quantrpeter/semiblock-junior/README.md

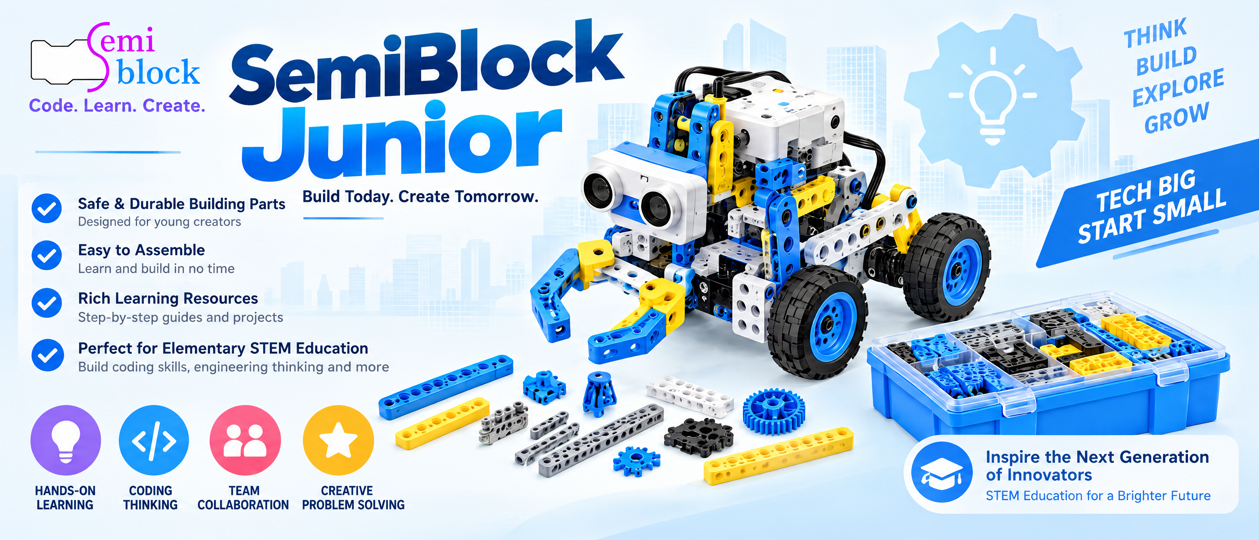
[picture p1: image/banner1.png]


Semiblock Junior is a mechanic Parts for students to build robotic devices using semiblock platform. This repo contains the idea to design the kit.
