quantrpeter/semiblock-junior/stage-2/drawings/SB-G36B.pdf

Material
材料

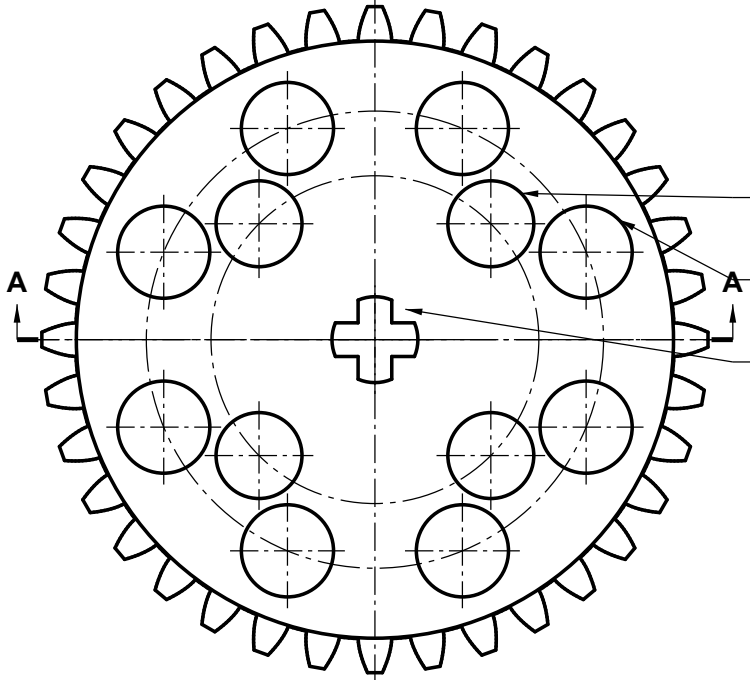
[picture p257: figure]

POM copolymer
POM 共聚甲醛

Weight
重量 | 3.82 g

Colour

颜色 | Dark grey 深灰 #5B636D | Qty / kit
每套数量 | 2
Finish 表面 | SPI B-2 光滑面 | Scale
比例 | 2.5:1

Unit

单位 | mm | Projection 投影
Status 状态 | Rev A quotation
报价及打样
| | Sheet
页 | 1 / 1

General tolerances 未注公差 (mm)
rigid ABS/POM 硬胶 | TPE 软胶
0 – 6 | ±0.05 | ±0.15 | A | First issue for quotation & samples 首次发布 · 报价及打样 | 2026-10-27
6 – 18 | ±0.08 | ±0.2
18 – 50 | ±0.12 | ±0.3 | Drawn 设计 | semiblock.ai | 2026-10-27
50 – 120 | ±0.2 | ±0.5
angles 角度 | ±0.5° | ±1°
| | | Checked 审核
◆ = critical dimension 关键尺寸
FAI 100%, Cpk ≥ 1.33

Rev
版本
Description 修改内容 | Date 日期

Approved
批准
semiblock.ai | SemiBlock Junior

Part No. 零件号

# SB-G36B

Name 名称

## Double-bevel gear 36T

## 双面锥齿轮 36齿

Dwg SB-G36B · Rev A · A3 · 3D: SB-G36B.step / .FCStd

3.9

### tip Ø37.6 ±0.05

A–A

### 8× Ø5.2 ±0.05 THRU 通孔 EQ. SP. on PCD Ø25.8 均布

### 4× Ø4.85 ±0.02 THRU 通孔 EQ. SP. on PCD Ø18.5 均布

### Axle hole 十字孔 +4.85 ±0.02 / 1.9 ±0.02 THRU 通孔 · see detail 见详图

### ISOMETRIC 轴测图 (2:1, ref.)

### Technical requirements 技术要求

1. 3D model SB-G36B.step is the master; dimensions not shown are taken from it.
以 3D 模型 SB-G36B.step 为准，未注尺寸按 3D 数据。
2. Material POM copolymer, e.g. Hostaform C 9021; colour Dark grey 深灰 (sRGB #5B 636D, std SB-C05); colour plaque approved before production.
材料：POM 共聚甲醛（C 9021 或同等）；颜色 深灰（#5B636D，色号 SB-C05），量产 前确认色板。
3. Draft ≤ 0.5° on outer walls, added by the tool maker within tolerance. Pin /
axle holes and ◆ features: draft ≤ 0.25°, ◆ size held over the full depth. 外壁拔模≤0.5°（模具厂在公差内添加）；销孔、十字孔及◆特征拔模≤0.25°，全深度保 持◆尺寸。
4. Parting line, gate and ejector marks: not on visible faces or inside holes,
flush to +0.05. Positions to be agreed in DFM.
分模线、浇口、顶针痕不得在外观面及孔内，凸起≤0.05，位置于 DFM 时确认。
5. No flash > 0.05, sink marks, short shots, silver streaks or voids. Holes free of burrs.
无大于0.05的披锋，无缩水、缺料、银纹、气泡；孔内无毛刺。
6. Unspecified edge radii R0.2–R0.35 as in 3D. No sharp edges or points (toy
safety).
未注圆角 R0.2–R0.35（按 3D），不得有锐边锐角（玩具安全）。
7. Pin holes: GO Ø4.83 / NO-GO Ø4.88 plug gauge. Fit test with SemiBlock and LEGO® Technic™ pins; push-in / pull-out force agreed at T1.
销孔用 Ø4.83 通规 / Ø4.88 止规检验；与 SemiBlock 及乐高销做装配测试，插拔力于 T 1 确认。
8. Axle (+) holes: GO gauge = cross 4.83 / 1.88. Standard axle must slide in by hand without play > 0.05.
十字孔用 4.83/1.88 十字通规；标准十字轴可手推插入，间隙≤0.05。
9. Mark cavity number and material code >POM< on a hidden face where space allows (ISO 11469).
在不可见面标注穴号及材料代码 >POM<（ISO 11469），空间不足可省略。
10. Toy safety: EN 71-1/-2/-3, ASTM F963, GB 6675.1–.4; RoHS and REACH. Supply material certificates.
玩具安全：EN 71-1/-2/-3、ASTM F963、GB 6675.1–.4；符合 RoHS、REACH，提供材 料证明。
11. ◆ = critical dimension: FAI report on every ◆ at T1 (5 pcs per cavity);
production Cpk ≥ 1.33.
◆为关键尺寸：T1 每穴 5 件全尺寸首件报告；量产 Cpk≥1.33。
12. Stage-2 drawings are for quotation, DFM review and T0/T1 samples. No mass production before written sample approval.

Gear data 齿轮参数
Module 模数 m | 1
Teeth 齿数 z | 36
Pressure angle 压力角 | 20°
Pitch Ø 分度圆 | 36
Tip Ø 齿顶圆 | 37.6
Root Ø 齿根圆 | 33.8
Tooth thickness 齿厚 | 1.47 (backlash 侧隙 0.1)
Profile 齿形 | involute, addendum 0.8m 渐开线
Bevel 锥面 | 45° double cone trim 双面45°
Accuracy 精度 | ISO 1328-1 grade 10 (proposed)

4.85 ±0.02

1.9 ±0.02

## Axle hole 十字孔 (10:1)
