quantrpeter/semiblock-junior/stage-1/renders/semikey.png

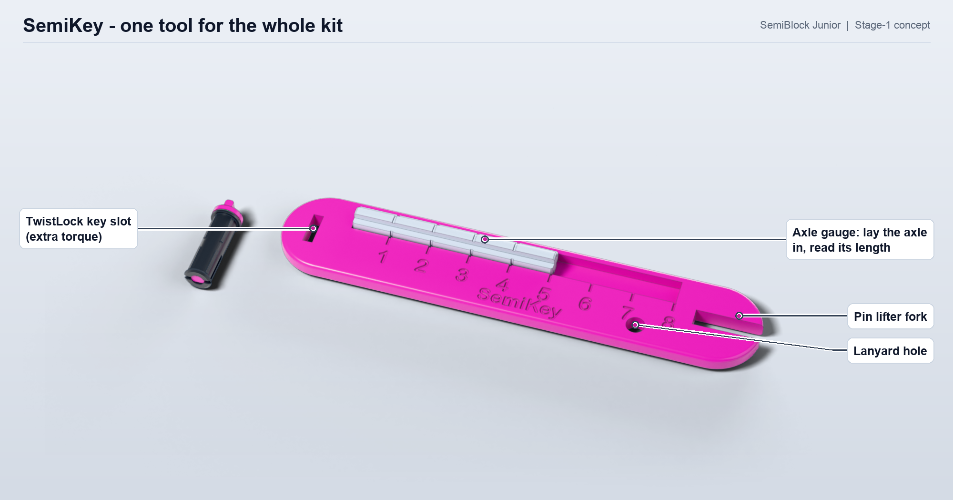
stage-1/renders/semikey.png
