quantrpeter/semiblock-junior/stage-1/renders/sheets/accessories-tools.png

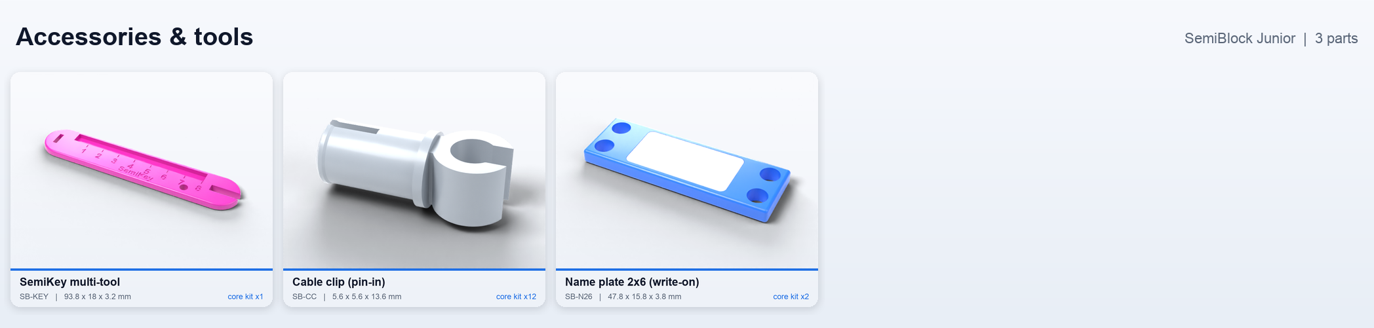
stage-1/renders/sheets/accessories-tools.png
