quantrpeter/semiblock-junior/stage-1/renders/sheets/axles.png

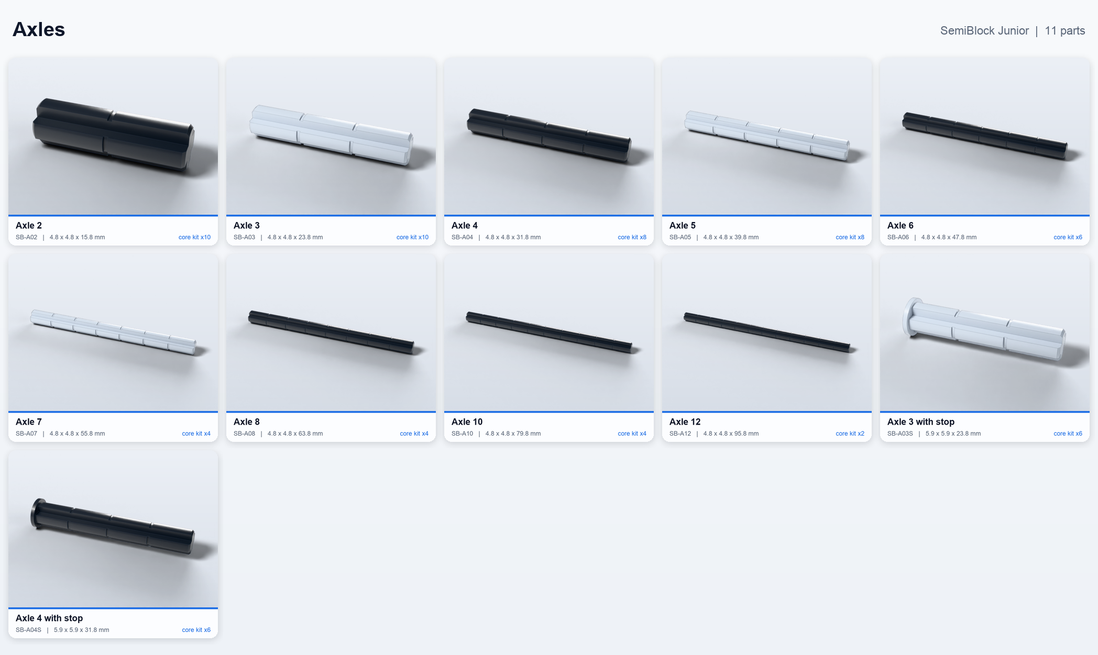
stage-1/renders/sheets/axles.png
