quantrpeter/semiblock-junior/stage-1/renders/sheets/beams.png

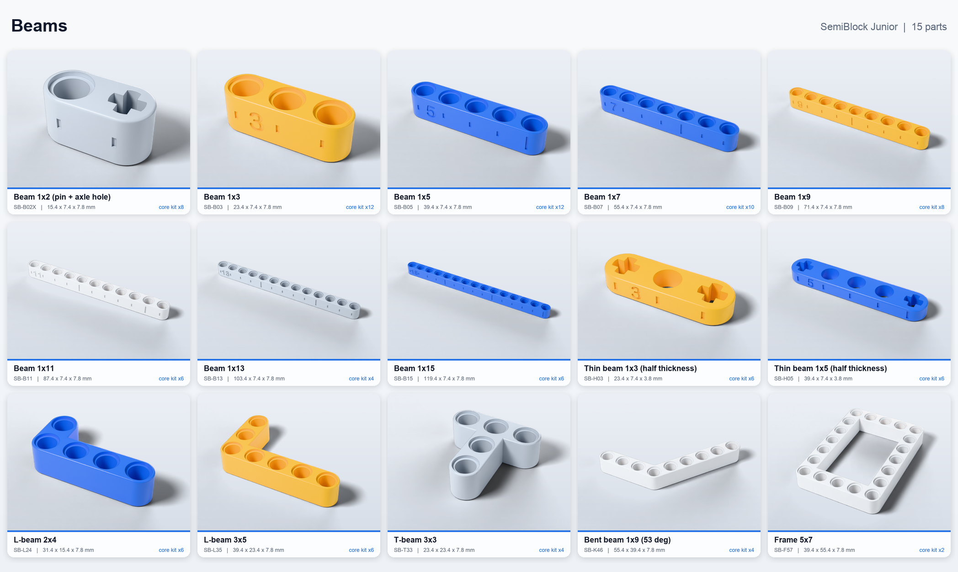
stage-1/renders/sheets/beams.png
