quantrpeter/semiblock-junior/stage-1/renders/sheets/connectors.png

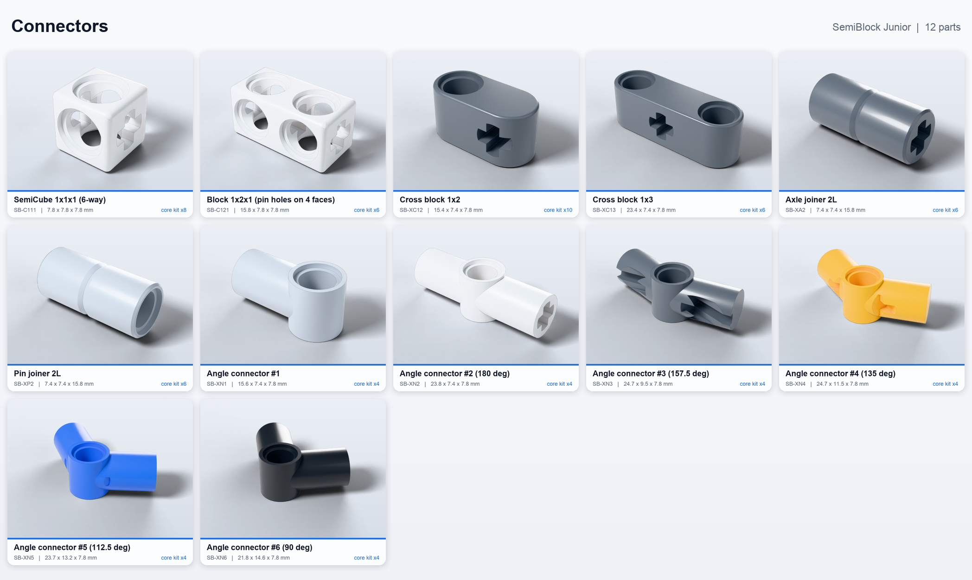
stage-1/renders/sheets/connectors.png
