quantrpeter/semiblock-junior/stage-1/renders/sheets/gears-motion.png

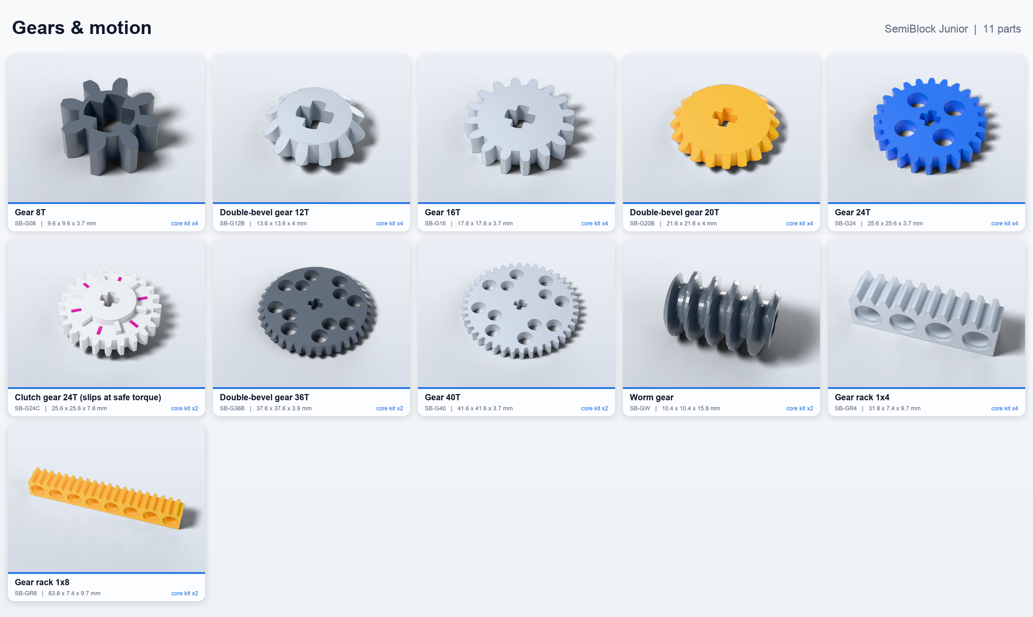
stage-1/renders/sheets/gears-motion.png
