quantrpeter/semiblock-junior/stage-1/renders/sheets/hub-motors-cables.png

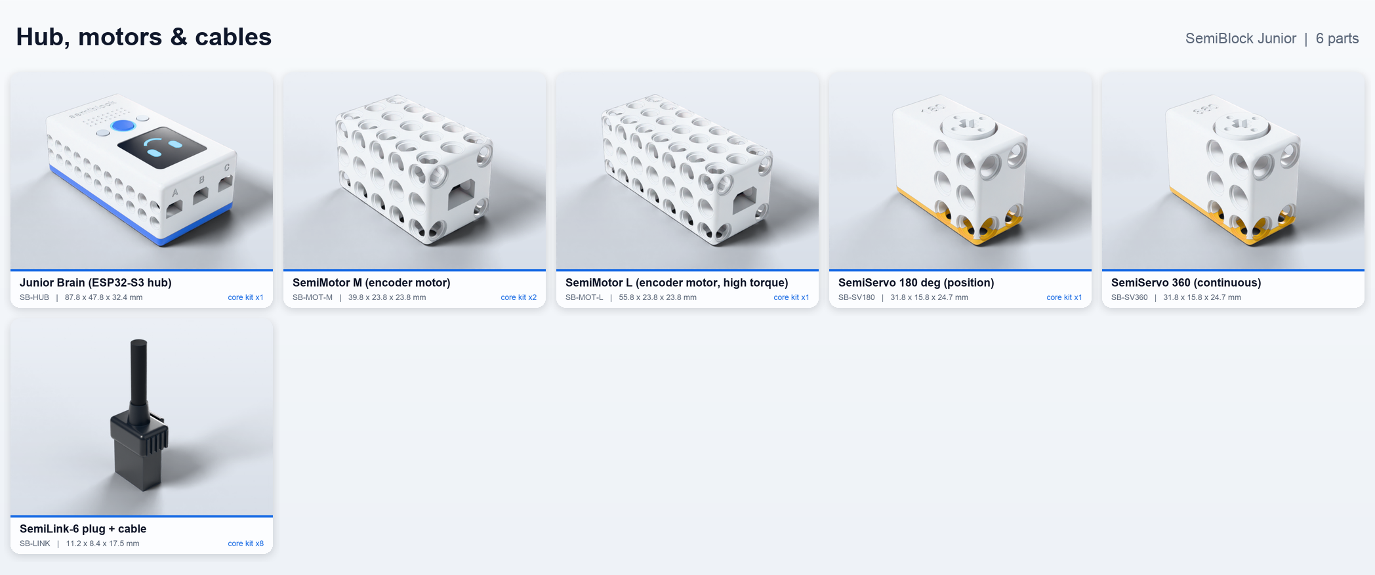
stage-1/renders/sheets/hub-motors-cables.png
