quantrpeter/semiblock-junior/stage-1/renders/sheets/modules-ai-voice.png

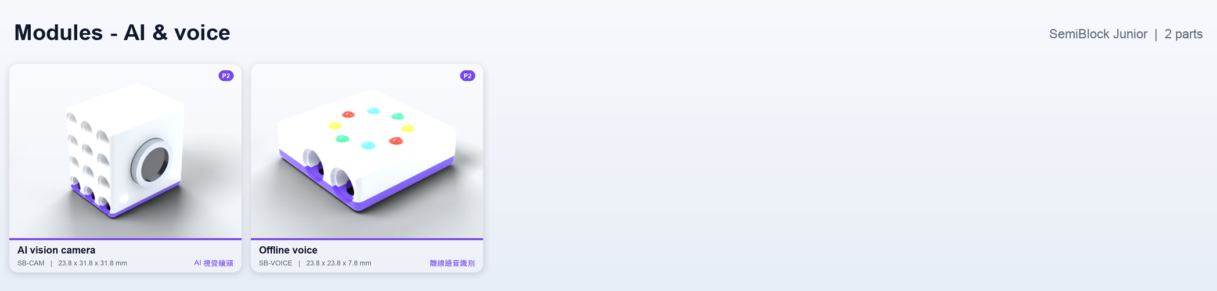
stage-1/renders/sheets/modules-ai-voice.png
