quantrpeter/semiblock-junior/stage-1/renders/sheets/modules-environment-science.png

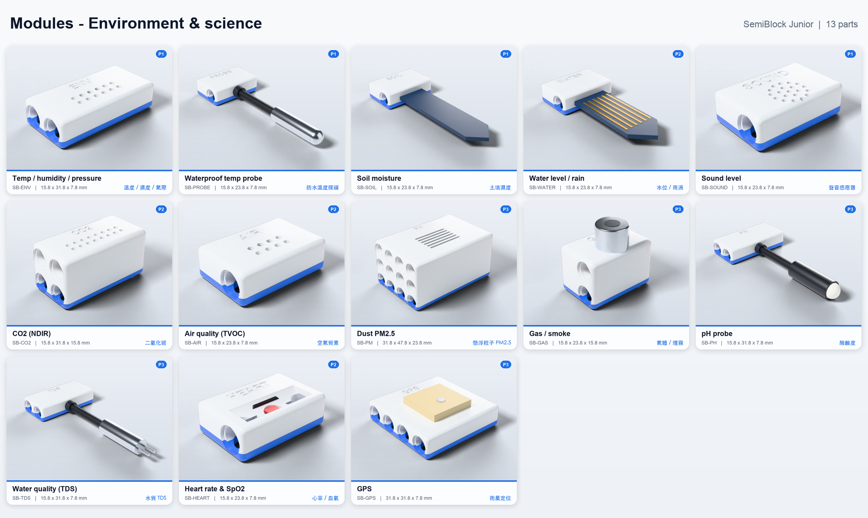
stage-1/renders/sheets/modules-environment-science.png
