quantrpeter/semiblock-junior/stage-1/renders/sheets/modules-identify-connect.png

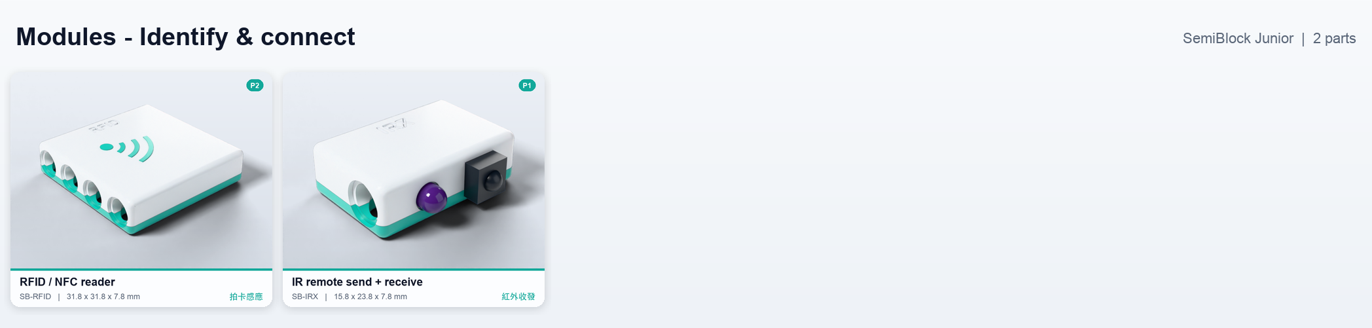
stage-1/renders/sheets/modules-identify-connect.png
