quantrpeter/semiblock-junior/stage-1/renders/sheets/modules-output.png

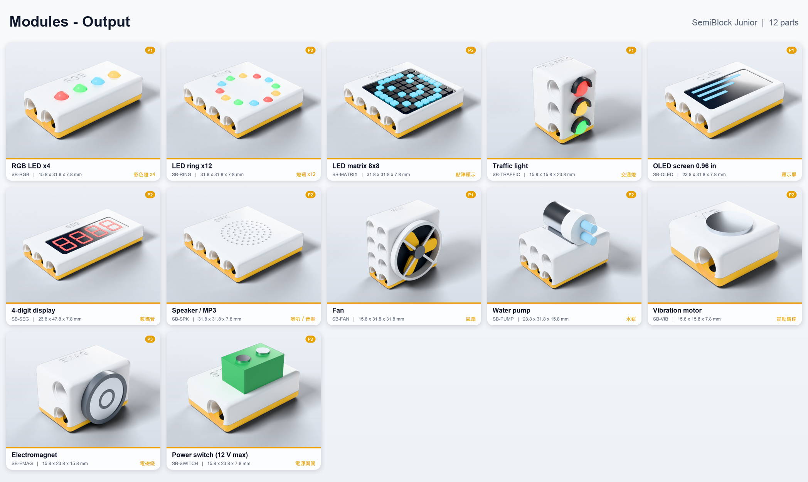
stage-1/renders/sheets/modules-output.png
