quantrpeter/semiblock-junior/stage-1/renders/sheets/modules-power-energy.png

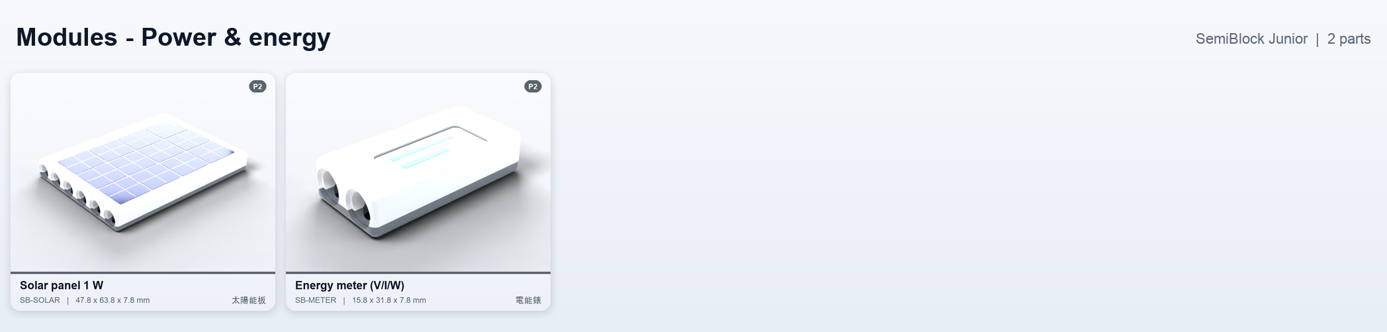
stage-1/renders/sheets/modules-power-energy.png
