quantrpeter/semiblock-junior/stage-1/renders/sheets/modules-sensing.png

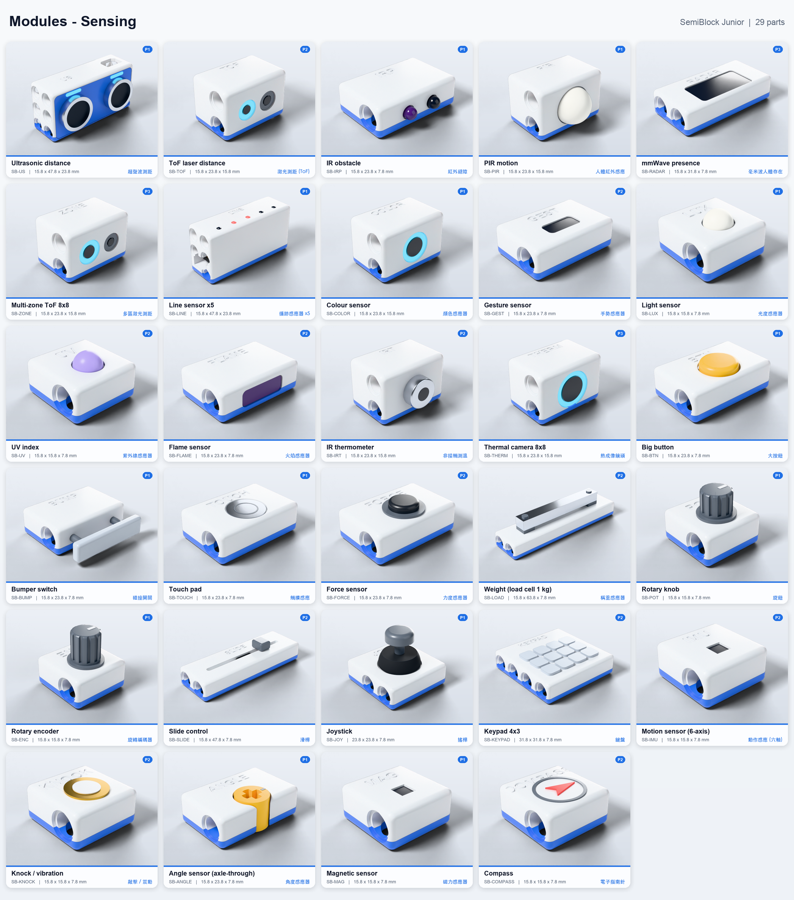
stage-1/renders/sheets/modules-sensing.png
