quantrpeter/semiblock-junior/stage-1/renders/sheets/pins-bushes.png

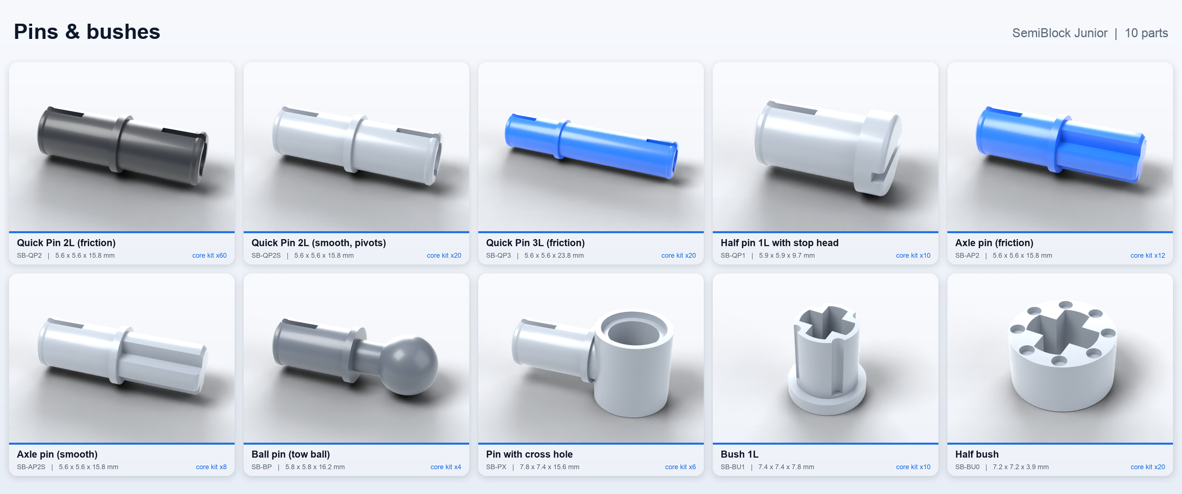
stage-1/renders/sheets/pins-bushes.png
