quantrpeter/semiblock-junior/stage-1/renders/sheets/twistlock-lock-system.png

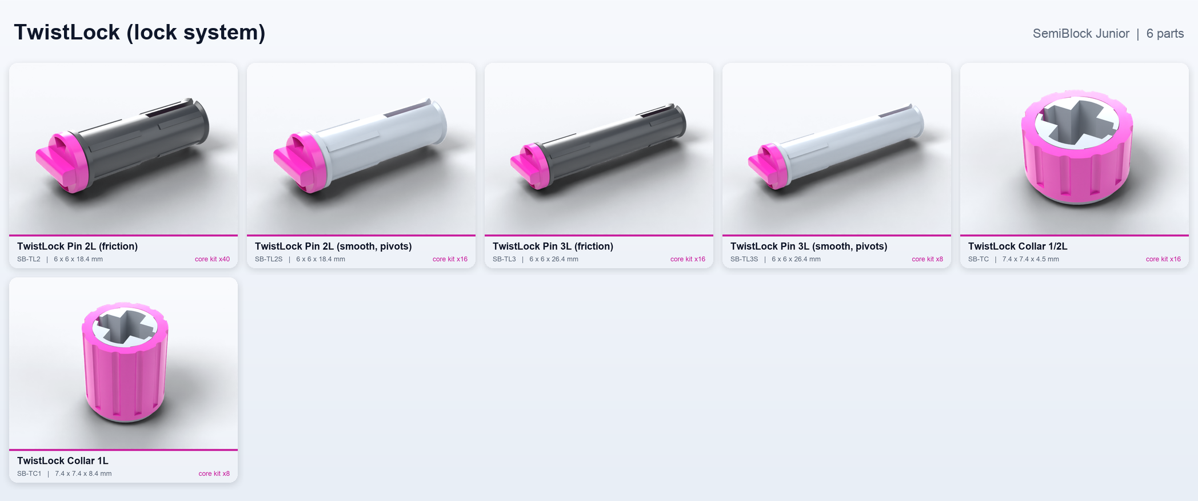
stage-1/renders/sheets/twistlock-lock-system.png
