quantrpeter/semiblock-junior/stage-1/renders/sheets/wheels.png

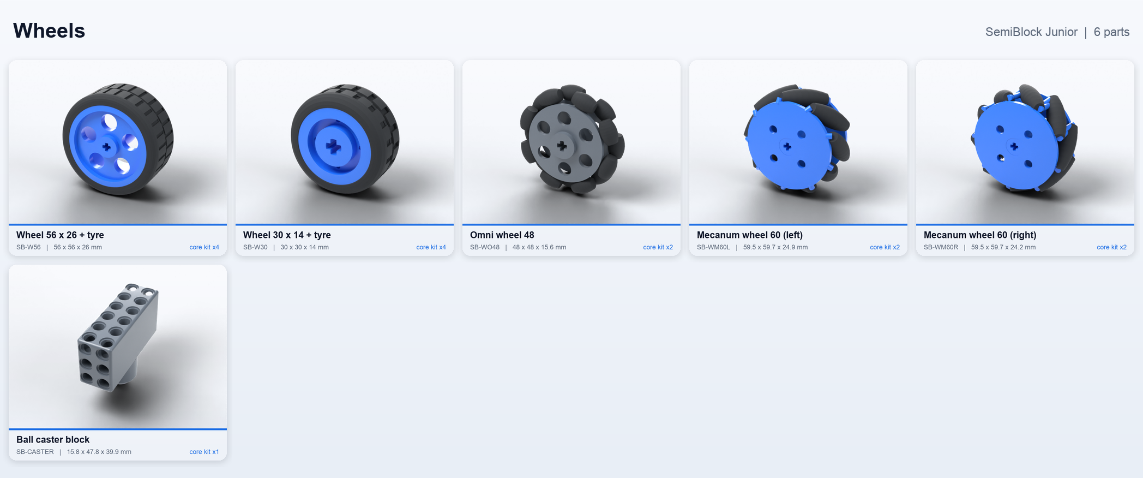
stage-1/renders/sheets/wheels.png
