quantrpeter/semiblock-junior/stage-2/renders/sheets/accessories-tools.png

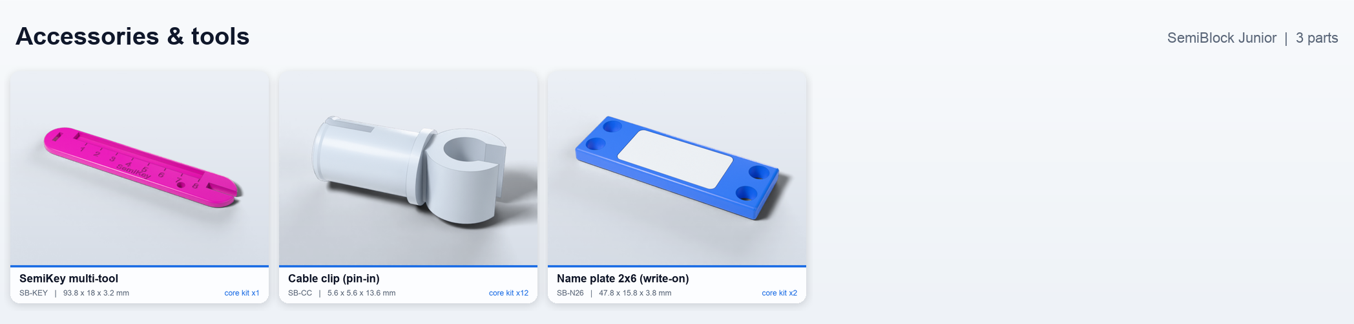
stage-2/renders/sheets/accessories-tools.png
