quantrpeter/semiblock-junior/stage-2/renders/sheets/bearings.png

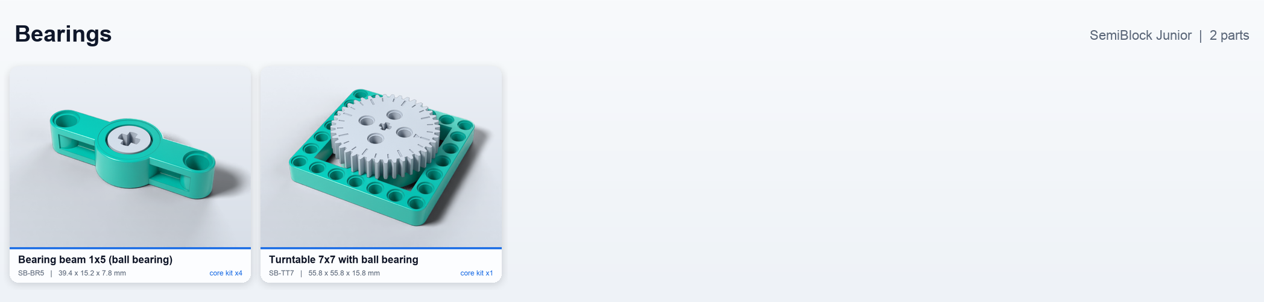
stage-2/renders/sheets/bearings.png
