quantrpeter/semiblock-junior/stage-2/renders/sheets/connectors.png

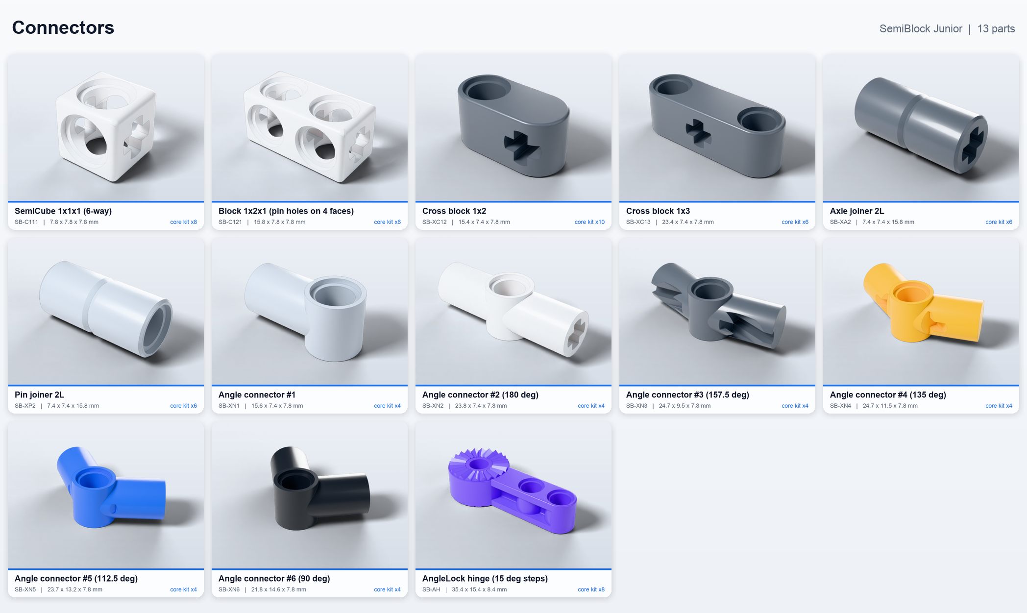
stage-2/renders/sheets/connectors.png
