quantrpeter/semiblock-junior/stage-2/renders/sheets/h-beams.png

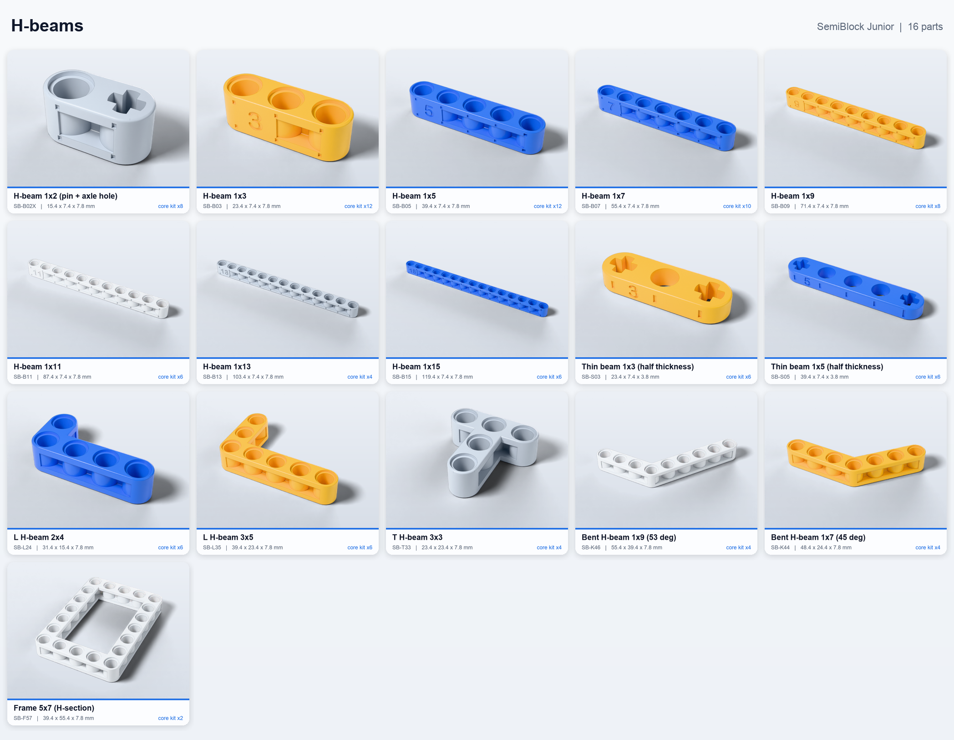
stage-2/renders/sheets/h-beams.png
