quantrpeter/semiblock-junior/stage-2/renders/sheets/modules-ai-voice.png

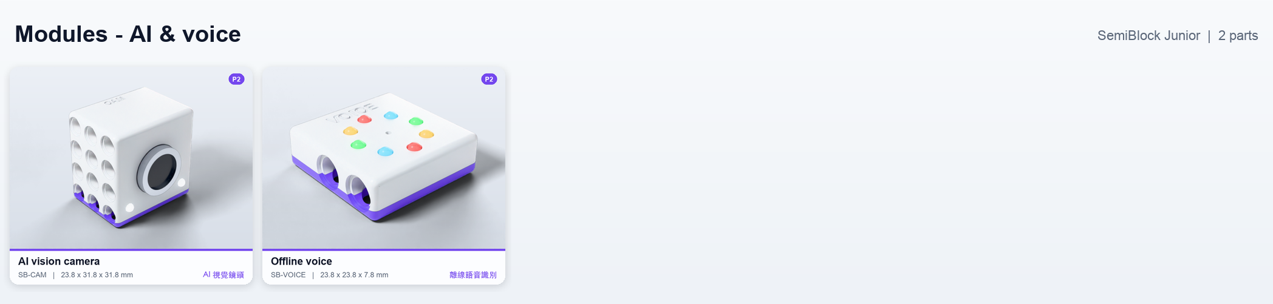
stage-2/renders/sheets/modules-ai-voice.png
