quantrpeter/semiblock-junior/stage-2/renders/sheets/modules-power-energy.png

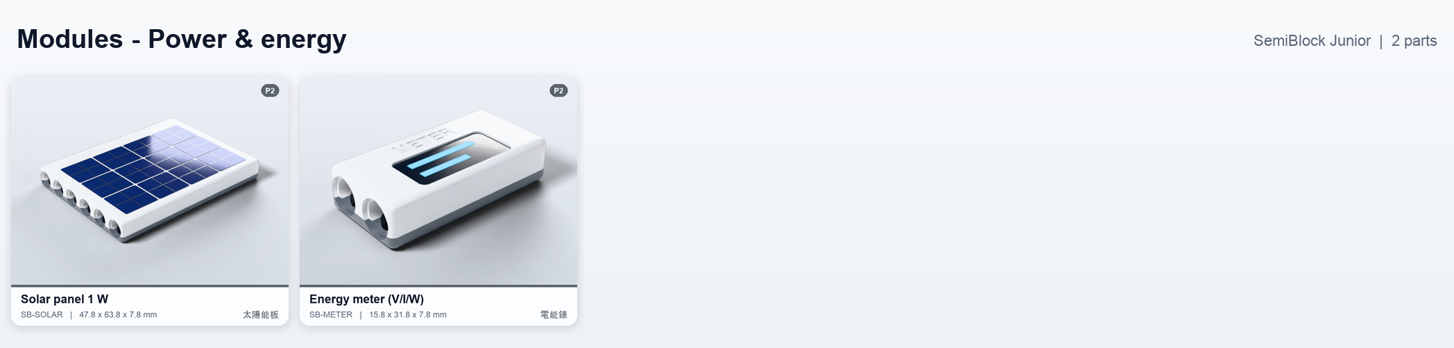
stage-2/renders/sheets/modules-power-energy.png
