quantrpeter/semiblock-junior/stage-2/renders/sheets/pins-bushes.png

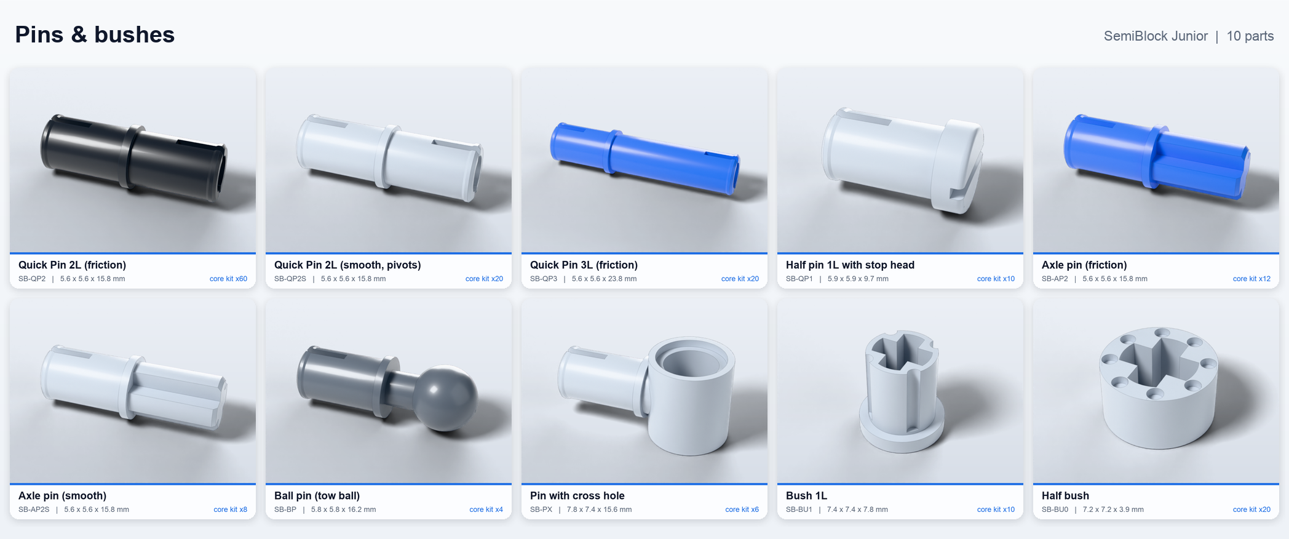
stage-2/renders/sheets/pins-bushes.png
