quantrpeter/semiblock-junior/stage-2/renders/sheets/twistlock-lock-system.png

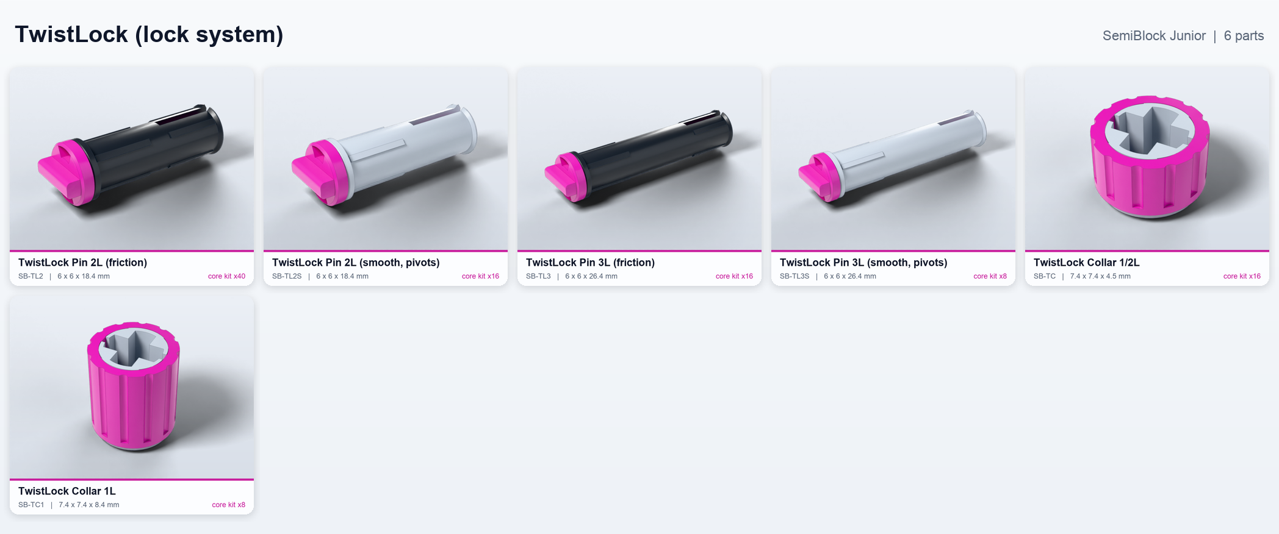
stage-2/renders/sheets/twistlock-lock-system.png
