quantrpeter/semiblock-junior/stage-2/renders/sheets/wheels.png

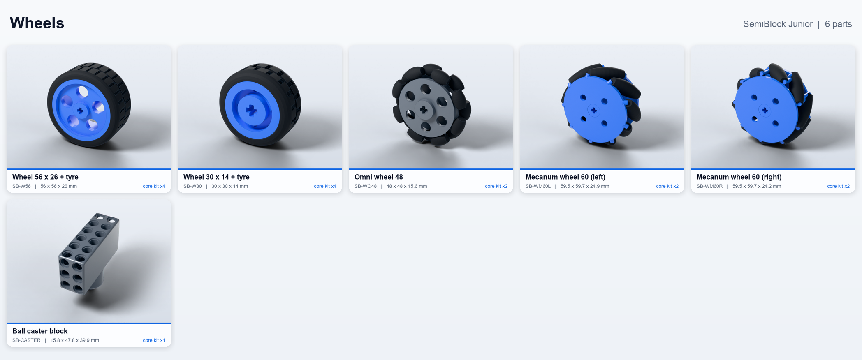
stage-2/renders/sheets/wheels.png
