quantrpeter/semiblock-junior/stage-2/drawings/SemiBlock-Junior-parts-list.csv

Part No. 零件号 | Component No. 零件编号 | Name | 名称 | Type 类型 | Material 材料 | Colour 颜色 | Colour std 色号 | Finish 表面 | Weight g 重量 | Qty per Core kit 每套数量 | Drawing 图纸 | 3D STEP | FreeCAD
SB-B02X | SB-B02X | H-beam 1x2 (pin + axle hole) | 工字孔梁 1×2（圆孔+十字孔） | injection moulded | ABS, e.g. CHIMEI PA-757 or equiv. | Light grey 浅灰 #B4BCC6 | SB-C04 | VDI 3400 Ref 18 细哑光纹理 | 0.46 | 8 | drawings/SB-B02X.pdf | cad/step/SB-B02X.step | cad/fcstd/SB-B02X.FCStd
SB-B03 | SB-B03 | H-beam 1x3 | 工字孔梁 1×3 | injection moulded | ABS, e.g. CHIMEI PA-757 or equiv. | Yellow 黄 #FFC21A | SB-C02 | VDI 3400 Ref 18 细哑光纹理 | 0.72 | 12 | drawings/SB-B03.pdf | cad/step/SB-B03.step | cad/fcstd/SB-B03.FCStd
SB-B05 | SB-B05 | H-beam 1x5 | 工字孔梁 1×5 | injection moulded | ABS, e.g. CHIMEI PA-757 or equiv. | Blue 蓝 #1F6FE5 | SB-C01 | VDI 3400 Ref 18 细哑光纹理 | 1.16 | 12 | drawings/SB-B05.pdf | cad/step/SB-B05.step | cad/fcstd/SB-B05.FCStd
SB-B07 | SB-B07 | H-beam 1x7 | 工字孔梁 1×7 | injection moulded | ABS, e.g. CHIMEI PA-757 or equiv. | Blue 蓝 #1F6FE5 | SB-C01 | VDI 3400 Ref 18 细哑光纹理 | 1.61 | 10 | drawings/SB-B07.pdf | cad/step/SB-B07.step | cad/fcstd/SB-B07.FCStd
SB-B09 | SB-B09 | H-beam 1x9 | 工字孔梁 1×9 | injection moulded | ABS, e.g. CHIMEI PA-757 or equiv. | Yellow 黄 #FFC21A | SB-C02 | VDI 3400 Ref 18 细哑光纹理 | 2.05 | 8 | drawings/SB-B09.pdf | cad/step/SB-B09.step | cad/fcstd/SB-B09.FCStd
SB-B11 | SB-B11 | H-beam 1x11 | 工字孔梁 1×11 | injection moulded | ABS, e.g. CHIMEI PA-757 or equiv. | White 白 #F2F4F7 | SB-C03 | VDI 3400 Ref 18 细哑光纹理 | 2.50 | 6 | drawings/SB-B11.pdf | cad/step/SB-B11.step | cad/fcstd/SB-B11.FCStd
SB-B13 | SB-B13 | H-beam 1x13 | 工字孔梁 1×13 | injection moulded | ABS, e.g. CHIMEI PA-757 or equiv. | Light grey 浅灰 #B4BCC6 | SB-C04 | VDI 3400 Ref 18 细哑光纹理 | 2.95 | 4 | drawings/SB-B13.pdf | cad/step/SB-B13.step | cad/fcstd/SB-B13.FCStd
SB-B15 | SB-B15 | H-beam 1x15 | 工字孔梁 1×15 | injection moulded | ABS, e.g. CHIMEI PA-757 or equiv. | Blue 蓝 #1F6FE5 | SB-C01 | VDI 3400 Ref 18 细哑光纹理 | 3.39 | 6 | drawings/SB-B15.pdf | cad/step/SB-B15.step | cad/fcstd/SB-B15.FCStd
SB-S03 | SB-S03 | Thin beam 1x3 (half thickness) | 薄孔梁 1×3（半厚） | injection moulded | ABS, e.g. CHIMEI PA-757 or equiv. | Yellow 黄 #FFC21A | SB-C02 | VDI 3400 Ref 18 细哑光纹理 | 0.45 | 6 | drawings/SB-S03.pdf | cad/step/SB-S03.step | cad/fcstd/SB-S03.FCStd
SB-S05 | SB-S05 | Thin beam 1x5 (half thickness) | 薄孔梁 1×5（半厚） | injection moulded | ABS, e.g. CHIMEI PA-757 or equiv. | Blue 蓝 #1F6FE5 | SB-C01 | VDI 3400 Ref 18 细哑光纹理 | 0.77 | 6 | drawings/SB-S05.pdf | cad/step/SB-S05.step | cad/fcstd/SB-S05.FCStd
SB-L24 | SB-L24 | L H-beam 2x4 | L形工字孔梁 2×4 | injection moulded | ABS, e.g. CHIMEI PA-757 or equiv. | Blue 蓝 #1F6FE5 | SB-C01 | VDI 3400 Ref 18 细哑光纹理 | 1.07 | 6 | drawings/SB-L24.pdf | cad/step/SB-L24.step | cad/fcstd/SB-L24.FCStd
SB-L35 | SB-L35 | L H-beam 3x5 | L形工字孔梁 3×5 | injection moulded | ABS, e.g. CHIMEI PA-757 or equiv. | Yellow 黄 #FFC21A | SB-C02 | VDI 3400 Ref 18 细哑光纹理 | 1.52 | 6 | drawings/SB-L35.pdf | cad/step/SB-L35.step | cad/fcstd/SB-L35.FCStd
SB-T33 | SB-T33 | T H-beam 3x3 | T形工字孔梁 3×3 | injection moulded | ABS, e.g. CHIMEI PA-757 or equiv. | Light grey 浅灰 #B4BCC6 | SB-C04 | VDI 3400 Ref 18 细哑光纹理 | 1.07 | 4 | drawings/SB-T33.pdf | cad/step/SB-T33.step | cad/fcstd/SB-T33.FCStd
SB-K46 | SB-K46 | Bent H-beam 1x9 (53 deg) | 弯工字孔梁 1×9（53°） | injection moulded | ABS, e.g. CHIMEI PA-757 or equiv. | White 白 #F2F4F7 | SB-C03 | VDI 3400 Ref 18 细哑光纹理 | 1.98 | 4 | drawings/SB-K46.pdf | cad/step/SB-K46.step | cad/fcstd/SB-K46.FCStd
SB-K44 | SB-K44 | Bent H-beam 1x7 (45 deg) | 弯工字孔梁 1×7（45°） | injection moulded | ABS, e.g. CHIMEI PA-757 or equiv. | Yellow 黄 #FFC21A | SB-C02 | VDI 3400 Ref 18 细哑光纹理 | 1.53 | 4 | drawings/SB-K44.pdf | cad/step/SB-K44.step | cad/fcstd/SB-K44.FCStd
SB-F57 | SB-F57 | Frame 5x7 (H-section) | 工字截面框架 5×7 | injection moulded | ABS, e.g. CHIMEI PA-757 or equiv. | White 白 #F2F4F7 | SB-C03 | VDI 3400 Ref 18 细哑光纹理 | 4.46 | 2 | drawings/SB-F57.pdf | cad/step/SB-F57.step | cad/fcstd/SB-F57.FCStd
SB-C111 | SB-C111 | SemiCube 1x1x1 (6-way) | 六向连接块 1×1×1 | injection moulded | ABS, e.g. CHIMEI PA-757 or equiv. | White 白 #F2F4F7 | SB-C03 | VDI 3400 Ref 18 细哑光纹理 | 0.19 | 8 | drawings/SB-C111.pdf | cad/step/SB-C111.step | cad/fcstd/SB-C111.FCStd
SB-C121 | SB-C121 | Block 1x2x1 (pin holes on 4 faces) | 连接块 1×2×1（四面销孔） | injection moulded | ABS, e.g. CHIMEI PA-757 or equiv. | White 白 #F2F4F7 | SB-C03 | VDI 3400 Ref 18 细哑光纹理 | 0.39 | 6 | drawings/SB-C121.pdf | cad/step/SB-C121.step | cad/fcstd/SB-C121.FCStd
SB-XC12 | SB-XC12 | Cross block 1x2 | 十字连接块 1×2 | injection moulded | ABS, e.g. CHIMEI PA-757 or equiv. | Dark grey 深灰 #5B636D | SB-C05 | VDI 3400 Ref 18 细哑光纹理 | 0.56 | 10 | drawings/SB-XC12.pdf | cad/step/SB-XC12.step | cad/fcstd/SB-XC12.FCStd
SB-XC13 | SB-XC13 | Cross block 1x3 | 十字连接块 1×3 | injection moulded | ABS, e.g. CHIMEI PA-757 or equiv. | Dark grey 深灰 #5B636D | SB-C05 | VDI 3400 Ref 18 细哑光纹理 | 0.87 | 6 | drawings/SB-XC13.pdf | cad/step/SB-XC13.step | cad/fcstd/SB-XC13.FCStd
SB-XA2 | SB-XA2 | Axle joiner 2L | 轴连接器 2L | injection moulded | ABS, e.g. CHIMEI PA-757 or equiv. | Dark grey 深灰 #5B636D | SB-C05 | VDI 3400 Ref 18 细哑光纹理 | 0.46 | 6 | drawings/SB-XA2.pdf | cad/step/SB-XA2.step | cad/fcstd/SB-XA2.FCStd
SB-XP2 | SB-XP2 | Pin joiner 2L | 销连接器 2L | injection moulded | ABS, e.g. CHIMEI PA-757 or equiv. | Light grey 浅灰 #B4BCC6 | SB-C04 | VDI 3400 Ref 18 细哑光纹理 | 0.38 | 6 | drawings/SB-XP2.pdf | cad/step/SB-XP2.step | cad/fcstd/SB-XP2.FCStd
SB-XN1 | SB-XN1 | Angle connector #1 | 角度连接器 #1 | injection moulded | ABS, e.g. CHIMEI PA-757 or equiv. | Light grey 浅灰 #B4BCC6 | SB-C04 | VDI 3400 Ref 18 细哑光纹理 | 0.53 | 4 | drawings/SB-XN1.pdf | cad/step/SB-XN1.step | cad/fcstd/SB-XN1.FCStd
SB-XN2 | SB-XN2 | Angle connector #2 (180 deg) | 角度连接器 #2（180°） | injection moulded | ABS, e.g. CHIMEI PA-757 or equiv. | White 白 #F2F4F7 | SB-C03 | VDI 3400 Ref 18 细哑光纹理 | 0.66 | 4 | drawings/SB-XN2.pdf | cad/step/SB-XN2.step | cad/fcstd/SB-XN2.FCStd
SB-XN3 | SB-XN3 | Angle connector #3 (157.5 deg) | 角度连接器 #3（157.5°） | injection moulded | ABS, e.g. CHIMEI PA-757 or equiv. | Dark grey 深灰 #5B636D | SB-C05 | VDI 3400 Ref 18 细哑光纹理 | 0.76 | 4 | drawings/SB-XN3.pdf | cad/step/SB-XN3.step | cad/fcstd/SB-XN3.FCStd
SB-XN4 | SB-XN4 | Angle connector #4 (135 deg) | 角度连接器 #4（135°） | injection moulded | ABS, e.g. CHIMEI PA-757 or equiv. | Yellow 黄 #FFC21A | SB-C02 | VDI 3400 Ref 18 细哑光纹理 | 0.87 | 4 | drawings/SB-XN4.pdf | cad/step/SB-XN4.step | cad/fcstd/SB-XN4.FCStd
SB-XN5 | SB-XN5 | Angle connector #5 (112.5 deg) | 角度连接器 #5（112.5°） | injection moulded | ABS, e.g. CHIMEI PA-757 or equiv. | Blue 蓝 #1F6FE5 | SB-C01 | VDI 3400 Ref 18 细哑光纹理 | 0.88 | 4 | drawings/SB-XN5.pdf | cad/step/SB-XN5.step | cad/fcstd/SB-XN5.FCStd
SB-XN6 | SB-XN6 | Angle connector #6 (90 deg) | 角度连接器 #6（90°） | injection moulded | ABS, e.g. CHIMEI PA-757 or equiv. | Black 黑 #24282E | SB-C06 | VDI 3400 Ref 18 细哑光纹理 | 0.88 | 4 | drawings/SB-XN6.pdf | cad/step/SB-XN6.step | cad/fcstd/SB-XN6.FCStd
SB-AH | SB-AH | AngleLock hinge (15 deg steps) | 角度铰链（15° 分度） | injection moulded | POM copolymer, e.g. Hostaform C 9021 | Violet 紫 #7447EE | SB-C09 | SPI B-2 光滑面 | 2.62 | 8 | drawings/SB-AH.pdf | cad/step/SB-AH.step | cad/fcstd/SB-AH.FCStd
SB-QP2 | SB-QP2 | Quick Pin 2L (friction) | 摩擦销 2L | injection moulded | POM copolymer, e.g. Hostaform C 9021 | Black 黑 #24282E | SB-C06 | SPI B-2 光滑面 | 0.23 | 60 | drawings/SB-QP2.pdf | cad/step/SB-QP2.step | cad/fcstd/SB-QP2.FCStd
SB-QP2S | SB-QP2S | Quick Pin 2L (smooth, pivots) | 光滑销 2L（可转动） | injection moulded | POM copolymer, e.g. Hostaform C 9021 | Light grey 浅灰 #B4BCC6 | SB-C04 | SPI B-2 光滑面 | 0.23 | 20 | drawings/SB-QP2S.pdf | cad/step/SB-QP2S.step | cad/fcstd/SB-QP2S.FCStd
SB-QP3 | SB-QP3 | Quick Pin 3L (friction) | 摩擦销 3L | injection moulded | POM copolymer, e.g. Hostaform C 9021 | Blue 蓝 #1F6FE5 | SB-C01 | SPI B-2 光滑面 | 0.35 | 20 | drawings/SB-QP3.pdf | cad/step/SB-QP3.step | cad/fcstd/SB-QP3.FCStd
SB-QP1 | SB-QP1 | Half pin 1L with stop head | 半销 1L（带挡头） | injection moulded | POM copolymer, e.g. Hostaform C 9021 | Light grey 浅灰 #B4BCC6 | SB-C04 | SPI B-2 光滑面 | 0.17 | 10 | drawings/SB-QP1.pdf | cad/step/SB-QP1.step | cad/fcstd/SB-QP1.FCStd
SB-AP2 | SB-AP2 | Axle pin (friction) | 轴销（摩擦） | injection moulded | POM copolymer, e.g. Hostaform C 9021 | Blue 蓝 #1F6FE5 | SB-C01 | SPI B-2 光滑面 | 0.28 | 12 | drawings/SB-AP2.pdf | cad/step/SB-AP2.step | cad/fcstd/SB-AP2.FCStd
SB-AP2S | SB-AP2S | Axle pin (smooth) | 轴销（光滑） | injection moulded | POM copolymer, e.g. Hostaform C 9021 | Light grey 浅灰 #B4BCC6 | SB-C04 | SPI B-2 光滑面 | 0.28 | 8 | drawings/SB-AP2S.pdf | cad/step/SB-AP2S.step | cad/fcstd/SB-AP2S.FCStd
SB-BP | SB-BP | Ball pin (tow ball) | 球头销（拖车球） | injection moulded | POM copolymer, e.g. Hostaform C 9021 | Dark grey 深灰 #5B636D | SB-C05 | SPI B-2 光滑面 | 0.31 | 4 | drawings/SB-BP.pdf | cad/step/SB-BP.step | cad/fcstd/SB-BP.FCStd
SB-PX | SB-PX | Pin with cross hole | 带十字孔销 | injection moulded | POM copolymer, e.g. Hostaform C 9021 | Light grey 浅灰 #B4BCC6 | SB-C04 | SPI B-2 光滑面 | 0.38 | 6 | drawings/SB-PX.pdf | cad/step/SB-PX.step | cad/fcstd/SB-PX.FCStd
SB-BU1 | SB-BU1 | Bush 1L | 轴套 1L | injection moulded | POM copolymer, e.g. Hostaform C 9021 | Light grey 浅灰 #B4BCC6 | SB-C04 | SPI B-2 光滑面 | 0.15 | 10 | drawings/SB-BU1.pdf | cad/step/SB-BU1.step | cad/fcstd/SB-BU1.FCStd
SB-BU0 | SB-BU0 | Half bush | 半轴套 | injection moulded | POM copolymer, e.g. Hostaform C 9021 | Light grey 浅灰 #B4BCC6 | SB-C04 | SPI B-2 光滑面 | 0.14 | 20 | drawings/SB-BU0.pdf | cad/step/SB-BU0.step | cad/fcstd/SB-BU0.FCStd
SB-TL2 | SB-TL2-01 | TwistLock Pin 2L (friction) — Sleeve | 旋锁销 2L（摩擦） — 套管 | injection moulded | POM copolymer, e.g. Hostaform C 9021 | Black 黑 #24282E | SB-C06 | SPI B-2 光滑面 | 0.28 | 40 | drawings/SB-TL2.pdf | cad/step/SB-TL2.step | cad/fcstd/SB-TL2.FCStd
SB-TL2 | SB-TL2-02 | TwistLock Pin 2L (friction) — Core | 旋锁销 2L（摩擦） — 锁芯 | injection moulded | POM copolymer, e.g. Hostaform C 9021 | Magenta 品红 #C8209E | SB-C07 | SPI B-2 光滑面 | 0.16 | 40 | drawings/SB-TL2.pdf | cad/step/SB-TL2.step | cad/fcstd/SB-TL2.FCStd
SB-TL2S | SB-TL2S-01 | TwistLock Pin 2L (smooth, pivots) — Sleeve | 旋锁销 2L（光滑，可转动） — 套管 | injection moulded | POM copolymer, e.g. Hostaform C 9021 | Light grey 浅灰 #B4BCC6 | SB-C04 | SPI B-2 光滑面 | 0.28 | 16 | drawings/SB-TL2S.pdf | cad/step/SB-TL2S.step | cad/fcstd/SB-TL2S.FCStd
SB-TL2S | SB-TL2S-02 | TwistLock Pin 2L (smooth, pivots) — Core | 旋锁销 2L（光滑，可转动） — 锁芯 | injection moulded | POM copolymer, e.g. Hostaform C 9021 | Magenta 品红 #C8209E | SB-C07 | SPI B-2 光滑面 | 0.16 | 16 | drawings/SB-TL2S.pdf | cad/step/SB-TL2S.step | cad/fcstd/SB-TL2S.FCStd
SB-TL3 | SB-TL3-01 | TwistLock Pin 3L (friction) — Sleeve | 旋锁销 3L（摩擦） — 套管 | injection moulded | POM copolymer, e.g. Hostaform C 9021 | Black 黑 #24282E | SB-C06 | SPI B-2 光滑面 | 0.42 | 16 | drawings/SB-TL3.pdf | cad/step/SB-TL3.step | cad/fcstd/SB-TL3.FCStd
SB-TL3 | SB-TL3-02 | TwistLock Pin 3L (friction) — Core | 旋锁销 3L（摩擦） — 锁芯 | injection moulded | POM copolymer, e.g. Hostaform C 9021 | Magenta 品红 #C8209E | SB-C07 | SPI B-2 光滑面 | 0.22 | 16 | drawings/SB-TL3.pdf | cad/step/SB-TL3.step | cad/fcstd/SB-TL3.FCStd
SB-TL3S | SB-TL3S-01 | TwistLock Pin 3L (smooth, pivots) — Sleeve | 旋锁销 3L（光滑，可转动） — 套管 | injection moulded | POM copolymer, e.g. Hostaform C 9021 | Light grey 浅灰 #B4BCC6 | SB-C04 | SPI B-2 光滑面 | 0.42 | 8 | drawings/SB-TL3S.pdf | cad/step/SB-TL3S.step | cad/fcstd/SB-TL3S.FCStd
SB-TL3S | SB-TL3S-02 | TwistLock Pin 3L (smooth, pivots) — Core | 旋锁销 3L（光滑，可转动） — 锁芯 | injection moulded | POM copolymer, e.g. Hostaform C 9021 | Magenta 品红 #C8209E | SB-C07 | SPI B-2 光滑面 | 0.22 | 8 | drawings/SB-TL3S.pdf | cad/step/SB-TL3S.step | cad/fcstd/SB-TL3S.FCStd
SB-TC | SB-TC-01 | TwistLock Collar 1/2L — Collet | 旋锁轴环 1/2L — 夹套 | injection moulded | POM copolymer, e.g. Hostaform C 9021 | Light grey 浅灰 #B4BCC6 | SB-C04 | SPI B-2 光滑面 | 0.07 | 16 | drawings/SB-TC.pdf | cad/step/SB-TC.step | cad/fcstd/SB-TC.FCStd
SB-TC | SB-TC-02 | TwistLock Collar 1/2L — Lock ring | 旋锁轴环 1/2L — 锁环 | injection moulded | POM copolymer, e.g. Hostaform C 9021 | Magenta 品红 #C8209E | SB-C07 | SPI B-2 光滑面 | 0.09 | 16 | drawings/SB-TC.pdf | cad/step/SB-TC.step | cad/fcstd/SB-TC.FCStd
SB-TC1 | SB-TC1-01 | TwistLock Collar 1L — Collet | 旋锁轴环 1L — 夹套 | injection moulded | POM copolymer, e.g. Hostaform C 9021 | Light grey 浅灰 #B4BCC6 | SB-C04 | SPI B-2 光滑面 | 0.13 | 8 | drawings/SB-TC1.pdf | cad/step/SB-TC1.step | cad/fcstd/SB-TC1.FCStd
SB-TC1 | SB-TC1-02 | TwistLock Collar 1L — Lock ring | 旋锁轴环 1L — 锁环 | injection moulded | POM copolymer, e.g. Hostaform C 9021 | Magenta 品红 #C8209E | SB-C07 | SPI B-2 光滑面 | 0.18 | 8 | drawings/SB-TC1.pdf | cad/step/SB-TC1.step | cad/fcstd/SB-TC1.FCStd
SB-A02 | SB-A02 | Axle 2 | 十字轴 2 | injection moulded | POM copolymer, e.g. Hostaform C 9021 | Black 黑 #24282E | SB-C06 | SPI B-2 光滑面 | 0.30 | 10 | drawings/SB-A02.pdf | cad/step/SB-A02.step | cad/fcstd/SB-A02.FCStd
SB-A03 | SB-A03 | Axle 3 | 十字轴 3 | injection moulded | POM copolymer, e.g. Hostaform C 9021 | Light grey 浅灰 #B4BCC6 | SB-C04 | SPI B-2 光滑面 | 0.45 | 10 | drawings/SB-A03.pdf | cad/step/SB-A03.step | cad/fcstd/SB-A03.FCStd
SB-A04 | SB-A04 | Axle 4 | 十字轴 4 | injection moulded | POM copolymer, e.g. Hostaform C 9021 | Black 黑 #24282E | SB-C06 | SPI B-2 光滑面 | 0.60 | 8 | drawings/SB-A04.pdf | cad/step/SB-A04.step | cad/fcstd/SB-A04.FCStd
SB-A05 | SB-A05 | Axle 5 | 十字轴 5 | injection moulded | POM copolymer, e.g. Hostaform C 9021 | Light grey 浅灰 #B4BCC6 | SB-C04 | SPI B-2 光滑面 | 0.75 | 8 | drawings/SB-A05.pdf | cad/step/SB-A05.step | cad/fcstd/SB-A05.FCStd
SB-A06 | SB-A06 | Axle 6 | 十字轴 6 | injection moulded | POM copolymer, e.g. Hostaform C 9021 | Black 黑 #24282E | SB-C06 | SPI B-2 光滑面 | 0.90 | 6 | drawings/SB-A06.pdf | cad/step/SB-A06.step | cad/fcstd/SB-A06.FCStd
SB-A07 | SB-A07 | Axle 7 | 十字轴 7 | injection moulded | POM copolymer, e.g. Hostaform C 9021 | Light grey 浅灰 #B4BCC6 | SB-C04 | SPI B-2 光滑面 | 1.05 | 4 | drawings/SB-A07.pdf | cad/step/SB-A07.step | cad/fcstd/SB-A07.FCStd
SB-A08 | SB-A08 | Axle 8 | 十字轴 8 | injection moulded | POM copolymer, e.g. Hostaform C 9021 | Black 黑 #24282E | SB-C06 | SPI B-2 光滑面 | 1.20 | 4 | drawings/SB-A08.pdf | cad/step/SB-A08.step | cad/fcstd/SB-A08.FCStd
SB-A10 | SB-A10 | Axle 10 | 十字轴 10 | injection moulded | POM copolymer, e.g. Hostaform C 9021 | Black 黑 #24282E | SB-C06 | SPI B-2 光滑面 | 1.50 | 4 | drawings/SB-A10.pdf | cad/step/SB-A10.step | cad/fcstd/SB-A10.FCStd
SB-A12 | SB-A12 | Axle 12 | 十字轴 12 | injection moulded | POM copolymer, e.g. Hostaform C 9021 | Black 黑 #24282E | SB-C06 | SPI B-2 光滑面 | 1.80 | 2 | drawings/SB-A12.pdf | cad/step/SB-A12.step | cad/fcstd/SB-A12.FCStd
SB-A03S | SB-A03S | Axle 3 with stop | 带挡十字轴 3 | injection moulded | POM copolymer, e.g. Hostaform C 9021 | Light grey 浅灰 #B4BCC6 | SB-C04 | SPI B-2 光滑面 | 0.46 | 6 | drawings/SB-A03S.pdf | cad/step/SB-A03S.step | cad/fcstd/SB-A03S.FCStd
SB-A04S | SB-A04S | Axle 4 with stop | 带挡十字轴 4 | injection moulded | POM copolymer, e.g. Hostaform C 9021 | Black 黑 #24282E | SB-C06 | SPI B-2 光滑面 | 0.61 | 6 | drawings/SB-A04S.pdf | cad/step/SB-A04S.step | cad/fcstd/SB-A04S.FCStd
SB-G08 | SB-G08 | Gear 8T | 直齿轮 8齿 | injection moulded | POM copolymer, e.g. Hostaform C 9021 | Dark grey 深灰 #5B636D | SB-C05 | SPI B-2 光滑面 | 0.16 | 4 | drawings/SB-G08.pdf | cad/step/SB-G08.step | cad/fcstd/SB-G08.FCStd
SB-G12B | SB-G12B | Double-bevel gear 12T | 双面锥齿轮 12齿 | injection moulded | POM copolymer, e.g. Hostaform C 9021 | Light grey 浅灰 #B4BCC6 | SB-C04 | SPI B-2 光滑面 | 0.43 | 4 | drawings/SB-G12B.pdf | cad/step/SB-G12B.step | cad/fcstd/SB-G12B.FCStd
SB-G16 | SB-G16 | Gear 16T | 直齿轮 16齿 | injection moulded | POM copolymer, e.g. Hostaform C 9021 | Light grey 浅灰 #B4BCC6 | SB-C04 | SPI B-2 光滑面 | 0.93 | 4 | drawings/SB-G16.pdf | cad/step/SB-G16.step | cad/fcstd/SB-G16.FCStd
SB-G20B | SB-G20B | Double-bevel gear 20T | 双面锥齿轮 20齿 | injection moulded | POM copolymer, e.g. Hostaform C 9021 | Yellow 黄 #FFC21A | SB-C02 | SPI B-2 光滑面 | 1.48 | 4 | drawings/SB-G20B.pdf | cad/step/SB-G20B.step | cad/fcstd/SB-G20B.FCStd
SB-G24 | SB-G24 | Gear 24T | 直齿轮 24齿 | injection moulded | POM copolymer, e.g. Hostaform C 9021 | Blue 蓝 #1F6FE5 | SB-C01 | SPI B-2 光滑面 | 1.83 | 4 | drawings/SB-G24.pdf | cad/step/SB-G24.step | cad/fcstd/SB-G24.FCStd
SB-G24C | SB-G24C | Clutch gear 24T (slips at safe torque) | 离合齿轮 24齿（过载打滑） | injection moulded | POM copolymer, e.g. Hostaform C 9021 | White 白 #F2F4F7 | SB-C03 | SPI B-2 光滑面 | 2.99 | 2 | drawings/SB-G24C.pdf | cad/step/SB-G24C.step | cad/fcstd/SB-G24C.FCStd
SB-G36B | SB-G36B | Double-bevel gear 36T | 双面锥齿轮 36齿 | injection moulded | POM copolymer, e.g. Hostaform C 9021 | Dark grey 深灰 #5B636D | SB-C05 | SPI B-2 光滑面 | 3.82 | 2 | drawings/SB-G36B.pdf | cad/step/SB-G36B.step | cad/fcstd/SB-G36B.FCStd
SB-G40 | SB-G40 | Gear 40T | 直齿轮 40齿 | injection moulded | POM copolymer, e.g. Hostaform C 9021 | Light grey 浅灰 #B4BCC6 | SB-C04 | SPI B-2 光滑面 | 5.10 | 2 | drawings/SB-G40.pdf | cad/step/SB-G40.step | cad/fcstd/SB-G40.FCStd
SB-GW | SB-GW | Worm gear | 蜗杆 | injection moulded | POM copolymer, e.g. Hostaform C 9021 | Dark grey 深灰 #5B636D | SB-C05 | SPI B-2 光滑面 | 0.87 | 2 | drawings/SB-GW.pdf | cad/step/SB-GW.step | cad/fcstd/SB-GW.FCStd
SB-GR4 | SB-GR4 | Gear rack 1x4 | 齿条 1×4 | injection moulded | POM copolymer, e.g. Hostaform C 9021 | Light grey 浅灰 #B4BCC6 | SB-C04 | SPI B-2 光滑面 | 2.02 | 4 | drawings/SB-GR4.pdf | cad/step/SB-GR4.step | cad/fcstd/SB-GR4.FCStd
SB-GR8 | SB-GR8 | Gear rack 1x8 | 齿条 1×8 | injection moulded | POM copolymer, e.g. Hostaform C 9021 | Yellow 黄 #FFC21A | SB-C02 | SPI B-2 光滑面 | 4.06 | 2 | drawings/SB-GR8.pdf | cad/step/SB-GR8.step | cad/fcstd/SB-GR8.FCStd
SB-BR5 | SB-BR5-01 | Bearing beam 1x5 (ball bearing) — Bearing housing | 轴承梁 1×5（滚珠轴承） — 轴承座 | injection moulded | PA66-GF30, e.g. Zytel 70G30 or equiv. | Teal 青绿 #12A89A | SB-C08 | VDI 3400 Ref 21 细哑光纹理 | 1.76 | 4 | drawings/SB-BR5.pdf | cad/step/SB-BR5.step | cad/fcstd/SB-BR5.FCStd
SB-BR5 | SB-BR5-02 | Bearing beam 1x5 (ball bearing) — Axle hub | 轴承梁 1×5（滚珠轴承） — 十字轴芯 | injection moulded | POM copolymer, e.g. Hostaform C 9021 | Light grey 浅灰 #B4BCC6 | SB-C04 | SPI B-2 光滑面 | 0.42 | 4 | drawings/SB-BR5.pdf | cad/step/SB-BR5.step | cad/fcstd/SB-BR5.FCStd
SB-BR5 | SB-BR5-03 | Bearing beam 1x5 (ball bearing) — Retainer ring | 轴承梁 1×5（滚珠轴承） — 压圈 | injection moulded | POM copolymer, e.g. Hostaform C 9021 | Teal 青绿 #12A89A | SB-C08 | SPI B-2 光滑面 | 0.08 | 4 | drawings/SB-BR5.pdf | cad/step/SB-BR5.step | cad/fcstd/SB-BR5.FCStd
SB-BR5 | purchased | Bearing beam 1x5 (ball bearing) — Bearing MR128ZZ | 轴承梁 1×5（滚珠轴承） — 轴承 | purchased part | Chrome steel GCr15 (purchased) | Bright steel 本色 #C9CED6 | — | polished 抛光 | 1.64 | 4 | drawings/SB-BR5.pdf | cad/step/SB-BR5.step | cad/fcstd/SB-BR5.FCStd
SB-TT7 | SB-TT7-01 | Turntable 7x7 with ball bearing — Base | 转盘 7×7（滚珠轴承） — 底座 | injection moulded | PA66-GF30, e.g. Zytel 70G30 or equiv. | Teal 青绿 #12A89A | SB-C08 | VDI 3400 Ref 21 细哑光纹理 | 14.39 | 1 | drawings/SB-TT7.pdf | cad/step/SB-TT7.step | cad/fcstd/SB-TT7.FCStd
SB-TT7 | SB-TT7-02 | Turntable 7x7 with ball bearing — Rotor 40T | 转盘 7×7（滚珠轴承） — 转盘齿圈 40齿 | injection moulded | POM copolymer, e.g. Hostaform C 9021 | Light grey 浅灰 #B4BCC6 | SB-C04 | SPI B-2 光滑面 | 13.45 | 1 | drawings/SB-TT7.pdf | cad/step/SB-TT7.step | cad/fcstd/SB-TT7.FCStd
SB-TT7 | SB-TT7-03 | Turntable 7x7 with ball bearing — Retainer ring | 转盘 7×7（滚珠轴承） — 压圈 | injection moulded | POM copolymer, e.g. Hostaform C 9021 | Teal 青绿 #12A89A | SB-C08 | SPI B-2 光滑面 | 0.17 | 1 | drawings/SB-TT7.pdf | cad/step/SB-TT7.step | cad/fcstd/SB-TT7.FCStd
SB-TT7 | purchased | Turntable 7x7 with ball bearing — Bearing 6705ZZ | 转盘 7×7（滚珠轴承） — 轴承 | purchased part | Chrome steel GCr15 (purchased) | Bright steel 本色 #C9CED6 | — | polished 抛光 | 9.41 | 1 | drawings/SB-TT7.pdf | cad/step/SB-TT7.step | cad/fcstd/SB-TT7.FCStd
SB-W56 | SB-W56-01 | Wheel 56 x 26 + tyre — Hub | 车轮 56×26（含轮胎） — 轮毂 | injection moulded | ABS, e.g. CHIMEI PA-757 or equiv. | Blue 蓝 #1F6FE5 | SB-C01 | VDI 3400 Ref 18 细哑光纹理 | 13.35 | 4 | drawings/SB-W56.pdf | cad/step/SB-W56.step | cad/fcstd/SB-W56.FCStd
SB-W56 | SB-W56-02 | Wheel 56 x 26 + tyre — Tyre | 车轮 56×26（含轮胎） — 轮胎 | injection moulded | TPE, Shore A 65 ±5 | Black 黑 #1C1F23 | SB-C10 | VDI 3400 Ref 27 哑光纹理 | 27.64 | 4 | drawings/SB-W56.pdf | cad/step/SB-W56.step | cad/fcstd/SB-W56.FCStd
SB-W30 | SB-W30-01 | Wheel 30 x 14 + tyre — Hub | 车轮 30×14（含轮胎） — 轮毂 | injection moulded | ABS, e.g. CHIMEI PA-757 or equiv. | Blue 蓝 #1F6FE5 | SB-C01 | VDI 3400 Ref 18 细哑光纹理 | 3.46 | 4 | drawings/SB-W30.pdf | cad/step/SB-W30.step | cad/fcstd/SB-W30.FCStd
SB-W30 | SB-W30-02 | Wheel 30 x 14 + tyre — Tyre | 车轮 30×14（含轮胎） — 轮胎 | injection moulded | TPE, Shore A 65 ±5 | Black 黑 #1C1F23 | SB-C10 | VDI 3400 Ref 27 哑光纹理 | 5.03 | 4 | drawings/SB-W30.pdf | cad/step/SB-W30.step | cad/fcstd/SB-W30.FCStd
SB-WO48 | SB-WO48-01 | Omni wheel 48 — Hub | 全向轮 48 — 轮毂 | injection moulded | ABS, e.g. CHIMEI PA-757 or equiv. | Dark grey 深灰 #5B636D | SB-C05 | VDI 3400 Ref 18 细哑光纹理 | 4.28 | 2 | drawings/SB-WO48.pdf | cad/step/SB-WO48.step | cad/fcstd/SB-WO48.FCStd
SB-WO48 | SB-WO48-02 | Omni wheel 48 — Roller | 全向轮 48 — 滚轮 | injection moulded | TPU, Shore A 85 ±5 | Black 黑 #1C1F23 | SB-C10 | VDI 3400 Ref 24 哑光纹理 | 0.39 | 32 | drawings/SB-WO48.pdf | cad/step/SB-WO48.step | cad/fcstd/SB-WO48.FCStd
SB-WM60L | SB-WM60L-01 | Mecanum wheel 60 (left) — Hub | 麦克纳姆轮 60（左） — 轮毂 | injection moulded | ABS, e.g. CHIMEI PA-757 or equiv. | Blue 蓝 #1F6FE5 | SB-C01 | VDI 3400 Ref 18 细哑光纹理 | 11.06 | 2 | drawings/SB-WM60L.pdf | cad/step/SB-WM60L.step | cad/fcstd/SB-WM60L.FCStd
SB-WM60L | SB-WM60L-02 | Mecanum wheel 60 (left) — Roller | 麦克纳姆轮 60（左） — 滚轮 | injection moulded | TPU, Shore A 85 ±5 | Black 黑 #1C1F23 | SB-C10 | VDI 3400 Ref 24 哑光纹理 | 1.98 | 18 | drawings/SB-WM60L.pdf | cad/step/SB-WM60L.step | cad/fcstd/SB-WM60L.FCStd
SB-WM60R | SB-WM60R-01 | Mecanum wheel 60 (right) — Hub | 麦克纳姆轮 60（右） — 轮毂 | injection moulded | ABS, e.g. CHIMEI PA-757 or equiv. | Blue 蓝 #1F6FE5 | SB-C01 | VDI 3400 Ref 18 细哑光纹理 | 13.45 | 2 | drawings/SB-WM60R.pdf | cad/step/SB-WM60R.step | cad/fcstd/SB-WM60R.FCStd
SB-WM60R | SB-WM60R-02 | Mecanum wheel 60 (right) — Roller | 麦克纳姆轮 60（右） — 滚轮 | injection moulded | TPU, Shore A 85 ±5 | Black 黑 #1C1F23 | SB-C10 | VDI 3400 Ref 24 哑光纹理 | 1.98 | 18 | drawings/SB-WM60R.pdf | cad/step/SB-WM60R.step | cad/fcstd/SB-WM60R.FCStd
SB-CASTER | SB-CASTER-01 | Ball caster block — Housing | 万向球座 — 球座 | injection moulded | ABS, e.g. CHIMEI PA-757 or equiv. | Dark grey 深灰 #5B636D | SB-C05 | VDI 3400 Ref 18 细哑光纹理 | 16.55 | 1 | drawings/SB-CASTER.pdf | cad/step/SB-CASTER.step | cad/fcstd/SB-CASTER.FCStd
SB-CASTER | purchased | Ball caster block — Steel ball | 万向球座 — 钢球 | purchased part | Chrome steel GCr15 (purchased) | Bright steel 本色 #C9CED6 | — | polished 抛光 | 9.03 | 1 | drawings/SB-CASTER.pdf | cad/step/SB-CASTER.step | cad/fcstd/SB-CASTER.FCStd
SB-KEY | SB-KEY | SemiKey multi-tool | SemiKey 多功能工具 | injection moulded | ABS, e.g. CHIMEI PA-757 or equiv. | Magenta 品红 #C8209E | SB-C07 | VDI 3400 Ref 18 细哑光纹理 | 4.37 | 1 | drawings/SB-KEY.pdf | cad/step/SB-KEY.step | cad/fcstd/SB-KEY.FCStd
SB-CC | SB-CC | Cable clip (pin-in) | 线夹（插销式） | injection moulded | POM copolymer, e.g. Hostaform C 9021 | Light grey 浅灰 #B4BCC6 | SB-C04 | SPI B-2 光滑面 | 0.22 | 12 | drawings/SB-CC.pdf | cad/step/SB-CC.step | cad/fcstd/SB-CC.FCStd
SB-N26 | SB-N26 | Name plate 2x6 (write-on) | 名牌 2×6（可书写） | injection moulded | ABS, e.g. CHIMEI PA-757 or equiv. | Blue 蓝 #1F6FE5 | SB-C01 | VDI 3400 Ref 18 细哑光纹理 | 2.54 | 2 | drawings/SB-N26.pdf | cad/step/SB-N26.step | cad/fcstd/SB-N26.FCStd
SB-HUB | SB-HUB | Junior Brain (ESP32-S3 hub) | 主控盒 Junior Brain（ESP32-S3） | electronic module (outline drawing) | PC/ABS, UL94 V-0 | Blue / White | SB-C01 / SB-C03 | VDI 3400 Ref 18 细哑光纹理 | 131.9 | 1 | drawings/SB-HUB.pdf | cad/step/SB-HUB.step | cad/fcstd/SB-HUB.FCStd
SB-MOT-M | SB-MOT-M | SemiMotor M (encoder motor) | 编码电机 M | electronic module (outline drawing) | PC/ABS, UL94 V-0 | White | SB-C03 | VDI 3400 Ref 18 细哑光纹理 | 16.5 | 2 | drawings/SB-MOT-M.pdf | cad/step/SB-MOT-M.step | cad/fcstd/SB-MOT-M.FCStd
SB-MOT-L | SB-MOT-L | SemiMotor L (encoder motor, high torque) | 编码电机 L（大扭矩） | electronic module (outline drawing) | PC/ABS, UL94 V-0 | White | SB-C03 | VDI 3400 Ref 18 细哑光纹理 | 23.4 | 1 | drawings/SB-MOT-L.pdf | cad/step/SB-MOT-L.step | cad/fcstd/SB-MOT-L.FCStd
SB-SV180 | SB-SV180 | SemiServo 180 deg (position) | 舵机 180° | electronic module (outline drawing) | PC/ABS, UL94 V-0 | Yellow / White | SB-C02 / SB-C03 | VDI 3400 Ref 18 细哑光纹理 | 10.4 | 1 | drawings/SB-SV180.pdf | cad/step/SB-SV180.step | cad/fcstd/SB-SV180.FCStd
SB-SV360 | SB-SV360 | SemiServo 360 (continuous) | 360° 连续旋转舵机 | electronic module (outline drawing) | PC/ABS, UL94 V-0 | Yellow / White | SB-C02 / SB-C03 | VDI 3400 Ref 18 细哑光纹理 | 10.4 |  | drawings/SB-SV360.pdf | cad/step/SB-SV360.step | cad/fcstd/SB-SV360.FCStd
SB-LINK | SB-LINK | SemiLink-6 plug + cable | SemiLink-6 插头及线缆 | electronic module (outline drawing) | ABS, e.g. CHIMEI PA-757 or equiv. | Black | SB-C06 | VDI 3400 Ref 18 细哑光纹理 | 0.9 | 8 | drawings/SB-LINK.pdf | cad/step/SB-LINK.step | cad/fcstd/SB-LINK.FCStd
SB-US | SB-US | Ultrasonic distance | 超声波测距模块 | electronic module (outline drawing) | ABS, e.g. CHIMEI PA-757 or equiv. | Blue / White | SB-C01 / SB-C03 | VDI 3400 Ref 18 细哑光纹理 | 11.0 | 1 | drawings/SB-US.pdf | cad/step/SB-US.step | cad/fcstd/SB-US.FCStd
SB-TOF | SB-TOF | ToF laser distance | 激光测距模块（ToF） | electronic module (outline drawing) | ABS, e.g. CHIMEI PA-757 or equiv. | Blue / White | SB-C01 / SB-C03 | VDI 3400 Ref 18 细哑光纹理 | 4.5 |  | drawings/SB-TOF.pdf | cad/step/SB-TOF.step | cad/fcstd/SB-TOF.FCStd
SB-IRP | SB-IRP | IR obstacle | 红外避障模块 | electronic module (outline drawing) | ABS, e.g. CHIMEI PA-757 or equiv. | Blue / White | SB-C01 / SB-C03 | VDI 3400 Ref 18 细哑光纹理 | 1.9 | 1 | drawings/SB-IRP.pdf | cad/step/SB-IRP.step | cad/fcstd/SB-IRP.FCStd
SB-PIR | SB-PIR | PIR motion | 人体红外感应模块 | electronic module (outline drawing) | ABS, e.g. CHIMEI PA-757 or equiv. | Blue / White | SB-C01 / SB-C03 | VDI 3400 Ref 18 细哑光纹理 | 4.5 |  | drawings/SB-PIR.pdf | cad/step/SB-PIR.step | cad/fcstd/SB-PIR.FCStd
SB-RADAR | SB-RADAR | mmWave presence | 毫米波人体存在模块 | electronic module (outline drawing) | ABS, e.g. CHIMEI PA-757 or equiv. | Blue / White | SB-C01 / SB-C03 | VDI 3400 Ref 18 细哑光纹理 | 2.2 |  | drawings/SB-RADAR.pdf | cad/step/SB-RADAR.step | cad/fcstd/SB-RADAR.FCStd
SB-ZONE | SB-ZONE | Multi-zone ToF 8x8 | 多区激光测距模块 | electronic module (outline drawing) | ABS, e.g. CHIMEI PA-757 or equiv. | Blue / White | SB-C01 / SB-C03 | VDI 3400 Ref 18 细哑光纹理 | 4.5 |  | drawings/SB-ZONE.pdf | cad/step/SB-ZONE.step | cad/fcstd/SB-ZONE.FCStd
SB-LINE | SB-LINE | Line sensor x5 | 循迹传感器 ×5 | electronic module (outline drawing) | ABS, e.g. CHIMEI PA-757 or equiv. | Blue / White | SB-C01 / SB-C03 | VDI 3400 Ref 18 细哑光纹理 | 16.4 | 1 | drawings/SB-LINE.pdf | cad/step/SB-LINE.step | cad/fcstd/SB-LINE.FCStd
SB-COLOR | SB-COLOR | Colour sensor | 颜色传感器 | electronic module (outline drawing) | ABS, e.g. CHIMEI PA-757 or equiv. | Blue / White | SB-C01 / SB-C03 | VDI 3400 Ref 18 细哑光纹理 | 4.5 | 1 | drawings/SB-COLOR.pdf | cad/step/SB-COLOR.step | cad/fcstd/SB-COLOR.FCStd
SB-GEST | SB-GEST | Gesture sensor | 手势传感器 | electronic module (outline drawing) | ABS, e.g. CHIMEI PA-757 or equiv. | Blue / White | SB-C01 / SB-C03 | VDI 3400 Ref 18 细哑光纹理 | 1.9 |  | drawings/SB-GEST.pdf | cad/step/SB-GEST.step | cad/fcstd/SB-GEST.FCStd
SB-LUX | SB-LUX | Light sensor | 光照传感器 | electronic module (outline drawing) | ABS, e.g. CHIMEI PA-757 or equiv. | Blue / White | SB-C01 / SB-C03 | VDI 3400 Ref 18 细哑光纹理 | 1.0 | 1 | drawings/SB-LUX.pdf | cad/step/SB-LUX.step | cad/fcstd/SB-LUX.FCStd
SB-UV | SB-UV | UV index | 紫外线传感器 | electronic module (outline drawing) | ABS, e.g. CHIMEI PA-757 or equiv. | Blue / White | SB-C01 / SB-C03 | VDI 3400 Ref 18 细哑光纹理 | 1.0 |  | drawings/SB-UV.pdf | cad/step/SB-UV.step | cad/fcstd/SB-UV.FCStd
SB-FLAME | SB-FLAME | Flame sensor | 火焰传感器 | electronic module (outline drawing) | ABS, e.g. CHIMEI PA-757 or equiv. | Blue / White | SB-C01 / SB-C03 | VDI 3400 Ref 18 细哑光纹理 | 1.9 |  | drawings/SB-FLAME.pdf | cad/step/SB-FLAME.step | cad/fcstd/SB-FLAME.FCStd
SB-IRT | SB-IRT | IR thermometer | 非接触测温模块 | electronic module (outline drawing) | ABS, e.g. CHIMEI PA-757 or equiv. | Blue / White | SB-C01 / SB-C03 | VDI 3400 Ref 18 细哑光纹理 | 4.6 |  | drawings/SB-IRT.pdf | cad/step/SB-IRT.step | cad/fcstd/SB-IRT.FCStd
SB-THERM | SB-THERM | Thermal camera 8x8 | 热成像模块 8×8 | electronic module (outline drawing) | ABS, e.g. CHIMEI PA-757 or equiv. | Blue / White | SB-C01 / SB-C03 | VDI 3400 Ref 18 细哑光纹理 | 4.5 |  | drawings/SB-THERM.pdf | cad/step/SB-THERM.step | cad/fcstd/SB-THERM.FCStd
SB-BTN | SB-BTN | Big button | 大按钮模块 | electronic module (outline drawing) | ABS, e.g. CHIMEI PA-757 or equiv. | Blue / White | SB-C01 / SB-C03 | VDI 3400 Ref 18 细哑光纹理 | 1.8 | 1 | drawings/SB-BTN.pdf | cad/step/SB-BTN.step | cad/fcstd/SB-BTN.FCStd
SB-BUMP | SB-BUMP | Bumper switch | 碰撞开关模块 | electronic module (outline drawing) | ABS, e.g. CHIMEI PA-757 or equiv. | Blue / White | SB-C01 / SB-C03 | VDI 3400 Ref 18 细哑光纹理 | 1.9 |  | drawings/SB-BUMP.pdf | cad/step/SB-BUMP.step | cad/fcstd/SB-BUMP.FCStd
SB-TOUCH | SB-TOUCH | Touch pad | 触摸传感器 | electronic module (outline drawing) | ABS, e.g. CHIMEI PA-757 or equiv. | Blue / White | SB-C01 / SB-C03 | VDI 3400 Ref 18 细哑光纹理 | 1.9 | 1 | drawings/SB-TOUCH.pdf | cad/step/SB-TOUCH.step | cad/fcstd/SB-TOUCH.FCStd
SB-FORCE | SB-FORCE | Force sensor | 压力传感器 | electronic module (outline drawing) | ABS, e.g. CHIMEI PA-757 or equiv. | Blue / White | SB-C01 / SB-C03 | VDI 3400 Ref 18 细哑光纹理 | 1.9 |  | drawings/SB-FORCE.pdf | cad/step/SB-FORCE.step | cad/fcstd/SB-FORCE.FCStd
SB-LOAD | SB-LOAD | Weight (load cell 1 kg) | 称重传感器（1 kg） | electronic module (outline drawing) | ABS, e.g. CHIMEI PA-757 or equiv. | Blue / White | SB-C01 / SB-C03 | VDI 3400 Ref 18 细哑光纹理 | 5.4 |  | drawings/SB-LOAD.pdf | cad/step/SB-LOAD.step | cad/fcstd/SB-LOAD.FCStd
SB-POT | SB-POT | Rotary knob | 旋钮电位器 | electronic module (outline drawing) | ABS, e.g. CHIMEI PA-757 or equiv. | Blue / White | SB-C01 / SB-C03 | VDI 3400 Ref 18 细哑光纹理 | 1.0 | 1 | drawings/SB-POT.pdf | cad/step/SB-POT.step | cad/fcstd/SB-POT.FCStd
SB-ENC | SB-ENC | Rotary encoder | 旋转编码器 | electronic module (outline drawing) | ABS, e.g. CHIMEI PA-757 or equiv. | Blue / White | SB-C01 / SB-C03 | VDI 3400 Ref 18 细哑光纹理 | 1.0 |  | drawings/SB-ENC.pdf | cad/step/SB-ENC.step | cad/fcstd/SB-ENC.FCStd
SB-SLIDE | SB-SLIDE | Slide control | 滑动电位器 | electronic module (outline drawing) | ABS, e.g. CHIMEI PA-757 or equiv. | Blue / White | SB-C01 / SB-C03 | VDI 3400 Ref 18 细哑光纹理 | 3.8 |  | drawings/SB-SLIDE.pdf | cad/step/SB-SLIDE.step | cad/fcstd/SB-SLIDE.FCStd
SB-JOY | SB-JOY | Joystick | 摇杆模块 | electronic module (outline drawing) | ABS, e.g. CHIMEI PA-757 or equiv. | Blue / White | SB-C01 / SB-C03 | VDI 3400 Ref 18 细哑光纹理 | 2.8 |  | drawings/SB-JOY.pdf | cad/step/SB-JOY.step | cad/fcstd/SB-JOY.FCStd
SB-KEYPAD | SB-KEYPAD | Keypad 4x3 | 4×3 键盘 | electronic module (outline drawing) | ABS, e.g. CHIMEI PA-757 or equiv. | Blue / White | SB-C01 / SB-C03 | VDI 3400 Ref 18 细哑光纹理 | 5.1 |  | drawings/SB-KEYPAD.pdf | cad/step/SB-KEYPAD.step | cad/fcstd/SB-KEYPAD.FCStd
SB-IMU | SB-IMU | Motion sensor (6-axis) | 六轴姿态传感器 | electronic module (outline drawing) | ABS, e.g. CHIMEI PA-757 or equiv. | Blue / White | SB-C01 / SB-C03 | VDI 3400 Ref 18 细哑光纹理 | 1.0 |  | drawings/SB-IMU.pdf | cad/step/SB-IMU.step | cad/fcstd/SB-IMU.FCStd
SB-KNOCK | SB-KNOCK | Knock / vibration | 敲击/震动传感器 | electronic module (outline drawing) | ABS, e.g. CHIMEI PA-757 or equiv. | Blue / White | SB-C01 / SB-C03 | VDI 3400 Ref 18 细哑光纹理 | 1.0 |  | drawings/SB-KNOCK.pdf | cad/step/SB-KNOCK.step | cad/fcstd/SB-KNOCK.FCStd
SB-ANGLE | SB-ANGLE | Angle sensor (axle-through) | 角度传感器（轴穿式） | electronic module (outline drawing) | ABS, e.g. CHIMEI PA-757 or equiv. | Blue / White | SB-C01 / SB-C03 | VDI 3400 Ref 18 细哑光纹理 | 1.7 | 1 | drawings/SB-ANGLE.pdf | cad/step/SB-ANGLE.step | cad/fcstd/SB-ANGLE.FCStd
SB-MAG | SB-MAG | Magnetic sensor | 磁场传感器 | electronic module (outline drawing) | ABS, e.g. CHIMEI PA-757 or equiv. | Blue / White | SB-C01 / SB-C03 | VDI 3400 Ref 18 细哑光纹理 | 1.0 |  | drawings/SB-MAG.pdf | cad/step/SB-MAG.step | cad/fcstd/SB-MAG.FCStd
SB-COMPASS | SB-COMPASS | Compass | 电子罗盘 | electronic module (outline drawing) | ABS, e.g. CHIMEI PA-757 or equiv. | Blue / White | SB-C01 / SB-C03 | VDI 3400 Ref 18 细哑光纹理 | 1.0 |  | drawings/SB-COMPASS.pdf | cad/step/SB-COMPASS.step | cad/fcstd/SB-COMPASS.FCStd
SB-ENV | SB-ENV | Temp / humidity / pressure | 温湿度气压传感器 | electronic module (outline drawing) | ABS, e.g. CHIMEI PA-757 or equiv. | Blue / White | SB-C01 / SB-C03 | VDI 3400 Ref 18 细哑光纹理 | 2.4 | 1 | drawings/SB-ENV.pdf | cad/step/SB-ENV.step | cad/fcstd/SB-ENV.FCStd
SB-PROBE | SB-PROBE | Waterproof temp probe | 防水温度探头 | electronic module (outline drawing) | ABS, e.g. CHIMEI PA-757 or equiv. | Blue / White | SB-C01 / SB-C03 | VDI 3400 Ref 18 细哑光纹理 | 1.9 |  | drawings/SB-PROBE.pdf | cad/step/SB-PROBE.step | cad/fcstd/SB-PROBE.FCStd
SB-SOIL | SB-SOIL | Soil moisture | 土壤湿度传感器 | electronic module (outline drawing) | ABS, e.g. CHIMEI PA-757 or equiv. | Blue / White | SB-C01 / SB-C03 | VDI 3400 Ref 18 细哑光纹理 | 1.9 |  | drawings/SB-SOIL.pdf | cad/step/SB-SOIL.step | cad/fcstd/SB-SOIL.FCStd
SB-WATER | SB-WATER | Water level / rain | 水位/雨滴传感器 | electronic module (outline drawing) | ABS, e.g. CHIMEI PA-757 or equiv. | Blue / White | SB-C01 / SB-C03 | VDI 3400 Ref 18 细哑光纹理 | 1.9 |  | drawings/SB-WATER.pdf | cad/step/SB-WATER.step | cad/fcstd/SB-WATER.FCStd
SB-SOUND | SB-SOUND | Sound level | 声音传感器 | electronic module (outline drawing) | ABS, e.g. CHIMEI PA-757 or equiv. | Blue / White | SB-C01 / SB-C03 | VDI 3400 Ref 18 细哑光纹理 | 1.9 | 1 | drawings/SB-SOUND.pdf | cad/step/SB-SOUND.step | cad/fcstd/SB-SOUND.FCStd
SB-CO2 | SB-CO2 | CO2 (NDIR) | 二氧化碳传感器（NDIR） | electronic module (outline drawing) | ABS, e.g. CHIMEI PA-757 or equiv. | Blue / White | SB-C01 / SB-C03 | VDI 3400 Ref 18 细哑光纹理 | 5.7 |  | drawings/SB-CO2.pdf | cad/step/SB-CO2.step | cad/fcstd/SB-CO2.FCStd
SB-AIR | SB-AIR | Air quality (TVOC) | 空气质量传感器（TVOC） | electronic module (outline drawing) | ABS, e.g. CHIMEI PA-757 or equiv. | Blue / White | SB-C01 / SB-C03 | VDI 3400 Ref 18 细哑光纹理 | 1.9 |  | drawings/SB-AIR.pdf | cad/step/SB-AIR.step | cad/fcstd/SB-AIR.FCStd
SB-PM | SB-PM | Dust PM2.5 | PM2.5 粉尘传感器 | electronic module (outline drawing) | ABS, e.g. CHIMEI PA-757 or equiv. | Blue / White | SB-C01 / SB-C03 | VDI 3400 Ref 18 细哑光纹理 | 30.3 |  | drawings/SB-PM.pdf | cad/step/SB-PM.step | cad/fcstd/SB-PM.FCStd
SB-GAS | SB-GAS | Gas / smoke | 气体/烟雾传感器 | electronic module (outline drawing) | ABS, e.g. CHIMEI PA-757 or equiv. | Blue / White | SB-C01 / SB-C03 | VDI 3400 Ref 18 细哑光纹理 | 4.6 |  | drawings/SB-GAS.pdf | cad/step/SB-GAS.step | cad/fcstd/SB-GAS.FCStd
SB-PH | SB-PH | pH probe | pH 酸碱度探头 | electronic module (outline drawing) | ABS, e.g. CHIMEI PA-757 or equiv. | Blue / White | SB-C01 / SB-C03 | VDI 3400 Ref 18 细哑光纹理 | 2.4 |  | drawings/SB-PH.pdf | cad/step/SB-PH.step | cad/fcstd/SB-PH.FCStd
SB-TDS | SB-TDS | Water quality (TDS) | 水质 TDS 传感器 | electronic module (outline drawing) | ABS, e.g. CHIMEI PA-757 or equiv. | Blue / White | SB-C01 / SB-C03 | VDI 3400 Ref 18 细哑光纹理 | 2.4 |  | drawings/SB-TDS.pdf | cad/step/SB-TDS.step | cad/fcstd/SB-TDS.FCStd
SB-HEART | SB-HEART | Heart rate & SpO2 | 心率血氧传感器 | electronic module (outline drawing) | ABS, e.g. CHIMEI PA-757 or equiv. | Blue / White | SB-C01 / SB-C03 | VDI 3400 Ref 18 细哑光纹理 | 1.8 |  | drawings/SB-HEART.pdf | cad/step/SB-HEART.step | cad/fcstd/SB-HEART.FCStd
SB-GPS | SB-GPS | GPS | GPS 定位模块 | electronic module (outline drawing) | ABS, e.g. CHIMEI PA-757 or equiv. | Blue / White | SB-C01 / SB-C03 | VDI 3400 Ref 18 细哑光纹理 | 5.1 |  | drawings/SB-GPS.pdf | cad/step/SB-GPS.step | cad/fcstd/SB-GPS.FCStd
SB-CAM | SB-CAM | AI vision camera | AI 视觉摄像头 | electronic module (outline drawing) | ABS, e.g. CHIMEI PA-757 or equiv. | Violet / White | SB-C09 / SB-C03 | VDI 3400 Ref 18 细哑光纹理 | 19.4 |  | drawings/SB-CAM.pdf | cad/step/SB-CAM.step | cad/fcstd/SB-CAM.FCStd
SB-VOICE | SB-VOICE | Offline voice | 离线语音识别模块 | electronic module (outline drawing) | ABS, e.g. CHIMEI PA-757 or equiv. | Violet / White | SB-C09 / SB-C03 | VDI 3400 Ref 18 细哑光纹理 | 2.9 |  | drawings/SB-VOICE.pdf | cad/step/SB-VOICE.step | cad/fcstd/SB-VOICE.FCStd
SB-RFID | SB-RFID | RFID / NFC reader | RFID/NFC 读卡器 | electronic module (outline drawing) | ABS, e.g. CHIMEI PA-757 or equiv. | Teal / White | SB-C08 / SB-C03 | VDI 3400 Ref 18 细哑光纹理 | 5.1 |  | drawings/SB-RFID.pdf | cad/step/SB-RFID.step | cad/fcstd/SB-RFID.FCStd
SB-IRX | SB-IRX | IR remote send + receive | 红外收发模块 | electronic module (outline drawing) | ABS, e.g. CHIMEI PA-757 or equiv. | Teal / White | SB-C08 / SB-C03 | VDI 3400 Ref 18 细哑光纹理 | 1.9 |  | drawings/SB-IRX.pdf | cad/step/SB-IRX.step | cad/fcstd/SB-IRX.FCStd
SB-RGB | SB-RGB | RGB LED x4 | RGB 彩灯 ×4 | electronic module (outline drawing) | ABS, e.g. CHIMEI PA-757 or equiv. | Yellow / White | SB-C02 / SB-C03 | VDI 3400 Ref 18 细哑光纹理 | 2.3 | 1 | drawings/SB-RGB.pdf | cad/step/SB-RGB.step | cad/fcstd/SB-RGB.FCStd
SB-RING | SB-RING | LED ring x12 | LED 灯环 ×12 | electronic module (outline drawing) | ABS, e.g. CHIMEI PA-757 or equiv. | Yellow / White | SB-C02 / SB-C03 | VDI 3400 Ref 18 细哑光纹理 | 5.1 |  | drawings/SB-RING.pdf | cad/step/SB-RING.step | cad/fcstd/SB-RING.FCStd
SB-MATRIX | SB-MATRIX | LED matrix 8x8 | 8×8 点阵屏 | electronic module (outline drawing) | ABS, e.g. CHIMEI PA-757 or equiv. | Yellow / White | SB-C02 / SB-C03 | VDI 3400 Ref 18 细哑光纹理 | 4.7 |  | drawings/SB-MATRIX.pdf | cad/step/SB-MATRIX.step | cad/fcstd/SB-MATRIX.FCStd
SB-TRAFFIC | SB-TRAFFIC | Traffic light | 交通灯模块 | electronic module (outline drawing) | ABS, e.g. CHIMEI PA-757 or equiv. | Yellow / White | SB-C02 / SB-C03 | VDI 3400 Ref 18 细哑光纹理 | 4.4 |  | drawings/SB-TRAFFIC.pdf | cad/step/SB-TRAFFIC.step | cad/fcstd/SB-TRAFFIC.FCStd
SB-OLED | SB-OLED | OLED screen 0.96 in | 0.96 寸 OLED 显示屏 | electronic module (outline drawing) | ABS, e.g. CHIMEI PA-757 or equiv. | Yellow / White | SB-C02 / SB-C03 | VDI 3400 Ref 18 细哑光纹理 | 3.4 |  | drawings/SB-OLED.pdf | cad/step/SB-OLED.step | cad/fcstd/SB-OLED.FCStd
SB-SEG | SB-SEG | 4-digit display | 四位数码管 | electronic module (outline drawing) | ABS, e.g. CHIMEI PA-757 or equiv. | Yellow / White | SB-C02 / SB-C03 | VDI 3400 Ref 18 细哑光纹理 | 5.7 |  | drawings/SB-SEG.pdf | cad/step/SB-SEG.step | cad/fcstd/SB-SEG.FCStd
SB-SPK | SB-SPK | Speaker / MP3 | 喇叭/MP3 模块 | electronic module (outline drawing) | ABS, e.g. CHIMEI PA-757 or equiv. | Yellow / White | SB-C02 / SB-C03 | VDI 3400 Ref 18 细哑光纹理 | 5.1 |  | drawings/SB-SPK.pdf | cad/step/SB-SPK.step | cad/fcstd/SB-SPK.FCStd
SB-FAN | SB-FAN | Fan | 风扇模块 | electronic module (outline drawing) | ABS, e.g. CHIMEI PA-757 or equiv. | Yellow / White | SB-C02 / SB-C03 | VDI 3400 Ref 18 细哑光纹理 | 12.2 |  | drawings/SB-FAN.pdf | cad/step/SB-FAN.step | cad/fcstd/SB-FAN.FCStd
SB-PUMP | SB-PUMP | Water pump | 水泵模块 | electronic module (outline drawing) | ABS, e.g. CHIMEI PA-757 or equiv. | Yellow / White | SB-C02 / SB-C03 | VDI 3400 Ref 18 细哑光纹理 | 8.8 |  | drawings/SB-PUMP.pdf | cad/step/SB-PUMP.step | cad/fcstd/SB-PUMP.FCStd
SB-VIB | SB-VIB | Vibration motor | 震动马达模块 | electronic module (outline drawing) | ABS, e.g. CHIMEI PA-757 or equiv. | Yellow / White | SB-C02 / SB-C03 | VDI 3400 Ref 18 细哑光纹理 | 1.0 |  | drawings/SB-VIB.pdf | cad/step/SB-VIB.step | cad/fcstd/SB-VIB.FCStd
SB-EMAG | SB-EMAG | Electromagnet | 电磁铁模块 | electronic module (outline drawing) | ABS, e.g. CHIMEI PA-757 or equiv. | Yellow / White | SB-C02 / SB-C03 | VDI 3400 Ref 18 细哑光纹理 | 4.6 |  | drawings/SB-EMAG.pdf | cad/step/SB-EMAG.step | cad/fcstd/SB-EMAG.FCStd
SB-SWITCH | SB-SWITCH | Power switch (12 V max) | 电源开关（≤12 V） | electronic module (outline drawing) | ABS, e.g. CHIMEI PA-757 or equiv. | Yellow / White | SB-C02 / SB-C03 | VDI 3400 Ref 18 细哑光纹理 | 1.9 |  | drawings/SB-SWITCH.pdf | cad/step/SB-SWITCH.step | cad/fcstd/SB-SWITCH.FCStd
SB-SOLAR | SB-SOLAR | Solar panel 1 W | 太阳能板 1 W | electronic module (outline drawing) | ABS, e.g. CHIMEI PA-757 or equiv. | Dark grey / White | SB-C05 / SB-C03 | VDI 3400 Ref 18 细哑光纹理 | 17.2 |  | drawings/SB-SOLAR.pdf | cad/step/SB-SOLAR.step | cad/fcstd/SB-SOLAR.FCStd
SB-METER | SB-METER | Energy meter (V/I/W) | 电能表（电压/电流/功率） | electronic module (outline drawing) | ABS, e.g. CHIMEI PA-757 or equiv. | Dark grey / White | SB-C05 / SB-C03 | VDI 3400 Ref 18 细哑光纹理 | 2.2 |  | drawings/SB-METER.pdf | cad/step/SB-METER.step | cad/fcstd/SB-METER.FCStd
