quantrpeter/semiblock-junior/stage-1/renders/parts/SB-S-US.png

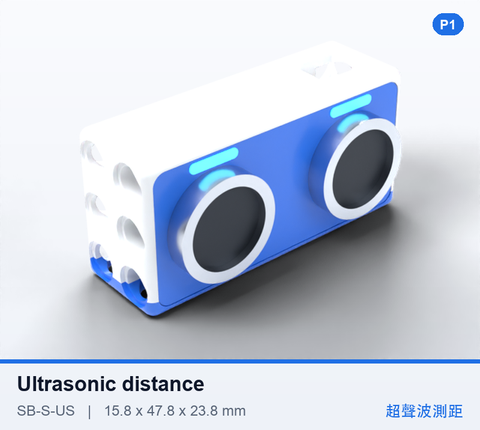
stage-1/renders/parts/SB-S-US.png
