quantrpeter/semiblock-junior/stage-2/cad/stl/SB-HUB_button_main.stl

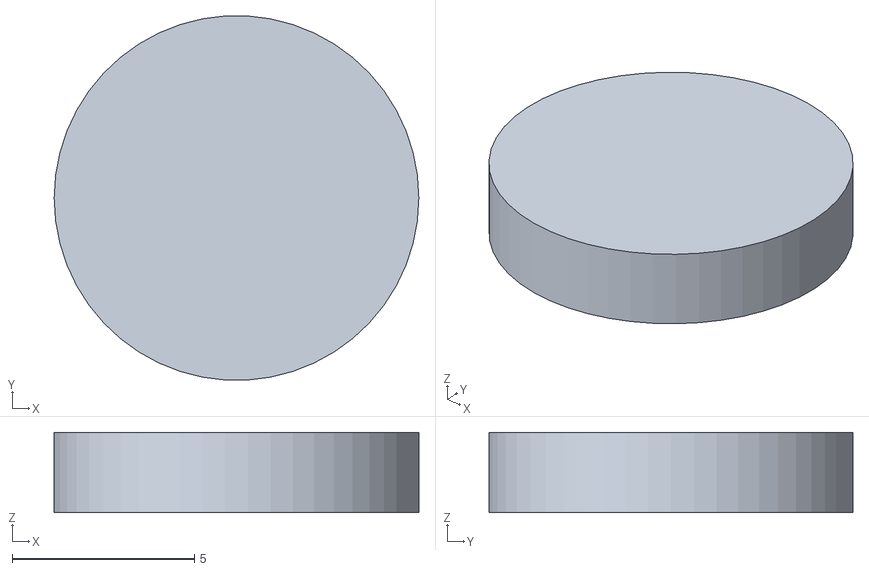
[picture p284: CAD file, 2026-10-27]
stage-2/cad/stl/SB-HUB_button_main.stl
10.0 x 9.98 x 2.20
