quantrpeter/semiblock-junior/stage-1/cad/step/SB-SWITCH.step

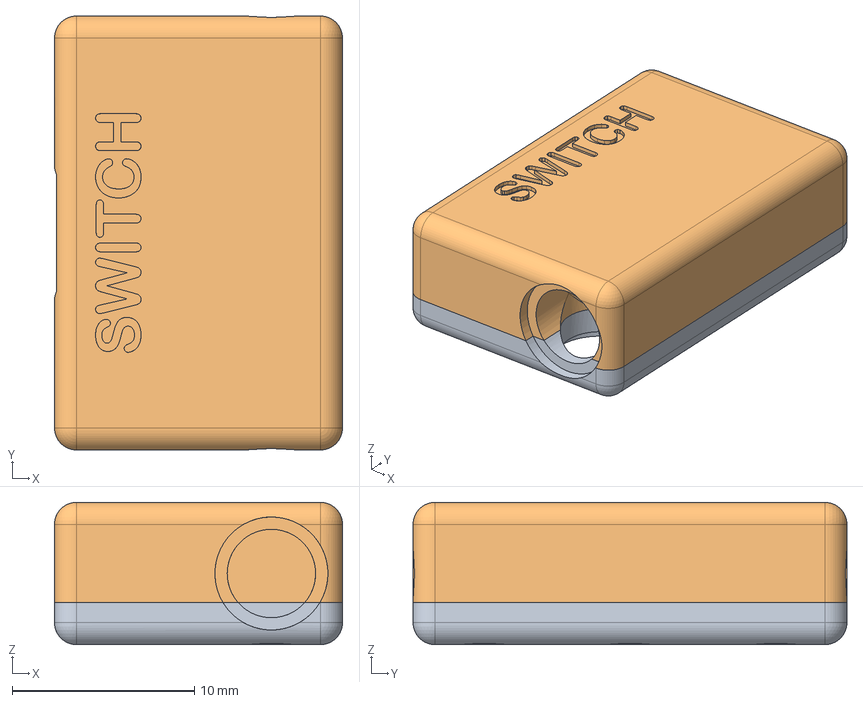
[picture p285: CAD file, 2026-10-26]
stage-1/cad/step/SB-SWITCH.step
15.8 x 23.8 x 7.80 mm
