quantrpeter/semiblock-junior/stage-1/cad/stl/SB-HUB_base.stl

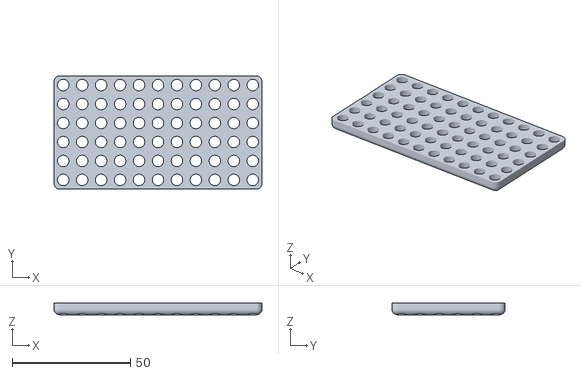
[picture p286: CAD file, 2026-10-26]
stage-1/cad/stl/SB-HUB_base.stl
87.8 x 47.8 x 4.90
