quantrpeter/semiblock-junior/stage-2/cad/step/SB-C111.step

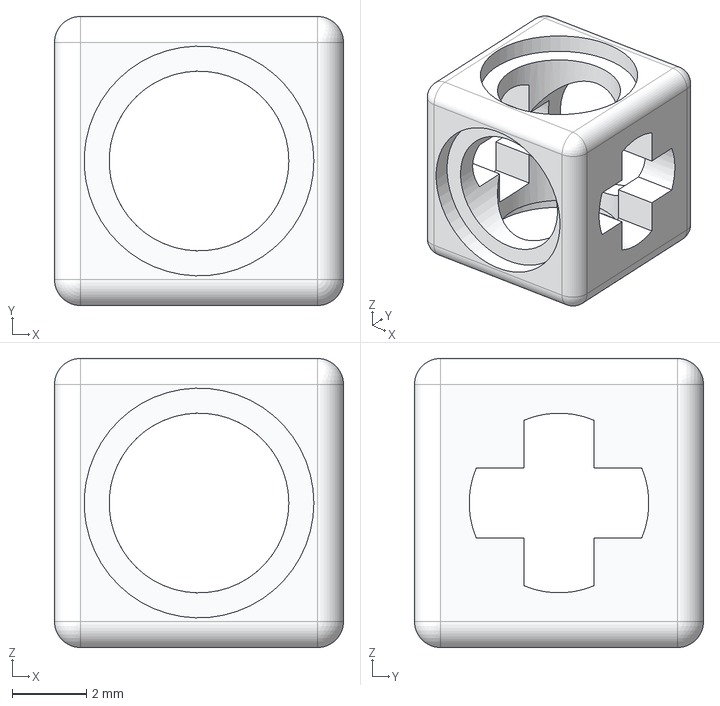
[picture p287: CAD file, 2026-10-28]
stage-2/cad/step/SB-C111.step
7.80 x 7.80 x 7.80 mm
