quantrpeter/semiblock-junior/stage-2/cad/stl/SB-BR5_bearing_mr128.stl

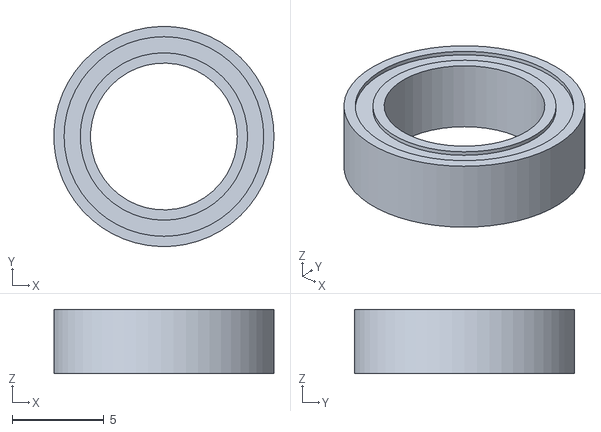
[picture p288: CAD file, 2026-10-27]
stage-2/cad/stl/SB-BR5_bearing_mr128.stl
12.0 x 12.0 x 3.50
