quantrpeter/semiblock-junior/stage-1/cad/step/SB-EMAG.step

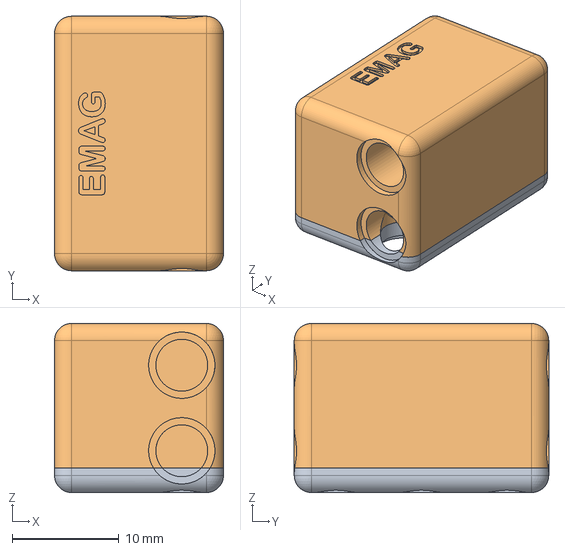
[picture p289: CAD file, 2026-10-26]
stage-1/cad/step/SB-EMAG.step
15.8 x 23.8 x 15.8 mm
