quantrpeter/semiblock-junior/stage-1/cad/stl/SB-TL3S_core.stl

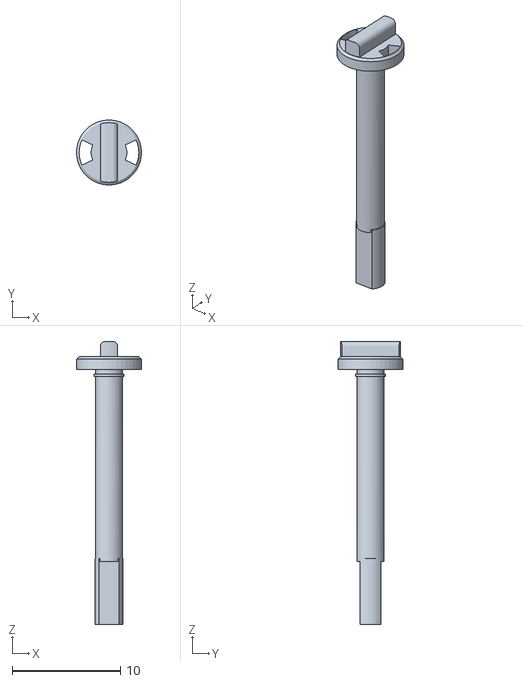
[picture p290: CAD file, 2026-10-26]
stage-1/cad/stl/SB-TL3S_core.stl
6.00 x 5.98 x 26.1
