quantrpeter/semiblock-junior/stage-2/cad/step/SB-A08.step

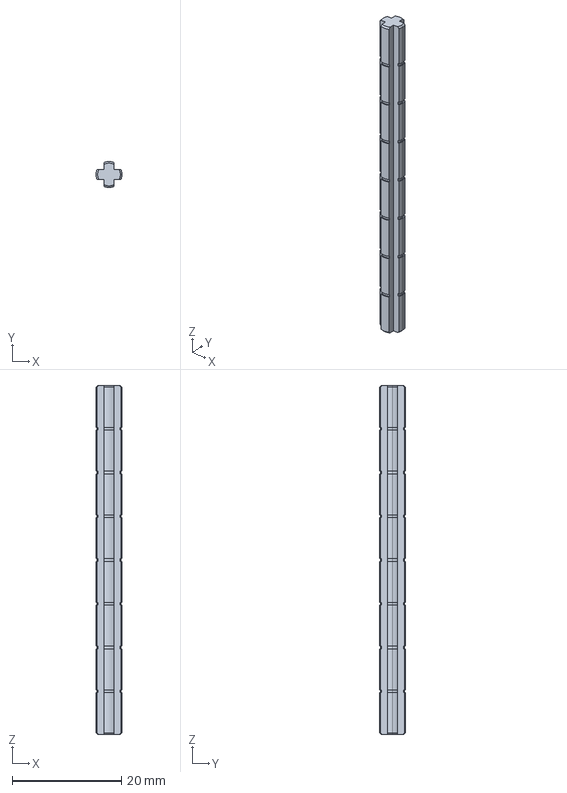
[picture p291: CAD file, 2026-10-28]
stage-2/cad/step/SB-A08.step
4.75 x 4.74 x 63.8 mm
