quantrpeter/semiblock-junior/stage-2/cad/stl/SB-SOLAR_base.stl

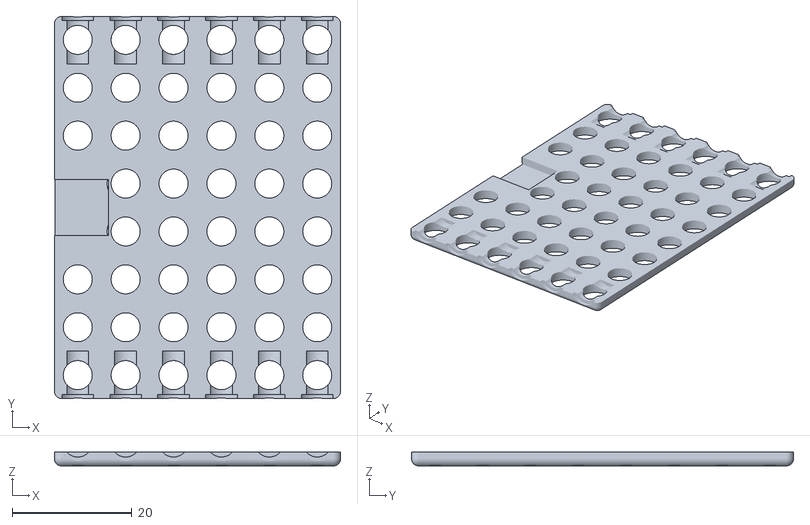
[picture p292: CAD file, 2026-10-27]
stage-2/cad/stl/SB-SOLAR_base.stl
47.8 x 63.8 x 2.30
