quantrpeter/semiblock-junior/stage-1/cad/step/SB-TRAFFIC.step

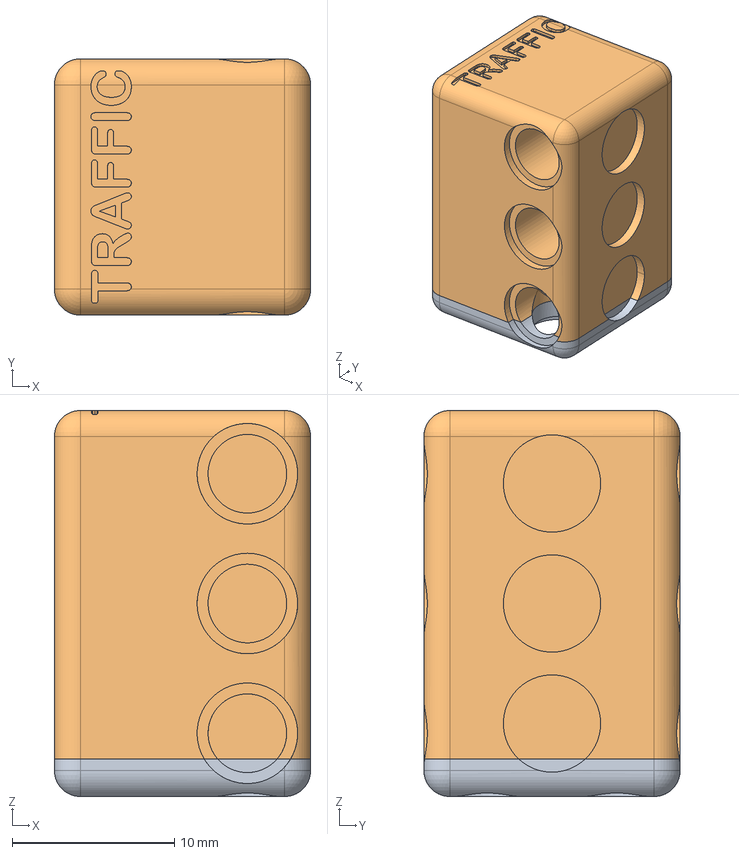
[picture p293: CAD file, 2026-10-26]
stage-1/cad/step/SB-TRAFFIC.step
15.8 x 15.8 x 23.8 mm
