quantrpeter/semiblock-junior/stage-1/cad/stl/SB-TL2_core.stl

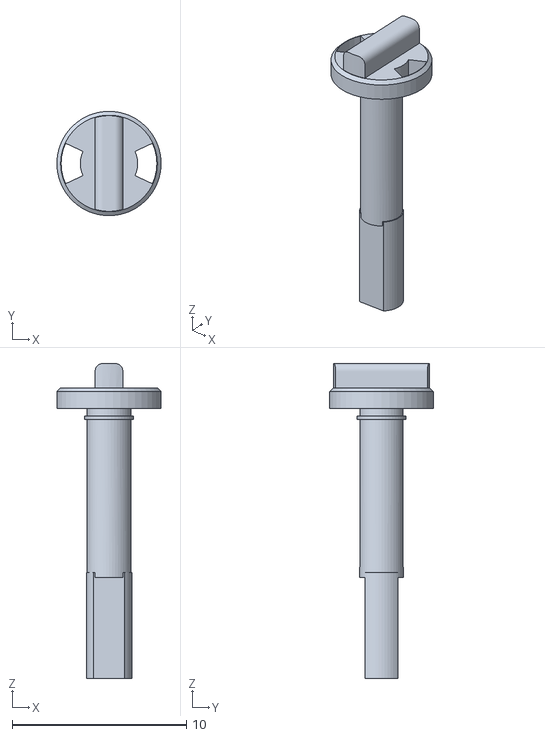
[picture p294: CAD file, 2026-10-26]
stage-1/cad/stl/SB-TL2_core.stl
6.00 x 5.98 x 18.1
