quantrpeter/semiblock-junior/stage-2/cad/stl/SB-W30_hub.stl

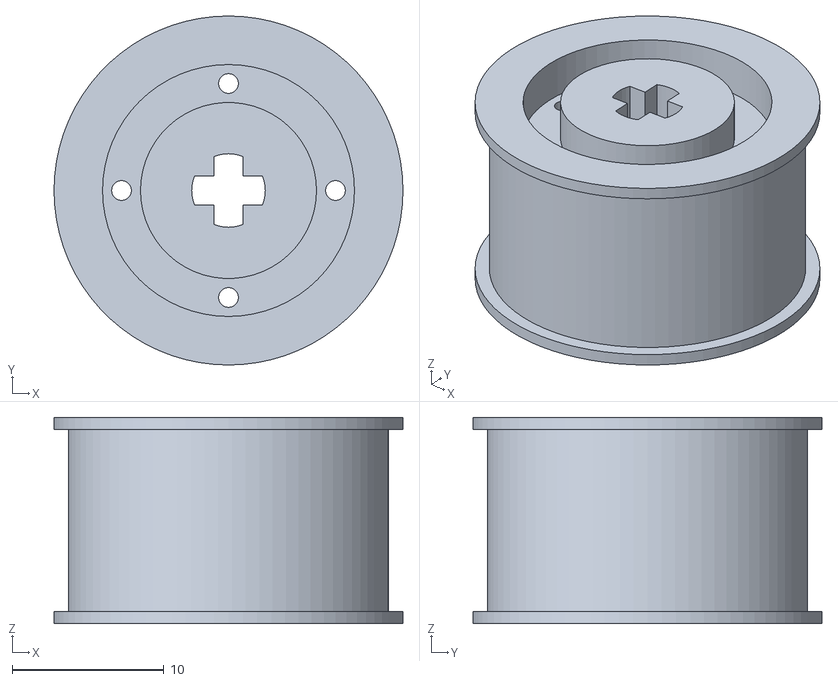
[picture p295: CAD file, 2026-10-27]
stage-2/cad/stl/SB-W30_hub.stl
23.0 x 23.0 x 13.6
