quantrpeter/semiblock-junior/stage-1/cad/step/SB-SEG.step

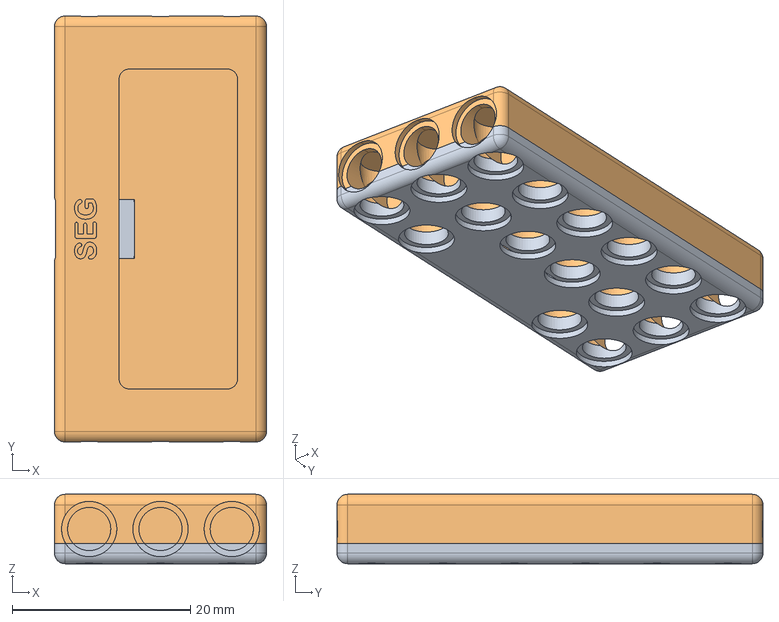
[picture p296: CAD file, 2026-10-26]
stage-1/cad/step/SB-SEG.step
23.8 x 47.8 x 7.80 mm
