quantrpeter/semiblock-junior/stage-2/cad/step/SB-KNOCK.step

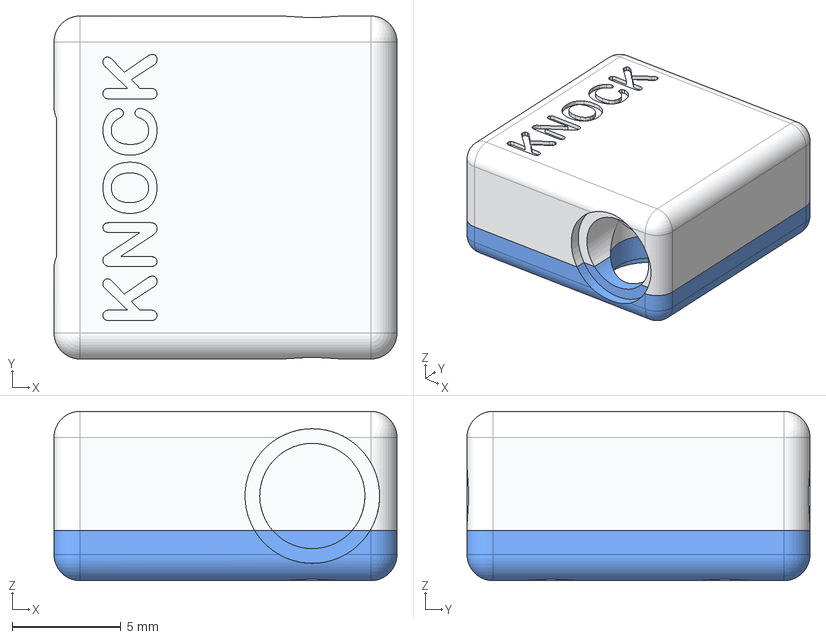
[picture p298: CAD file, 2026-10-28]
stage-2/cad/step/SB-KNOCK.step
15.8 x 15.8 x 7.80 mm
SB-KNOCK-01 base
SB-KNOCK-02 cover
