quantrpeter/semiblock-junior/stage-2/cad/stl/SB-HUB_cover.stl

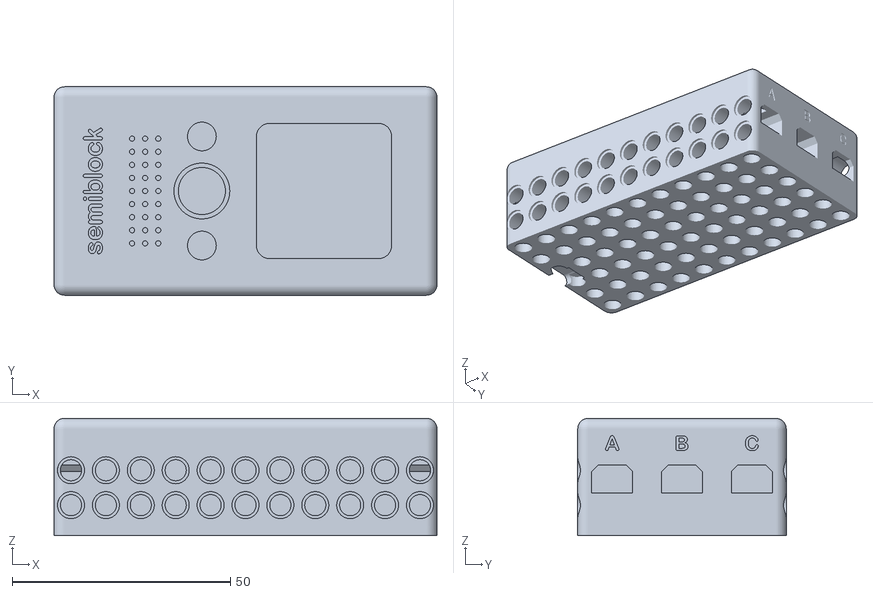
[picture p299: CAD file, 2026-10-27]
stage-2/cad/stl/SB-HUB_cover.stl
87.8 x 47.8 x 26.9
