quantrpeter/semiblock-junior/stage-1/cad/step/SB-SOLAR.step

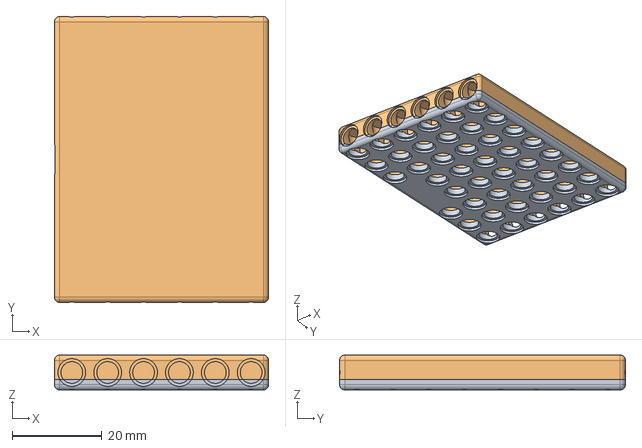
[picture p300: CAD file, 2026-10-26]
stage-1/cad/step/SB-SOLAR.step
47.8 x 63.8 x 7.80 mm
