quantrpeter/semiblock-junior/stage-1/cad/stl/SB-TRAFFIC_cover.stl

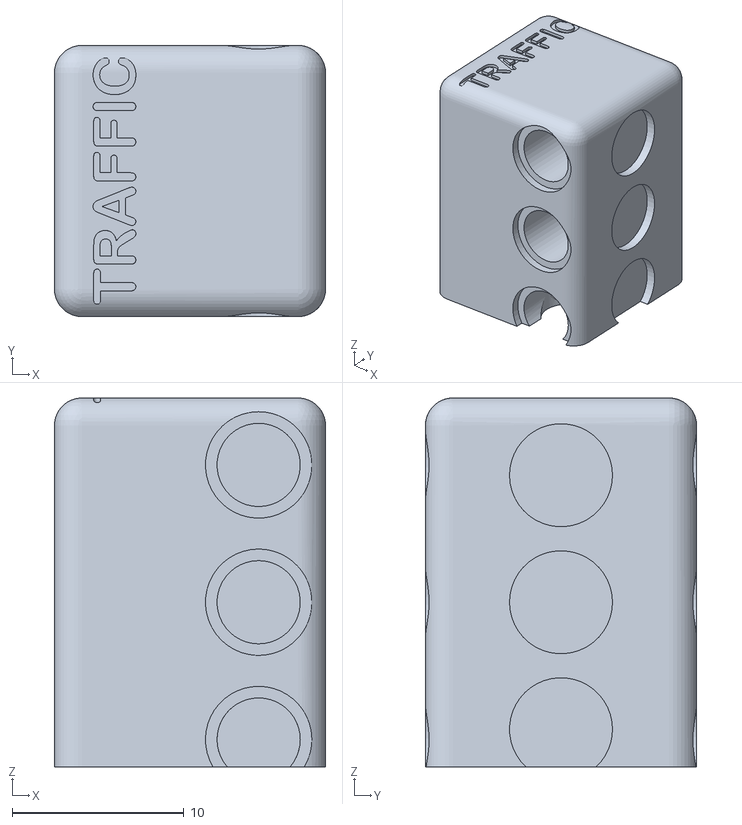
[picture p301: CAD file, 2026-10-26]
stage-1/cad/stl/SB-TRAFFIC_cover.stl
15.8 x 15.8 x 21.5
