quantrpeter/semiblock-junior/stage-2/cad/stl/SB-IRP_cover.stl

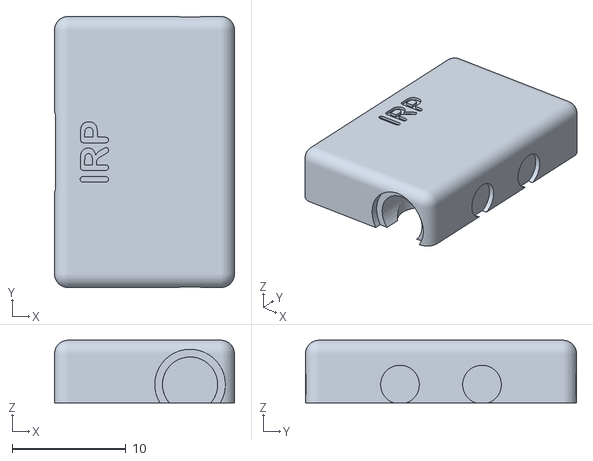
[picture p302: CAD file, 2026-10-27]
stage-2/cad/stl/SB-IRP_cover.stl
15.8 x 23.8 x 5.50
