quantrpeter/semiblock-junior/stage-1/cad/step/SB-RING.step

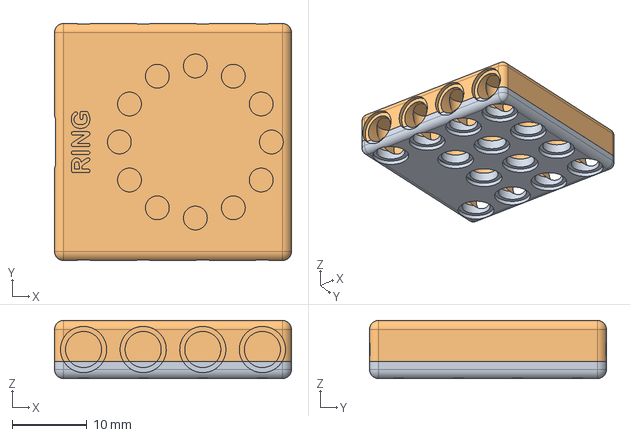
[picture p303: CAD file, 2026-10-26]
stage-1/cad/step/SB-RING.step
31.8 x 31.8 x 7.80 mm
