quantrpeter/semiblock-junior/stage-1/cad/stl/SB-TL2S_sleeve.stl

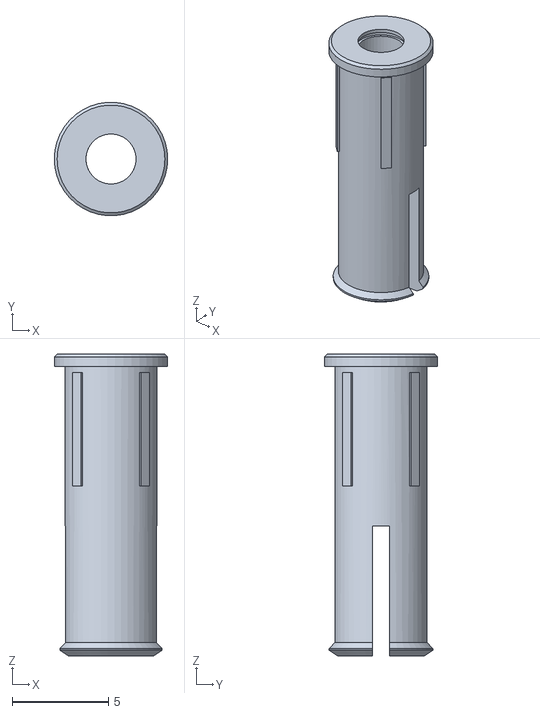
[picture p304: CAD file, 2026-10-26]
stage-1/cad/stl/SB-TL2S_sleeve.stl
5.90 x 5.88 x 15.7
