quantrpeter/semiblock-junior/stage-2/cad/stl/SB-BR5_retainer.stl

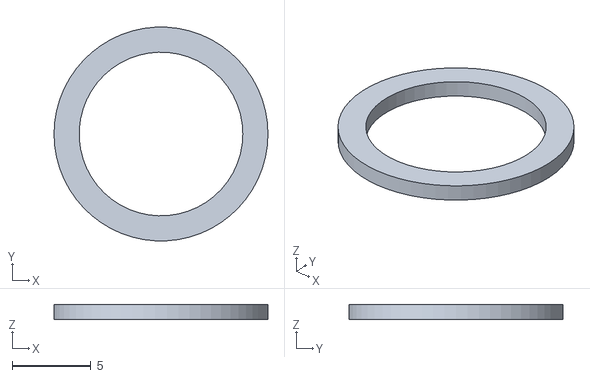
[picture p305: CAD file, 2026-10-27]
stage-2/cad/stl/SB-BR5_retainer.stl
13.6 x 13.6 x 0.95
