quantrpeter/semiblock-junior/stage-1/cad/step/SB-METER.step

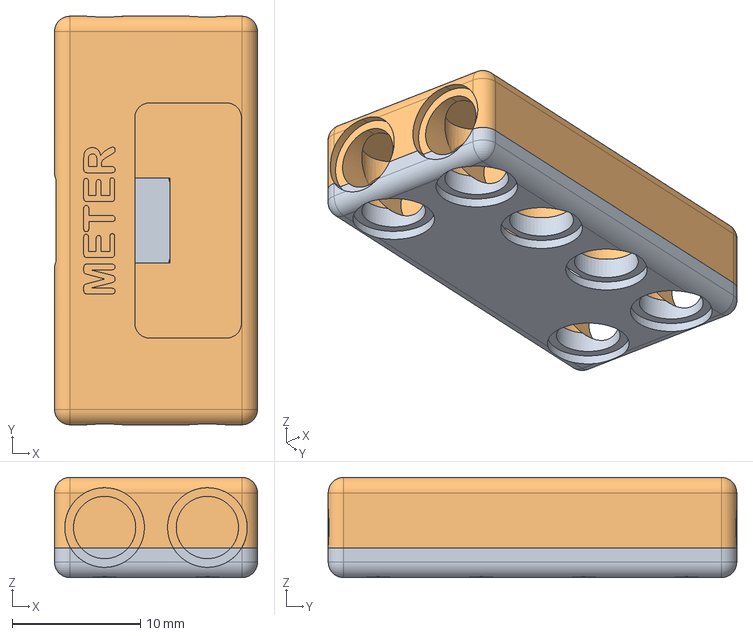
[picture p306: CAD file, 2026-10-26]
stage-1/cad/step/SB-METER.step
15.8 x 31.8 x 7.80 mm
