quantrpeter/semiblock-junior/stage-1/cad/stl/SB-BTN_base.stl

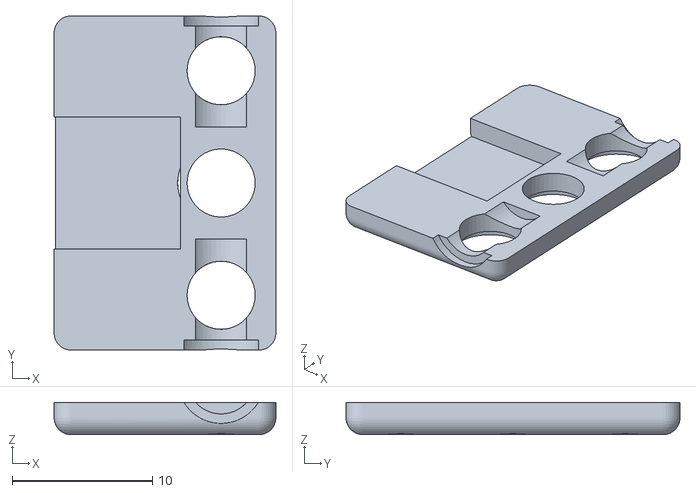
[picture p307: CAD file, 2026-10-26]
stage-1/cad/stl/SB-BTN_base.stl
15.8 x 23.8 x 2.30
