quantrpeter/semiblock-junior/stage-2/cad/step/SB-F57.step

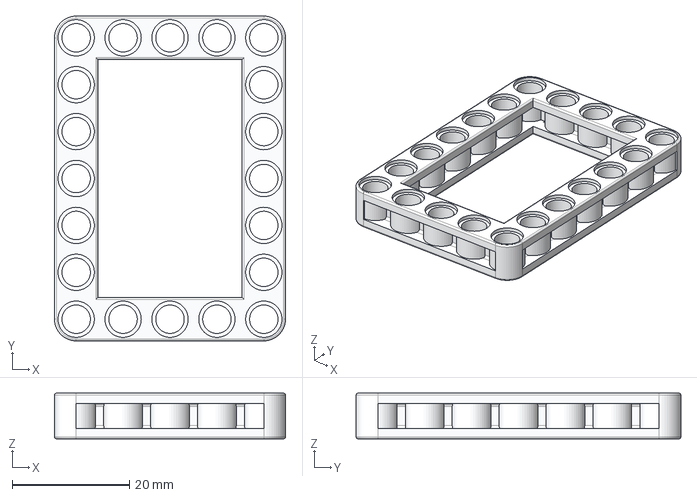
[picture p308: CAD file, 2026-10-28]
stage-2/cad/step/SB-F57.step
39.4 x 55.4 x 7.80 mm
