quantrpeter/semiblock-junior/stage-2/cad/stl/SB-ENC_cover.stl

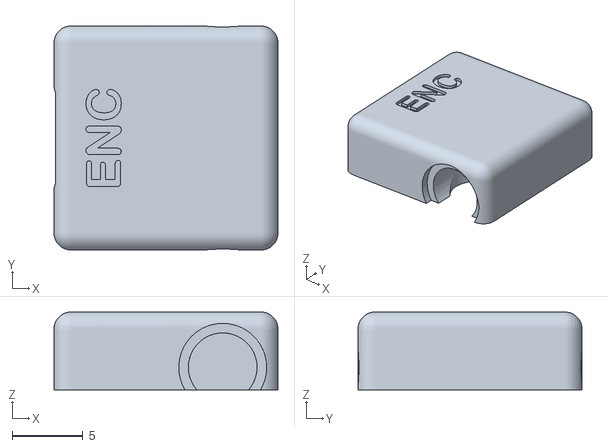
[picture p309: CAD file, 2026-10-27]
stage-2/cad/stl/SB-ENC_cover.stl
15.8 x 15.8 x 5.50
