quantrpeter/semiblock-junior/stage-1/cad/step/SB-RGB.step

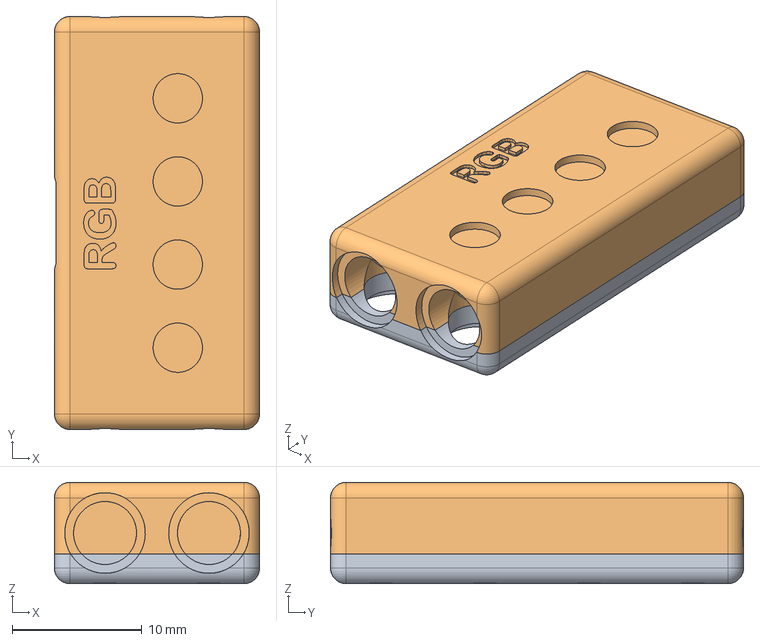
[picture p310: CAD file, 2026-10-26]
stage-1/cad/step/SB-RGB.step
15.8 x 31.8 x 7.80 mm
