quantrpeter/semiblock-junior/stage-1/cad/stl/SB-SEG_cover.stl

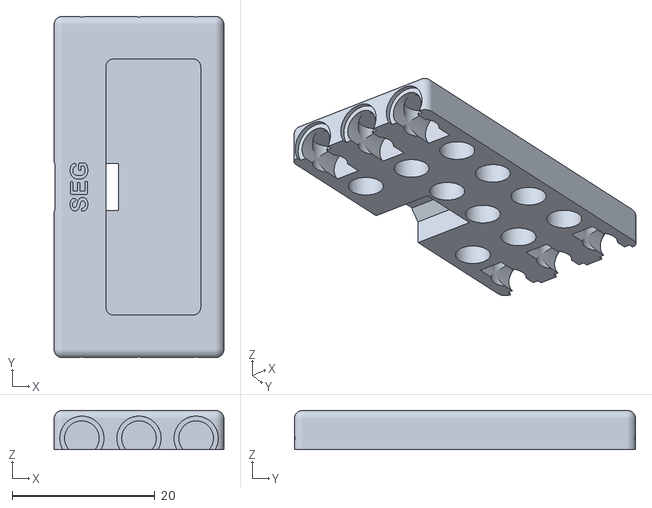
[picture p311: CAD file, 2026-10-26]
stage-1/cad/stl/SB-SEG_cover.stl
23.8 x 47.8 x 5.50
