quantrpeter/semiblock-junior/stage-2/cad/step/SB-G08.step

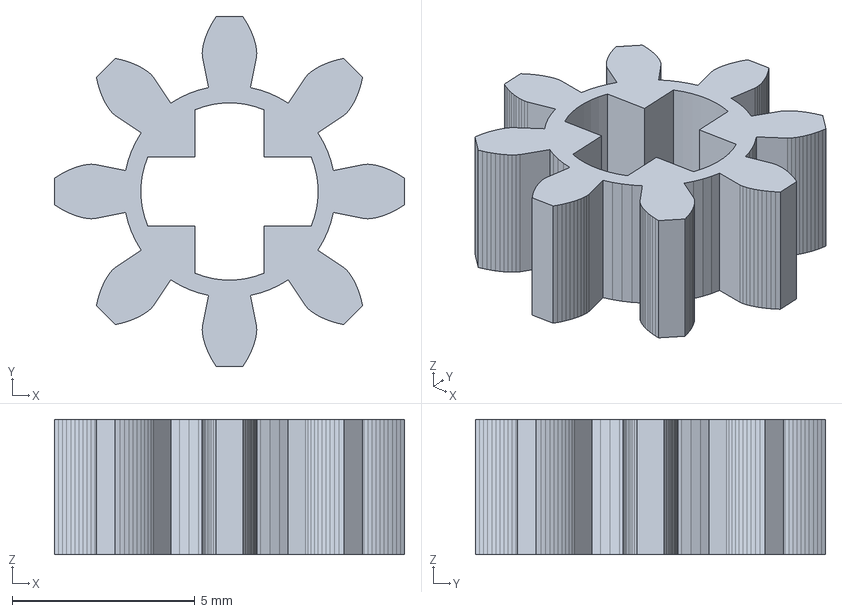
[picture p312: CAD file, 2026-10-28]
stage-2/cad/step/SB-G08.step
9.57 x 9.57 x 3.70 mm
