quantrpeter/semiblock-junior/stage-1/cad/step/SB-OLED.step

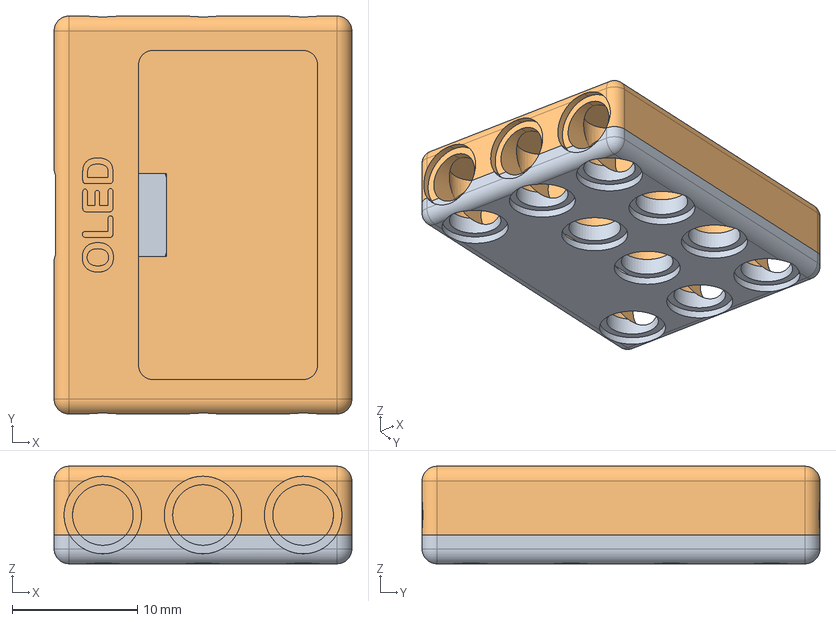
[picture p313: CAD file, 2026-10-26]
stage-1/cad/step/SB-OLED.step
23.8 x 31.8 x 7.80 mm
