quantrpeter/semiblock-junior/stage-1/cad/stl/SB-W56_hub.stl

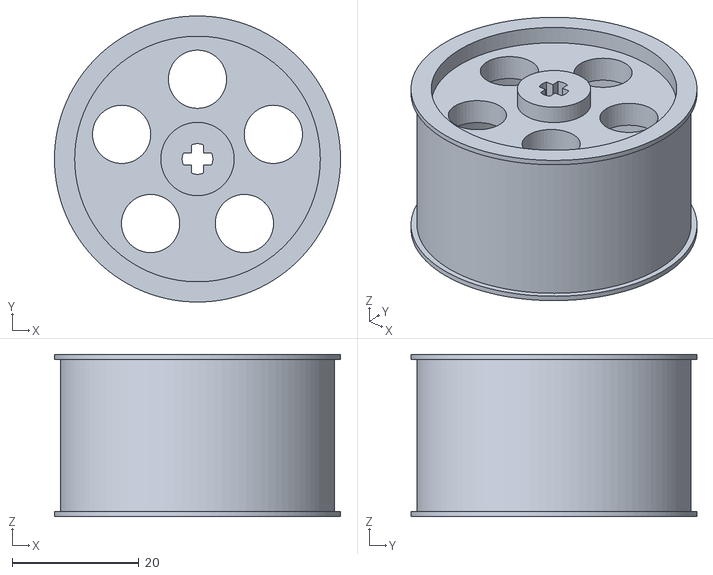
[picture p314: CAD file, 2026-10-26]
stage-1/cad/stl/SB-W56_hub.stl
45.2 x 45.2 x 25.6
