quantrpeter/semiblock-junior/stage-2/cad/step/SB-MOT-M.step

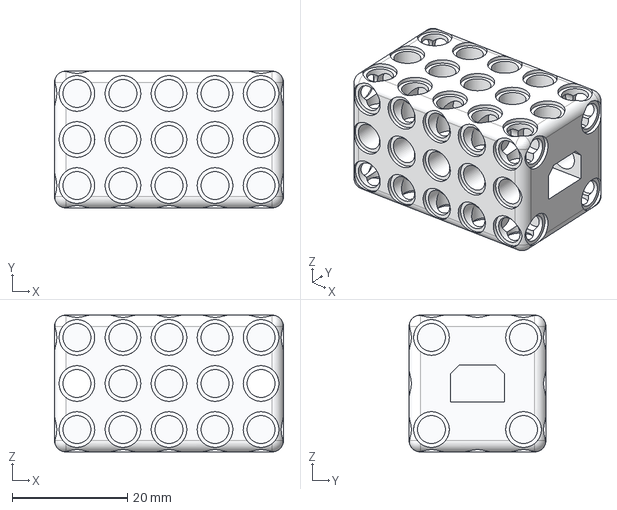
[picture p315: CAD file, 2026-10-28]
stage-2/cad/step/SB-MOT-M.step
39.8 x 23.8 x 23.8 mm
SB-MOT-M-01 shell
SB-MOT-M-02 output
