quantrpeter/semiblock-junior/stage-1/cad/stl/SB-SLIDE_base.stl

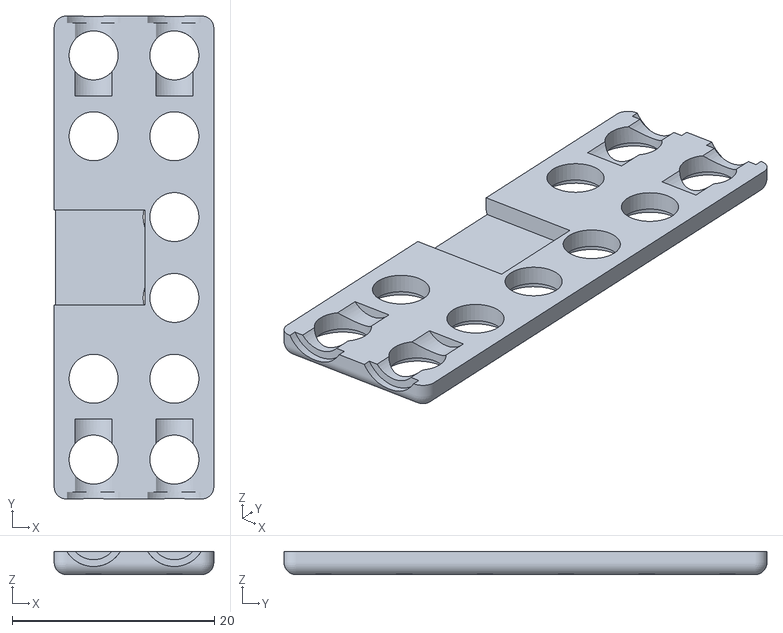
[picture p318: CAD file, 2026-10-26]
stage-1/cad/stl/SB-SLIDE_base.stl
15.8 x 47.8 x 2.30
