quantrpeter/semiblock-junior/stage-1/cad/step/SB-PUMP.step

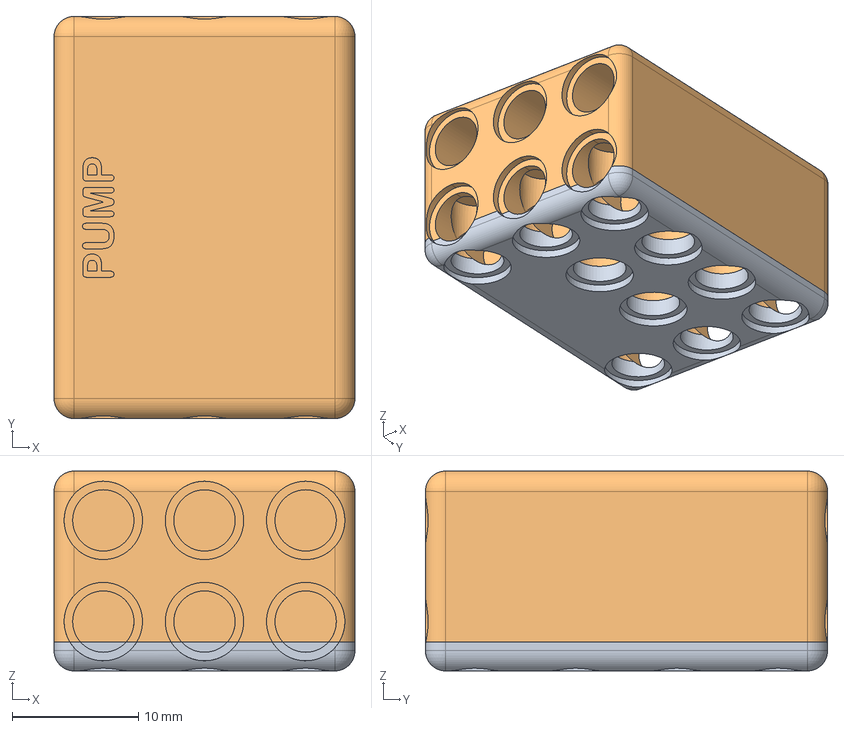
[picture p319: CAD file, 2026-10-26]
stage-1/cad/step/SB-PUMP.step
23.8 x 31.8 x 15.8 mm
