quantrpeter/semiblock-junior/stage-2/cad/step/SB-AH.step

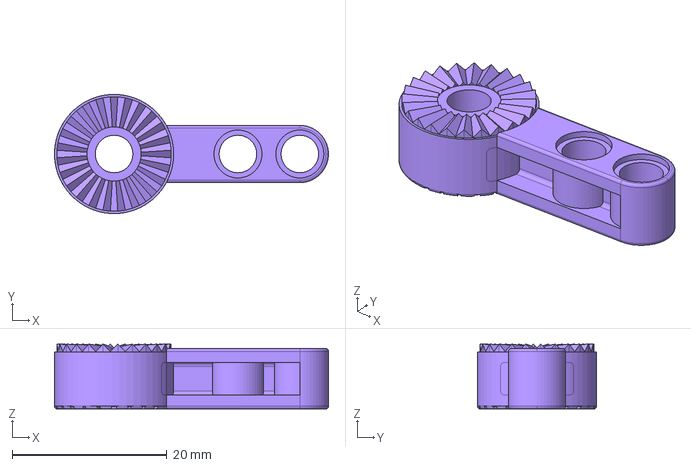
[picture p320: CAD file, 2026-10-28]
stage-2/cad/step/SB-AH.step
35.4 x 15.4 x 8.38 mm
