quantrpeter/semiblock-junior/stage-1/cad/step/SB-MATRIX.step

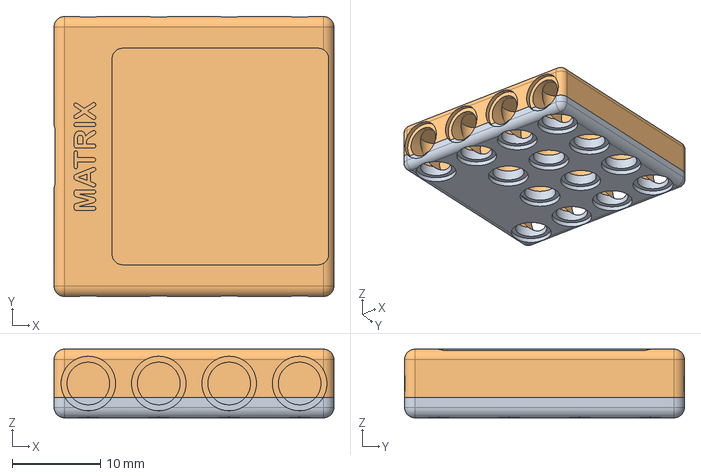
[picture p321: CAD file, 2026-10-26]
stage-1/cad/step/SB-MATRIX.step
31.8 x 31.8 x 7.80 mm
