quantrpeter/semiblock-junior/stage-2/cad/step/SB-A03.step

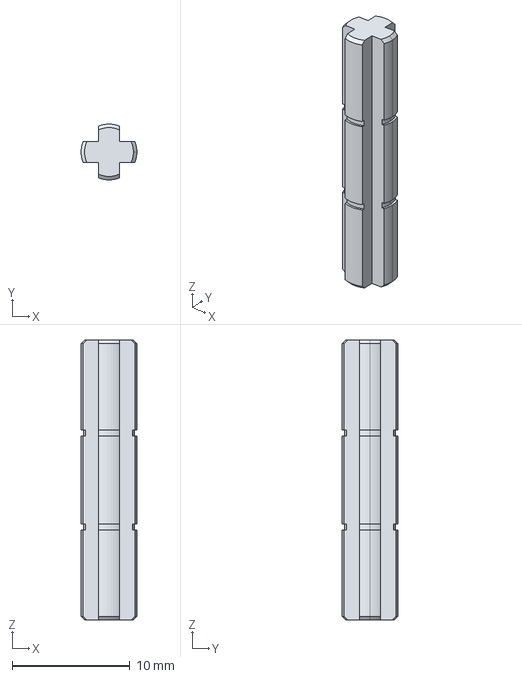
[picture p322: CAD file, 2026-10-28]
stage-2/cad/step/SB-A03.step
4.75 x 4.74 x 23.8 mm
