quantrpeter/semiblock-junior/stage-2/cad/stl/SB-JOY_cover.stl

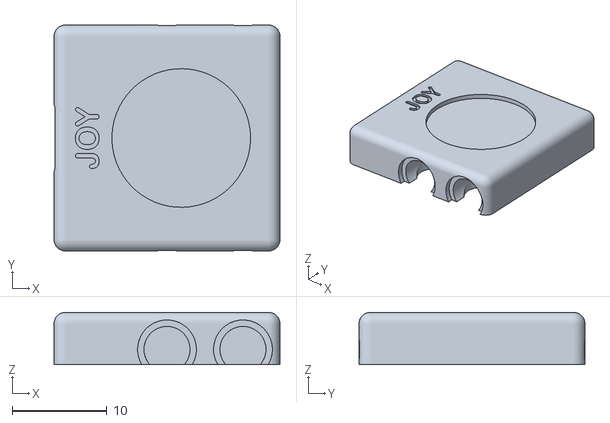
[picture p323: CAD file, 2026-10-27]
stage-2/cad/stl/SB-JOY_cover.stl
23.8 x 23.8 x 5.50
