quantrpeter/semiblock-junior/stage-1/cad/step/SB-FAN.step

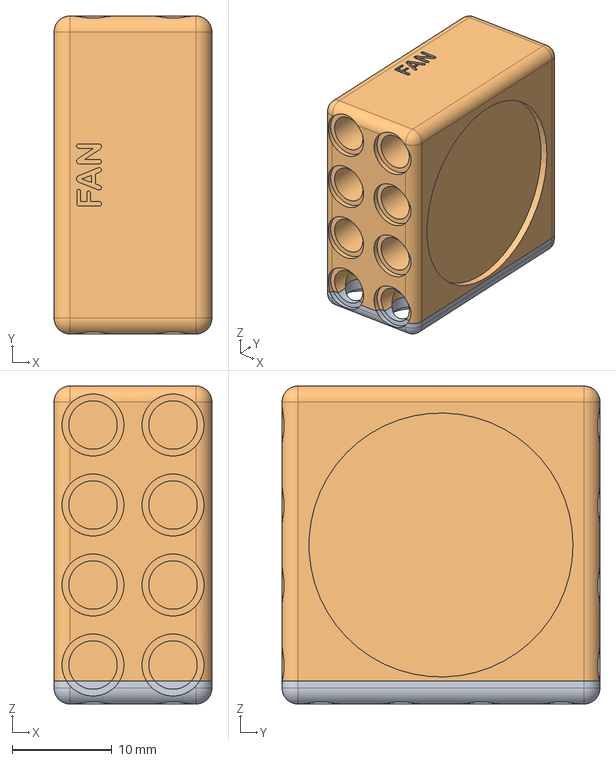
[picture p324: CAD file, 2026-10-26]
stage-1/cad/step/SB-FAN.step
15.8 x 31.8 x 31.8 mm
