quantrpeter/semiblock-junior/stage-1/cad/stl/SB-S-US_base.stl

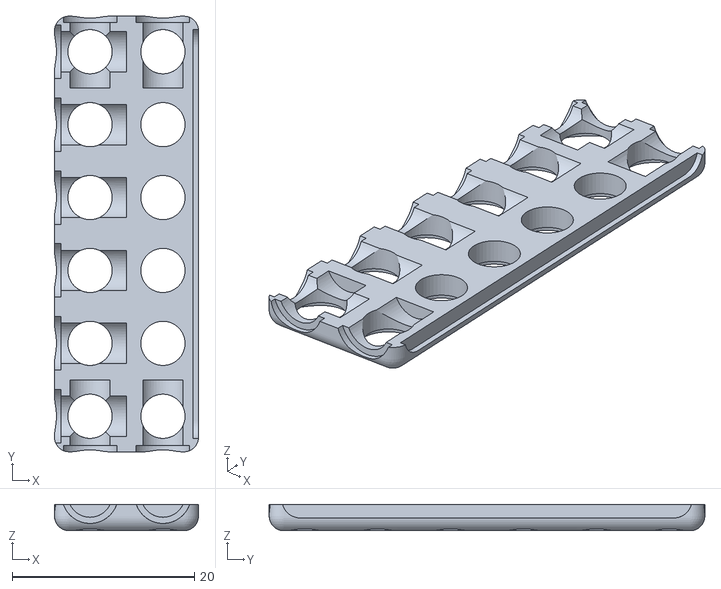
[picture p325: CAD file, 2026-10-26]
stage-1/cad/stl/SB-S-US_base.stl
15.8 x 47.8 x 2.90
