quantrpeter/semiblock-junior/stage-2/cad/stl/SB-CAM_cover.stl

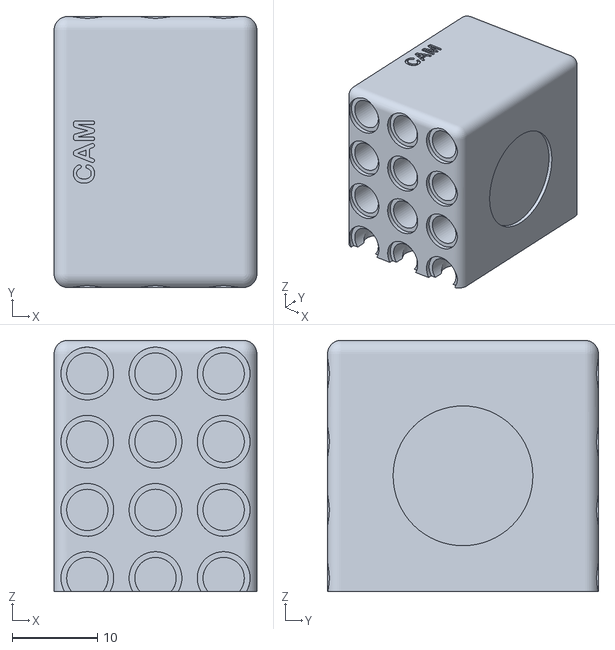
[picture p326: CAD file, 2026-10-27]
stage-2/cad/stl/SB-CAM_cover.stl
23.8 x 31.8 x 29.5
