quantrpeter/semiblock-junior/stage-1/cad/stl/SB-CO2_base.stl

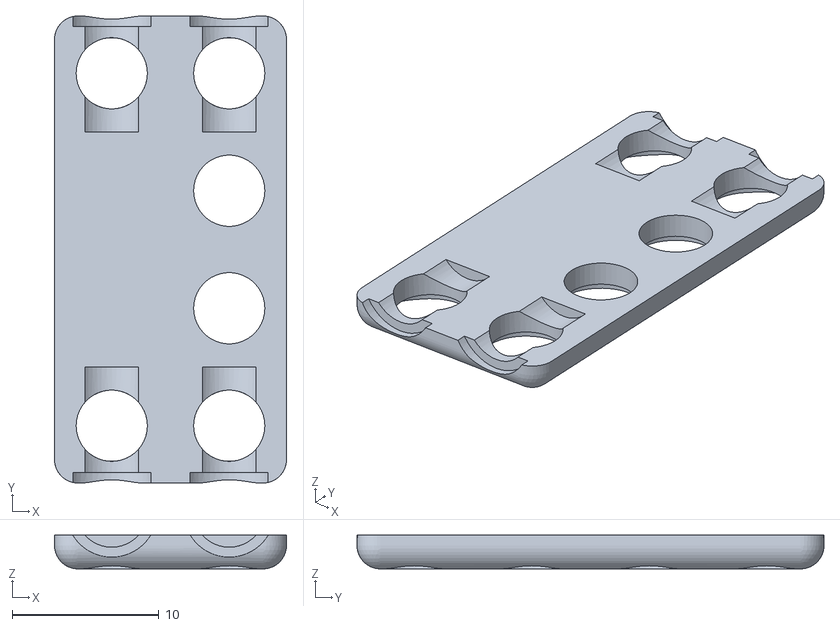
[picture p327: CAD file, 2026-10-26]
stage-1/cad/stl/SB-CO2_base.stl
15.8 x 31.8 x 2.30
