quantrpeter/semiblock-junior/stage-2/cad/stl/SB-TL3S_sleeve.stl

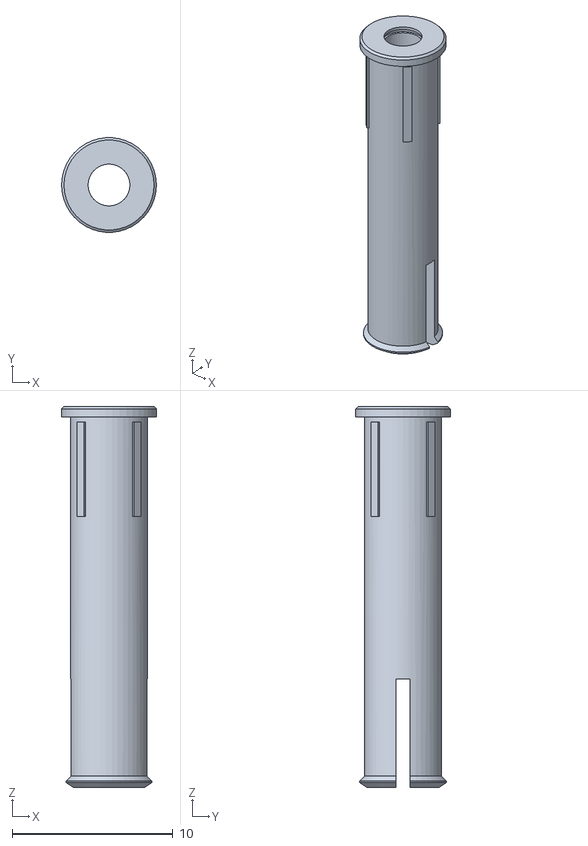
[picture p328: CAD file, 2026-10-27]
stage-2/cad/stl/SB-TL3S_sleeve.stl
5.90 x 5.88 x 23.7
