quantrpeter/semiblock-junior/stage-1/cad/step/SB-L35.step

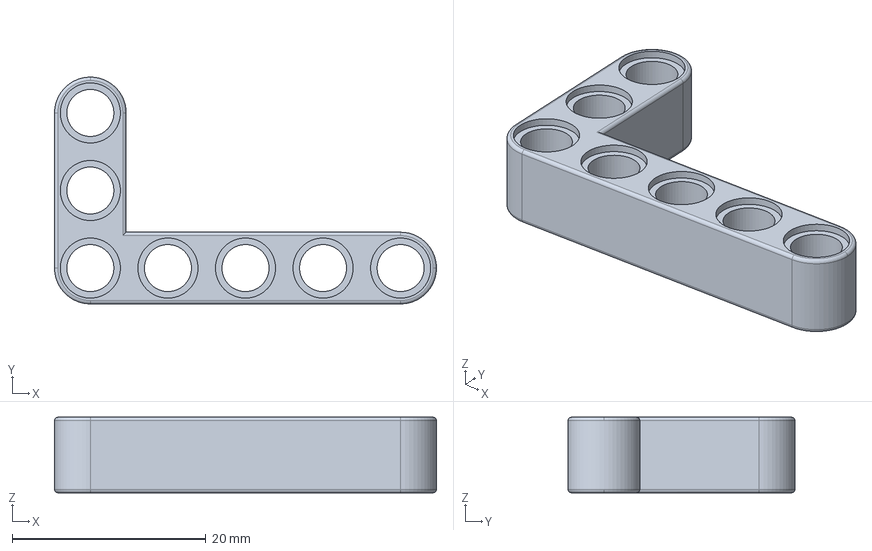
[picture p329: CAD file, 2026-10-26]
stage-1/cad/step/SB-L35.step
39.4 x 23.4 x 7.80 mm
