quantrpeter/semiblock-junior/stage-2/cad/step/SB-B05.step

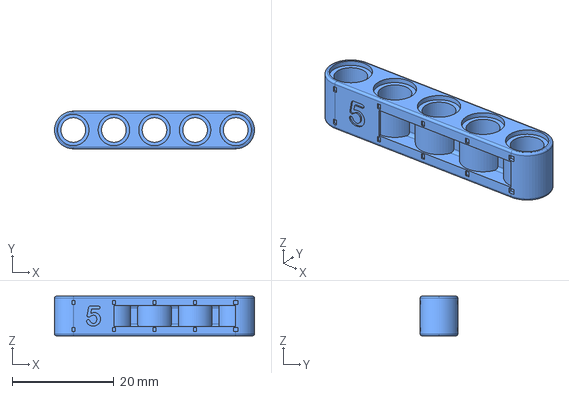
[picture p330: CAD file, 2026-10-28]
stage-2/cad/step/SB-B05.step
39.4 x 7.40 x 7.80 mm
