quantrpeter/semiblock-junior/stage-2/cad/stl/SB-THERM_base.stl

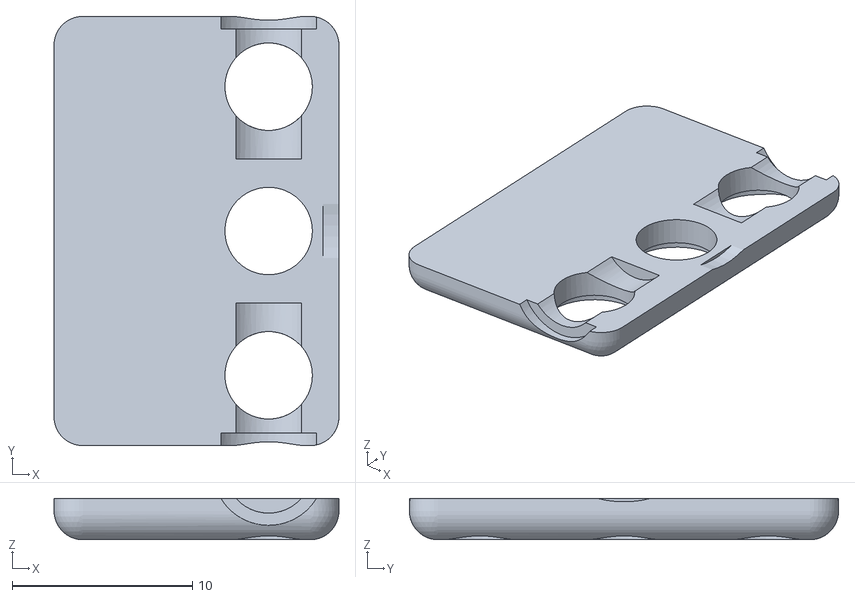
[picture p331: CAD file, 2026-10-27]
stage-2/cad/stl/SB-THERM_base.stl
15.8 x 23.8 x 2.30
