quantrpeter/semiblock-junior/stage-1/cad/stl/SB-SV180_cover.stl

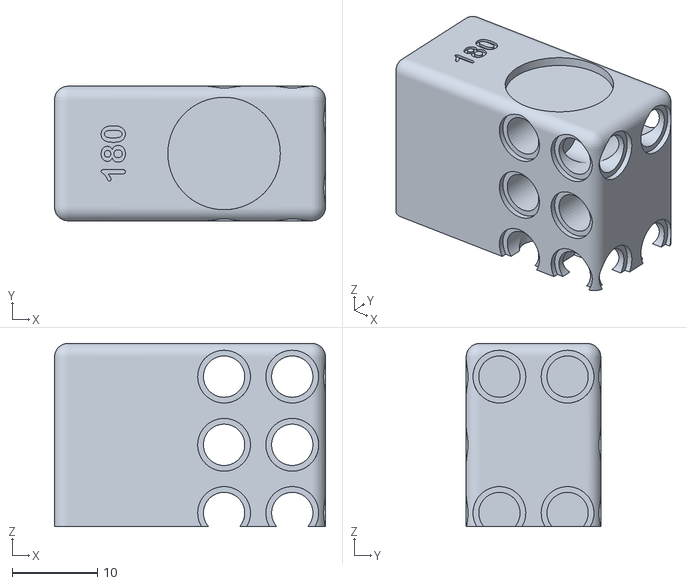
[picture p332: CAD file, 2026-10-26]
stage-1/cad/stl/SB-SV180_cover.stl
31.8 x 15.8 x 21.5
