quantrpeter/semiblock-junior/stage-2/cad/step/SB-A10.step

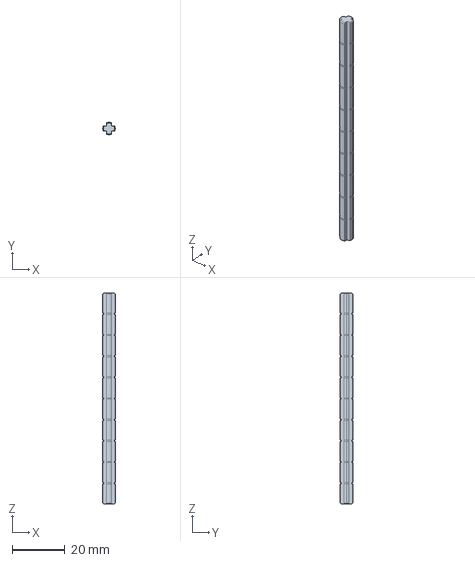
[picture p333: CAD file, 2026-10-28]
stage-2/cad/step/SB-A10.step
4.75 x 4.74 x 79.8 mm
