quantrpeter/semiblock-junior/stage-1/cad/step/SB-XP2.step

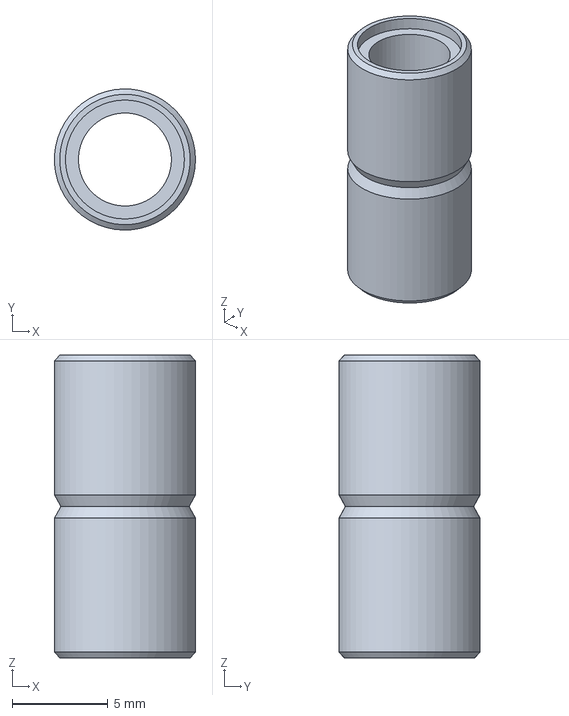
[picture p334: CAD file, 2026-10-26]
stage-1/cad/step/SB-XP2.step
7.35 x 7.36 x 15.8 mm
