quantrpeter/semiblock-junior/stage-1/cad/stl/SB-POT_base.stl

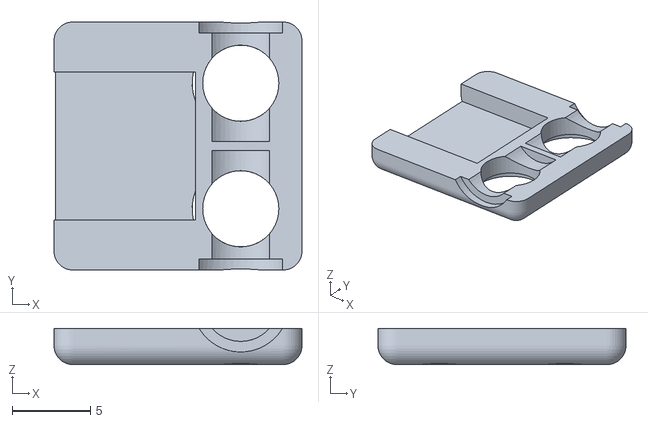
[picture p335: CAD file, 2026-10-26]
stage-1/cad/stl/SB-POT_base.stl
15.8 x 15.8 x 2.30
