quantrpeter/semiblock-junior/stage-2/cad/stl/SB-WM60L_hub.stl

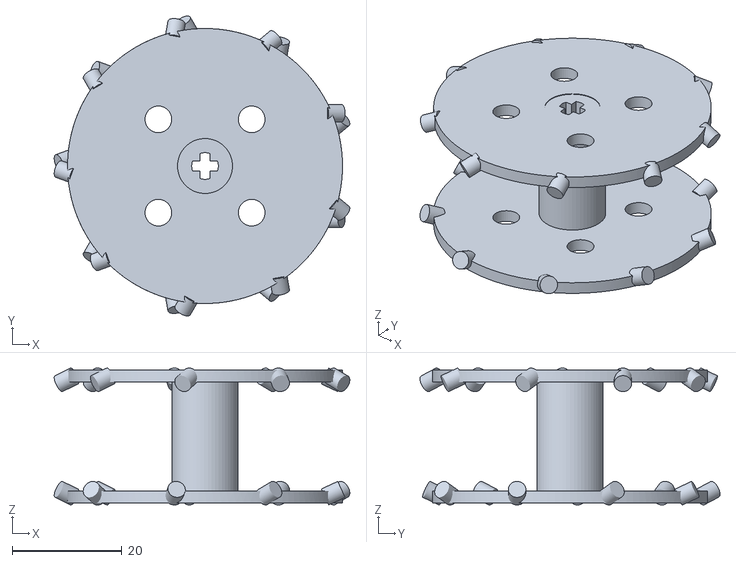
[picture p336: CAD file, 2026-10-27]
stage-2/cad/stl/SB-WM60L_hub.stl
53.8 x 54.5 x 24.9
