quantrpeter/semiblock-junior/stage-1/cad/step/SB-BU0.step

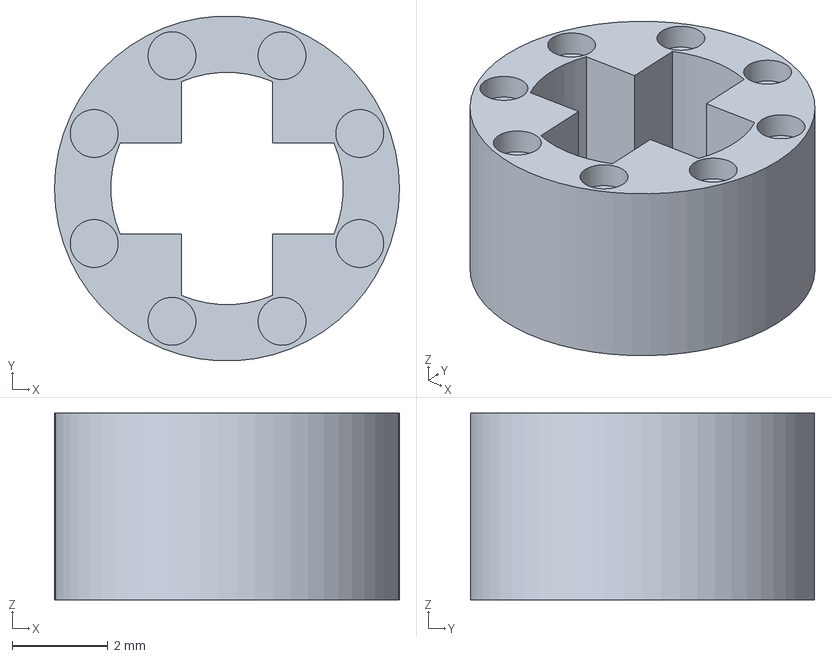
[picture p337: CAD file, 2026-10-26]
stage-1/cad/step/SB-BU0.step
7.20 x 7.19 x 3.90 mm
