quantrpeter/semiblock-junior/stage-1/cad/stl/SB-SEG_base.stl

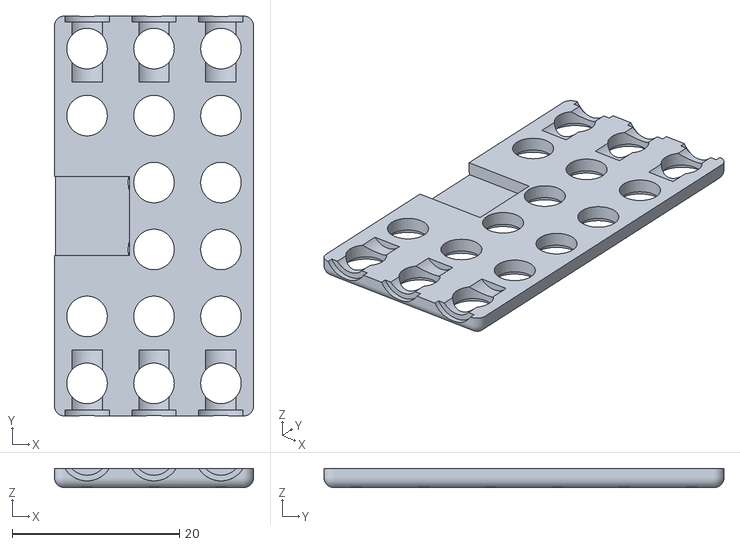
[picture p338: CAD file, 2026-10-26]
stage-1/cad/stl/SB-SEG_base.stl
23.8 x 47.8 x 2.30
