quantrpeter/semiblock-junior/stage-2/cad/step/SB-QP2.step

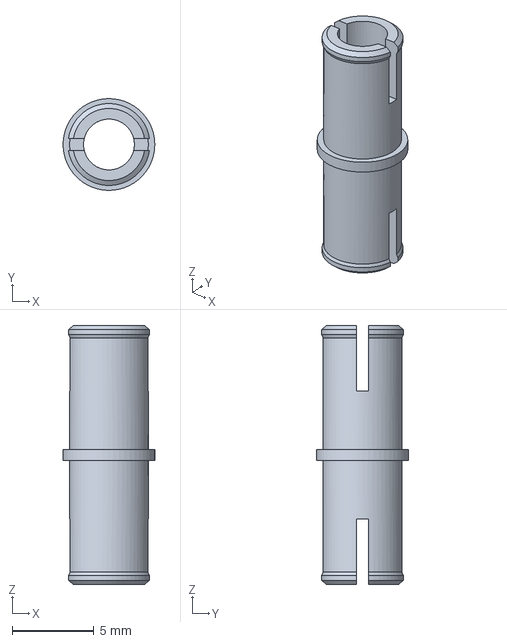
[picture p339: CAD file, 2026-10-28]
stage-2/cad/step/SB-QP2.step
5.59 x 5.60 x 15.8 mm
