quantrpeter/semiblock-junior/stage-2/cad/stl/SB-WM60R_rollers.stl

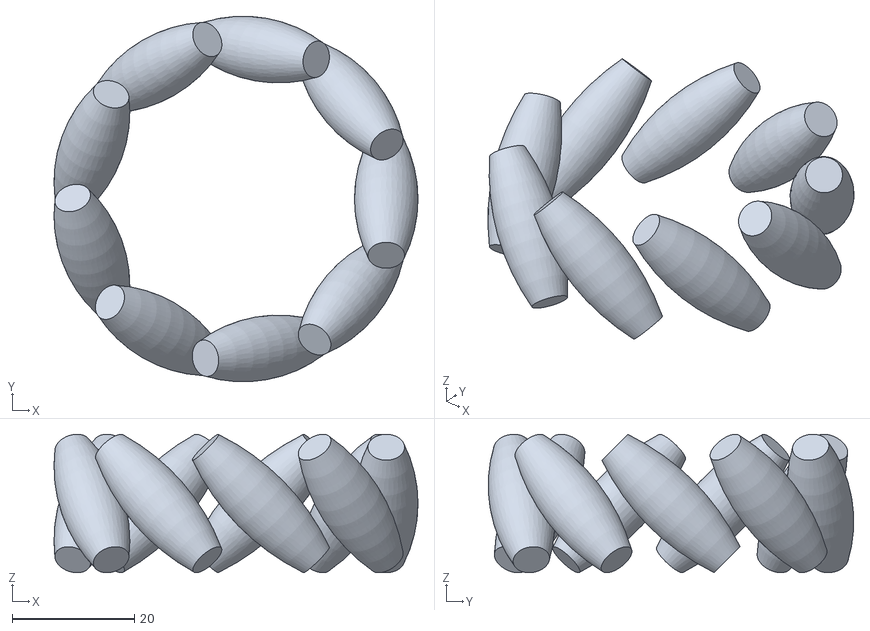
[picture p340: CAD file, 2026-10-27]
stage-2/cad/stl/SB-WM60R_rollers.stl
59.5 x 59.7 x 22.6
