quantrpeter/semiblock-junior/stage-1/cad/stl/SB-TC1_ring.stl

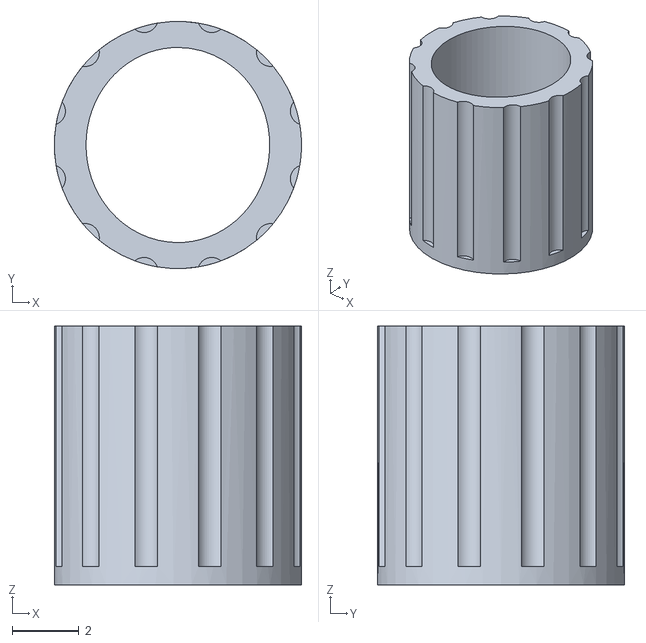
[picture p341: CAD file, 2026-10-26]
stage-1/cad/stl/SB-TC1_ring.stl
7.39 x 7.40 x 7.75
