quantrpeter/semiblock-junior/stage-2/cad/step/SB-JOY.step

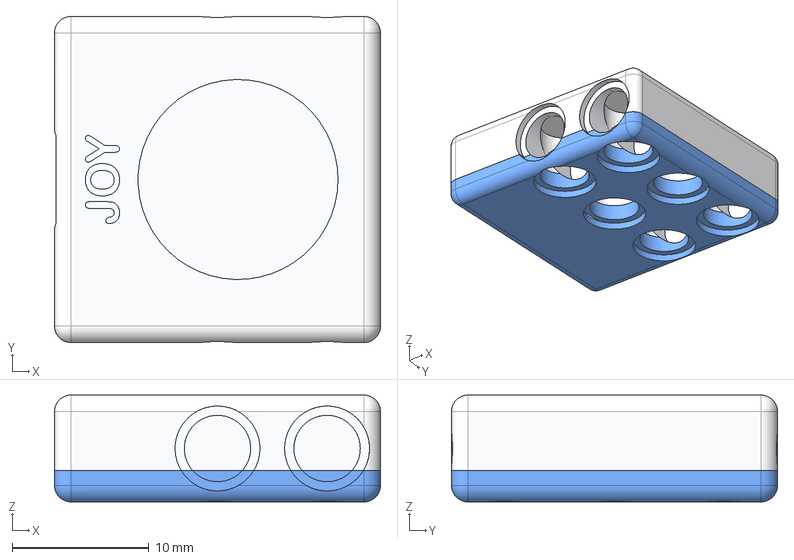
[picture p342: CAD file, 2026-10-28]
stage-2/cad/step/SB-JOY.step
23.8 x 23.8 x 7.80 mm
SB-JOY-01 base
SB-JOY-02 cover
