quantrpeter/semiblock-junior/stage-1/cad/step/SB-XC12.step

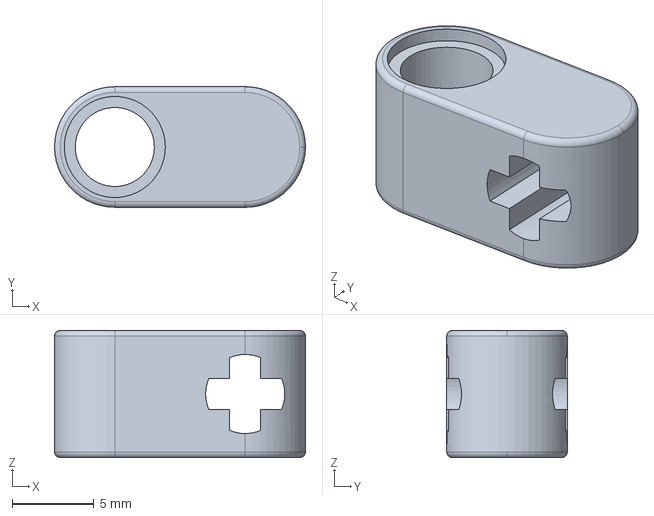
[picture p344: CAD file, 2026-10-26]
stage-1/cad/step/SB-XC12.step
15.4 x 7.40 x 7.80 mm
