quantrpeter/semiblock-junior/stage-1/cad/stl/SB-CASTER_block.stl

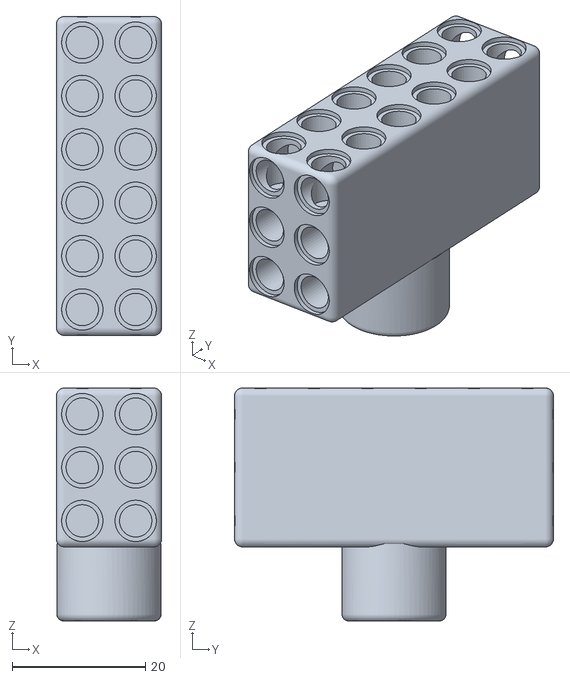
[picture p345: CAD file, 2026-10-26]
stage-1/cad/stl/SB-CASTER_block.stl
15.8 x 47.8 x 34.9
