quantrpeter/semiblock-junior/stage-2/cad/stl/SB-TT7_retainer.stl

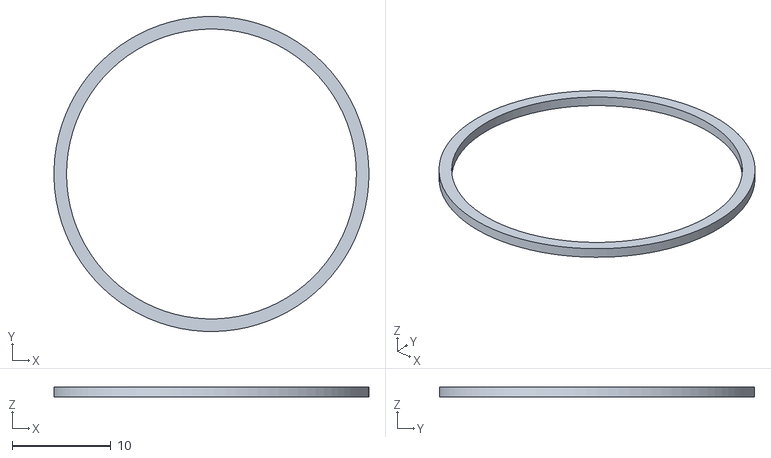
[picture p346: CAD file, 2026-10-27]
stage-2/cad/stl/SB-TT7_retainer.stl
32.0 x 32.0 x 1.00
