quantrpeter/semiblock-junior/stage-1/cad/step/SB-A04S.step

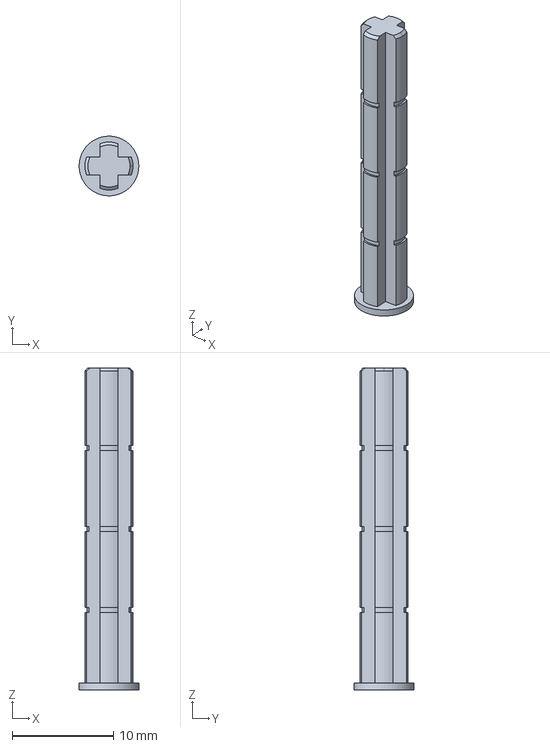
[picture p347: CAD file, 2026-10-26]
stage-1/cad/step/SB-A04S.step
5.89 x 5.90 x 31.8 mm
