quantrpeter/semiblock-junior/stage-1/cad/stl/SB-S-LINE_cover.stl

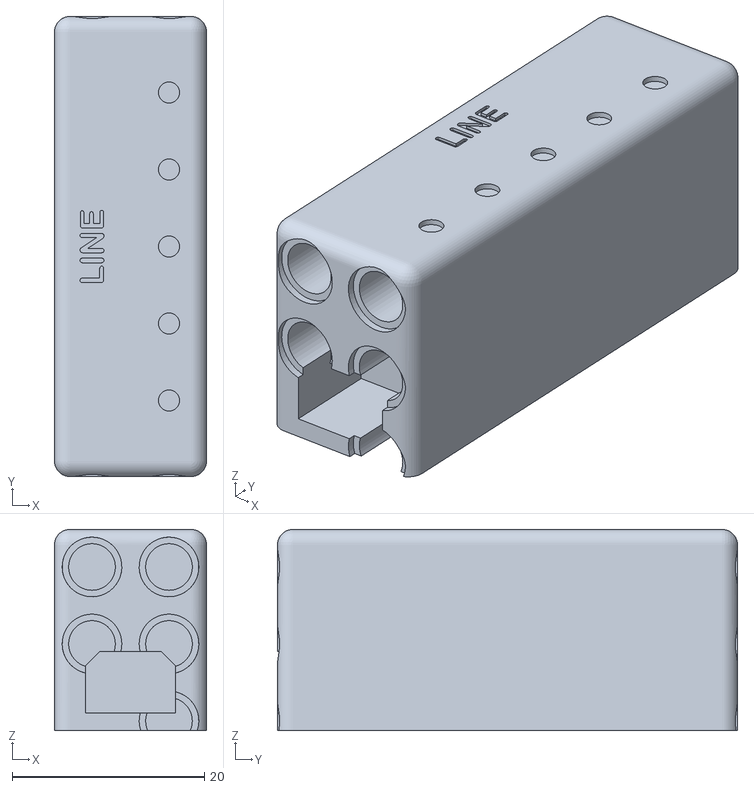
[picture p348: CAD file, 2026-10-26]
stage-1/cad/stl/SB-S-LINE_cover.stl
15.8 x 47.8 x 20.9
