quantrpeter/semiblock-junior/stage-2/cad/step/SB-S05.step

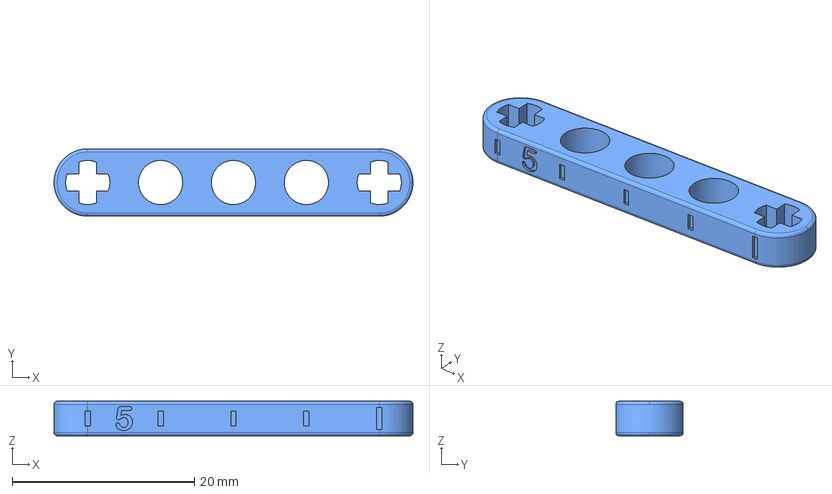
[picture p349: CAD file, 2026-10-28]
stage-2/cad/step/SB-S05.step
39.4 x 7.40 x 3.80 mm
