quantrpeter/semiblock-junior/stage-2/cad/stl/SB-ANGLE_base.stl

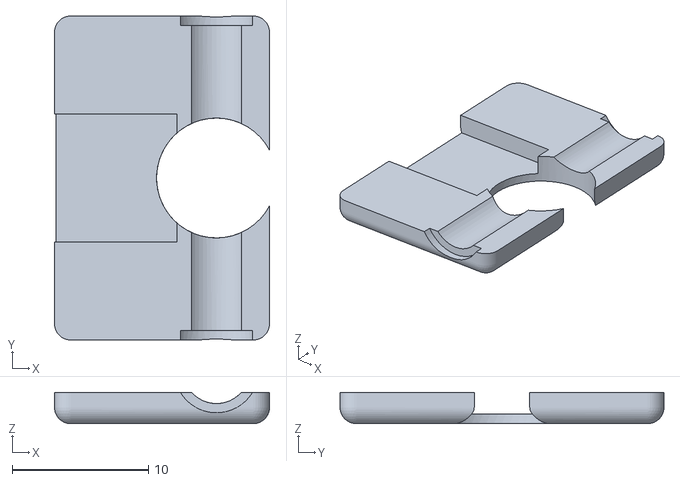
[picture p350: CAD file, 2026-10-27]
stage-2/cad/stl/SB-ANGLE_base.stl
15.8 x 23.8 x 2.30
