quantrpeter/semiblock-junior/stage-1/cad/step/SB-G36B.step

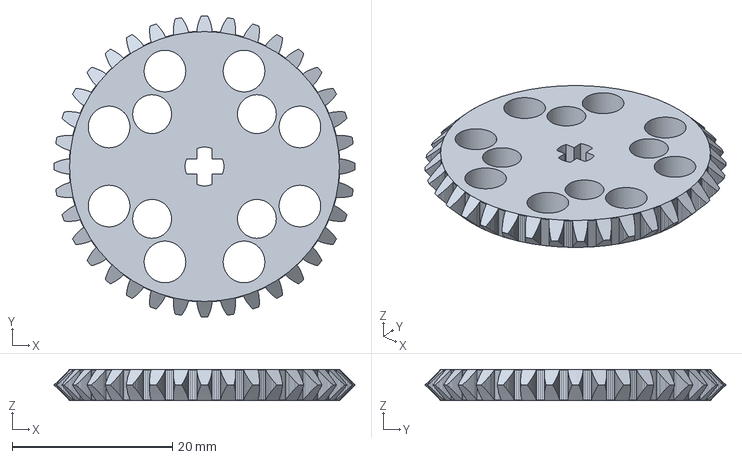
[picture p351: CAD file, 2026-10-26]
stage-1/cad/step/SB-G36B.step
37.6 x 37.6 x 3.90 mm
