quantrpeter/semiblock-junior/stage-2/cad/step/SB-GR4.step

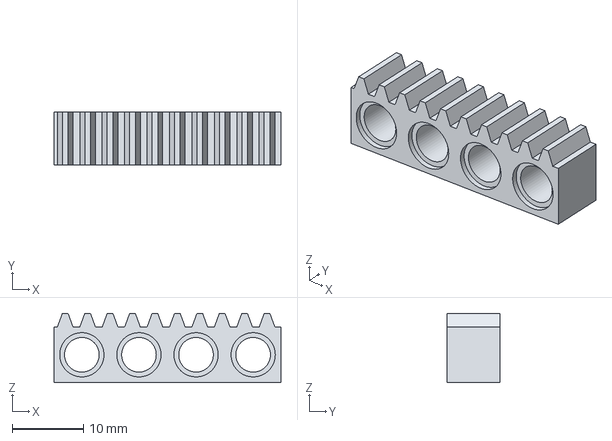
[picture p352: CAD file, 2026-10-28]
stage-2/cad/step/SB-GR4.step
31.8 x 7.40 x 9.70 mm
