quantrpeter/semiblock-junior/stage-2/cad/stl/SB-TT7_bearing_6705.stl

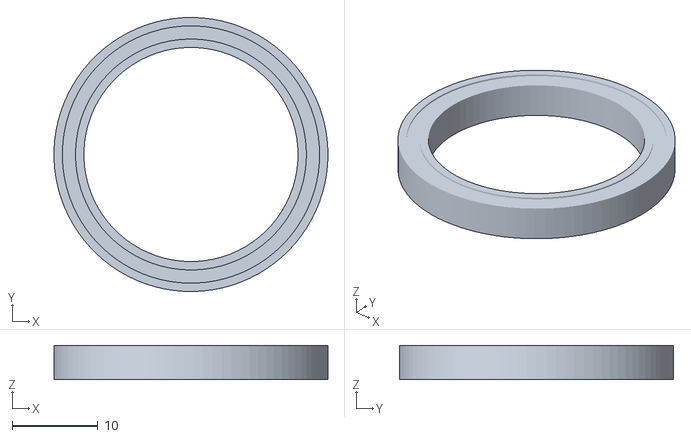
[picture p353: CAD file, 2026-10-27]
stage-2/cad/stl/SB-TT7_bearing_6705.stl
32.0 x 32.0 x 4.00
