quantrpeter/semiblock-junior/stage-1/cad/step/SB-A04.step

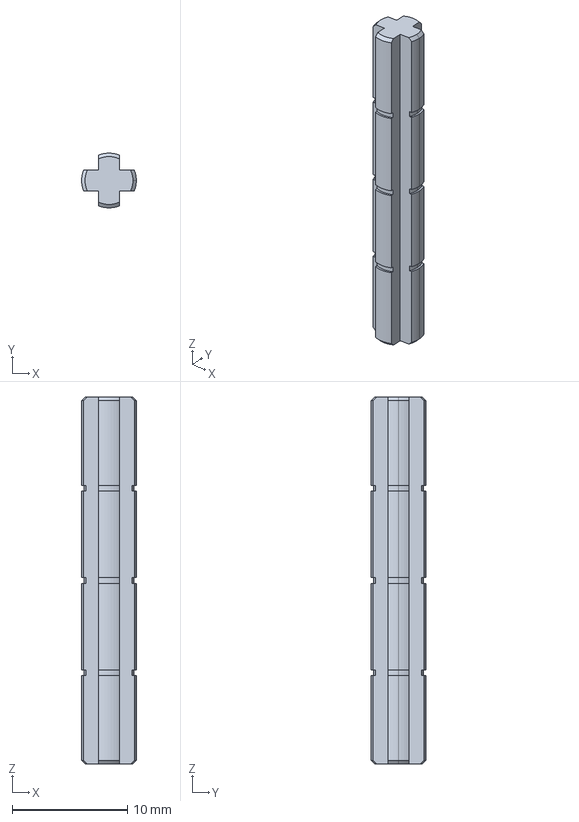
[picture p354: CAD file, 2026-10-26]
stage-1/cad/step/SB-A04.step
4.75 x 4.74 x 31.8 mm
