quantrpeter/semiblock-junior/stage-2/cad/step/SB-W56.step

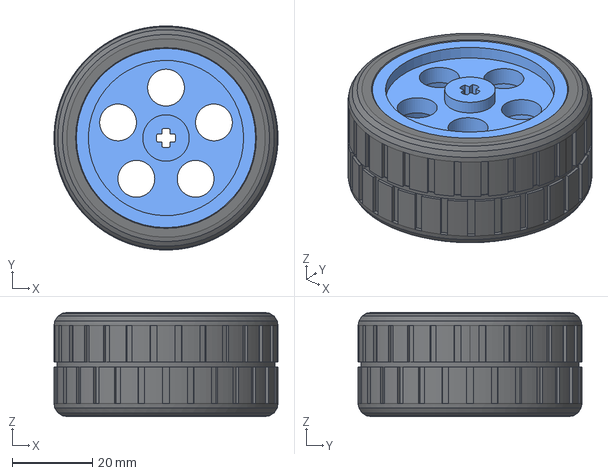
[picture p355: CAD file, 2026-10-28]
stage-2/cad/step/SB-W56.step
56.0 x 56.0 x 26.0 mm
SB-W56-01 hub
SB-W56-02 tire
