quantrpeter/semiblock-junior/stage-1/cad/step/SB-F57.step

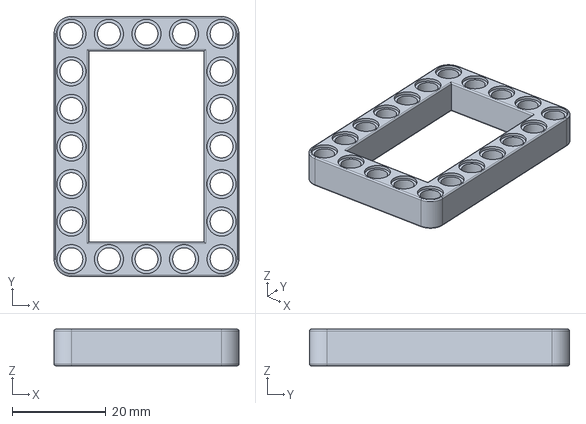
[picture p356: CAD file, 2026-10-26]
stage-1/cad/step/SB-F57.step
39.4 x 55.4 x 7.80 mm
