quantrpeter/semiblock-junior/stage-2/cad/step/SB-PX.step

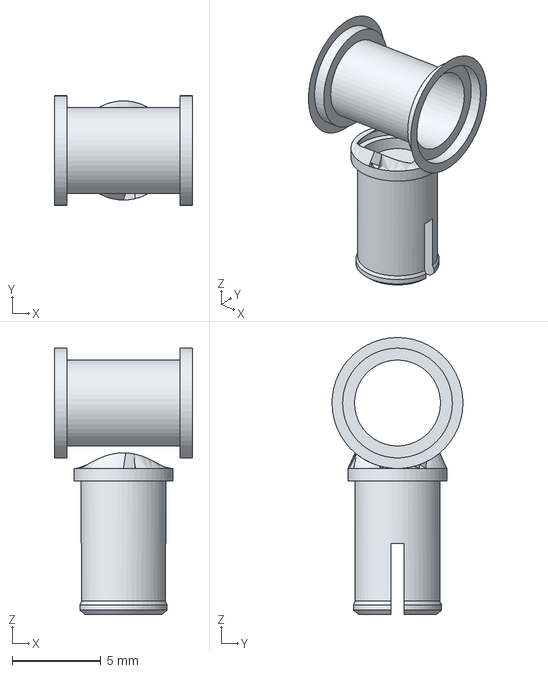
[picture p357: CAD file, 2026-10-28]
stage-2/cad/step/SB-PX.step
7.80 x 7.40 x 15.7 mm
