quantrpeter/semiblock-junior/stage-2/cad/stl/SB-BR5_housing.stl

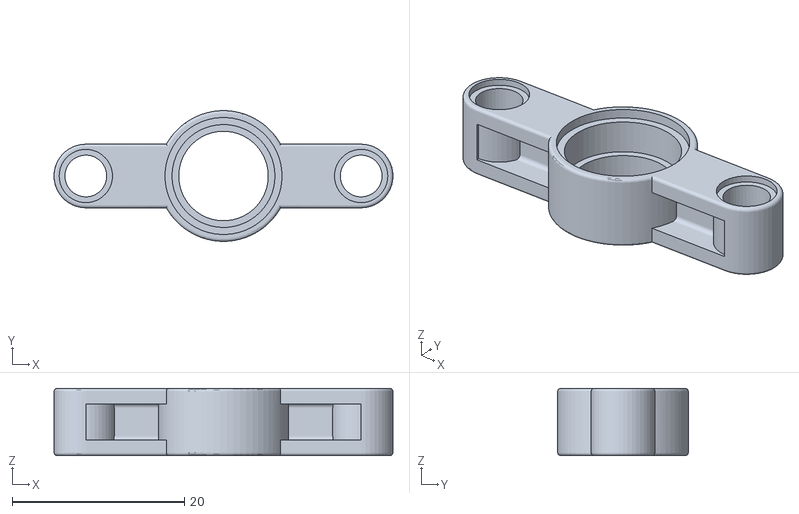
[picture p358: CAD file, 2026-10-27]
stage-2/cad/stl/SB-BR5_housing.stl
39.4 x 15.2 x 7.80
