quantrpeter/semiblock-junior/stage-2/cad/step/SB-PM.step

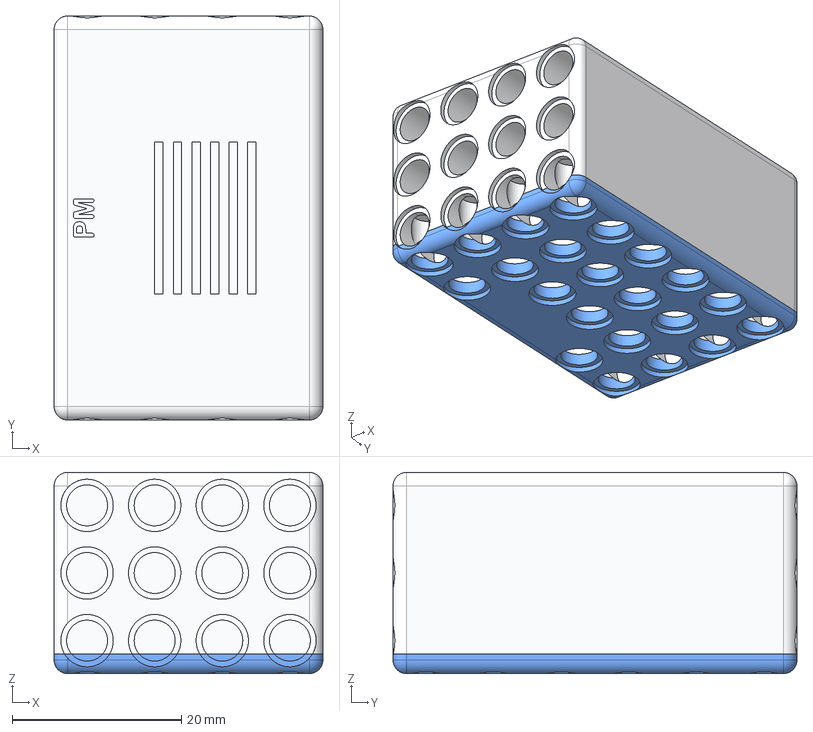
[picture p359: CAD file, 2026-10-28]
stage-2/cad/step/SB-PM.step
31.8 x 47.8 x 23.8 mm
SB-PM-01 base
SB-PM-02 cover
