quantrpeter/semiblock-junior/stage-2/cad/stl/SB-LINE_base.stl

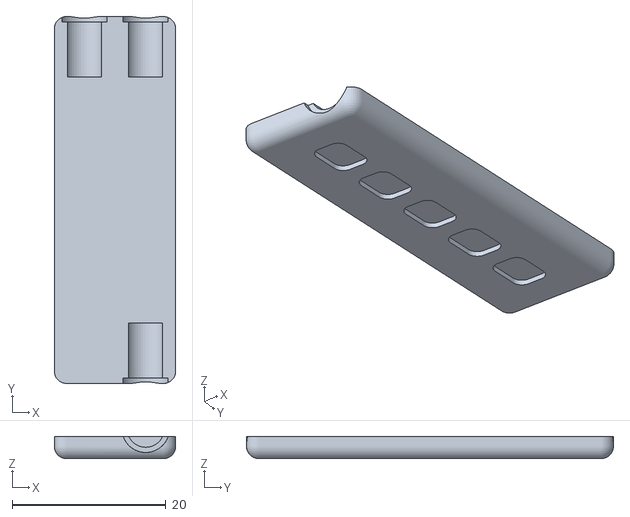
[picture p360: CAD file, 2026-10-27]
stage-2/cad/stl/SB-LINE_base.stl
15.8 x 47.8 x 2.90
