quantrpeter/semiblock-junior/stage-1/cad/step/SB-A07.step

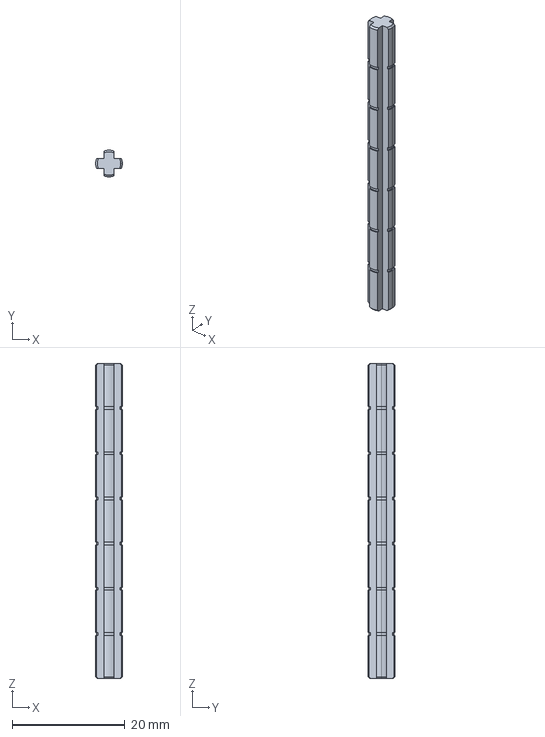
[picture p361: CAD file, 2026-10-26]
stage-1/cad/step/SB-A07.step
4.75 x 4.74 x 55.8 mm
