quantrpeter/semiblock-junior/stage-1/cad/stl/SB-HUB_button_l.stl

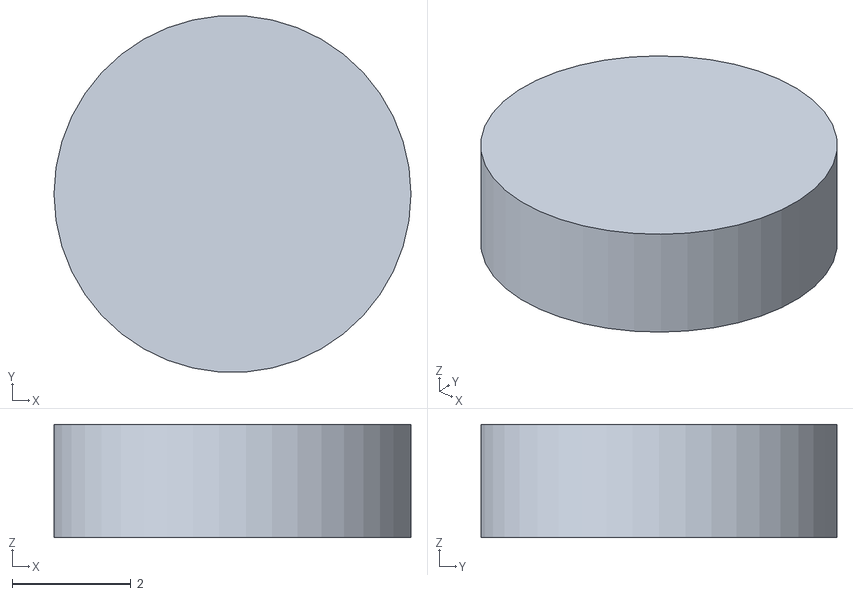
[picture p362: CAD file, 2026-10-26]
stage-1/cad/stl/SB-HUB_button_l.stl
6.00 x 5.98 x 1.90
