quantrpeter/semiblock-junior/stage-2/cad/step/SB-A02.step

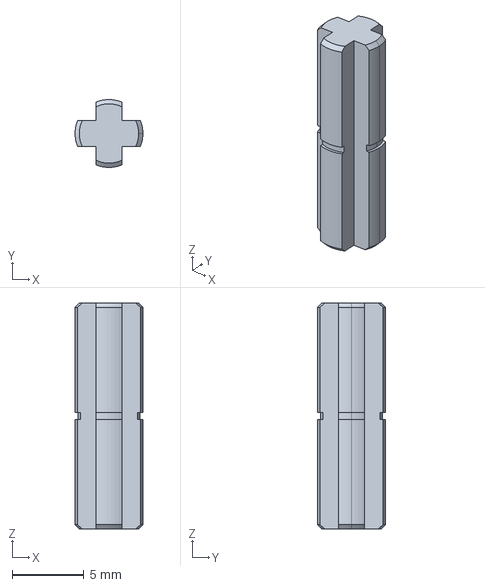
[picture p363: CAD file, 2026-10-28]
stage-2/cad/step/SB-A02.step
4.75 x 4.74 x 15.8 mm
