quantrpeter/semiblock-junior/stage-1/cad/step/SB-K46.step

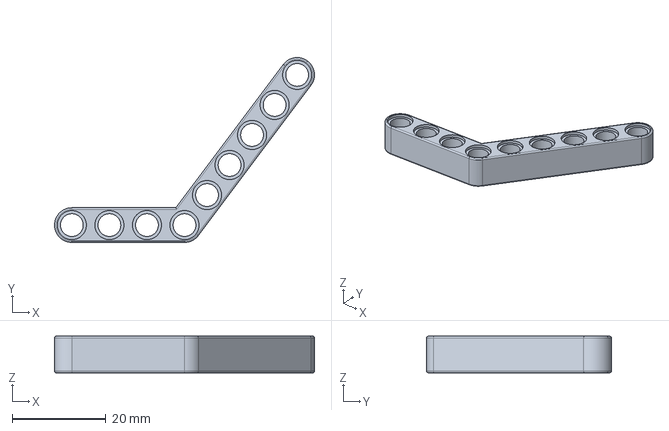
[picture p364: CAD file, 2026-10-26]
stage-1/cad/step/SB-K46.step
55.4 x 39.4 x 7.80 mm
