quantrpeter/semiblock-junior/stage-2/cad/stl/SB-KEYPAD_cover.stl

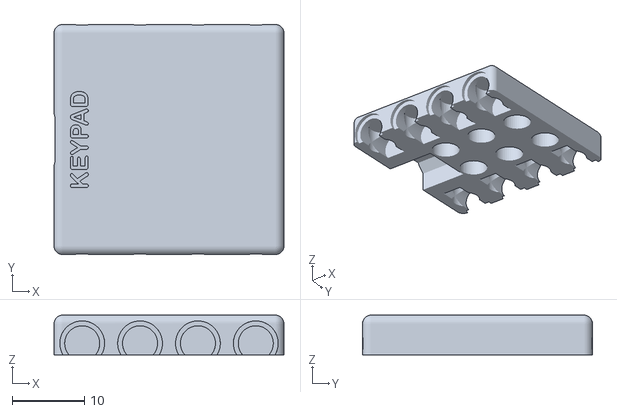
[picture p365: CAD file, 2026-10-27]
stage-2/cad/stl/SB-KEYPAD_cover.stl
31.8 x 31.8 x 5.50
