quantrpeter/semiblock-junior/stage-2/cad/step/SB-CO2.step

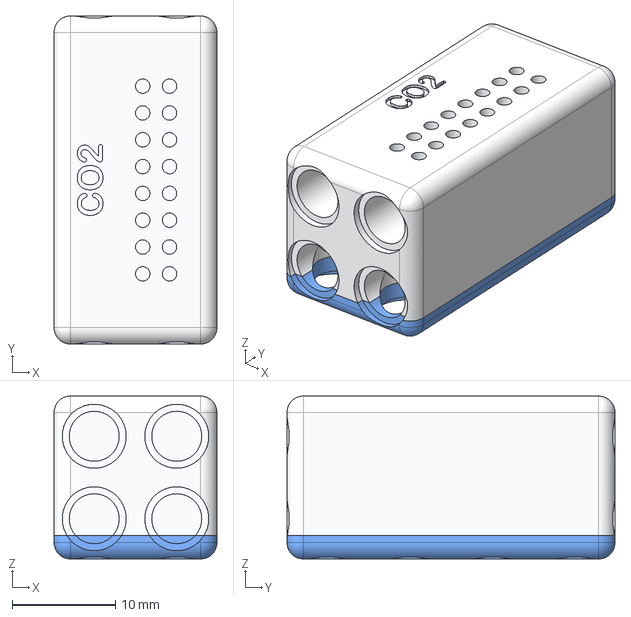
[picture p366: CAD file, 2026-10-28]
stage-2/cad/step/SB-CO2.step
15.8 x 31.8 x 15.8 mm
SB-CO2-01 base
SB-CO2-02 cover
