quantrpeter/semiblock-junior/stage-2/cad/stl/SB-PM_cover.stl

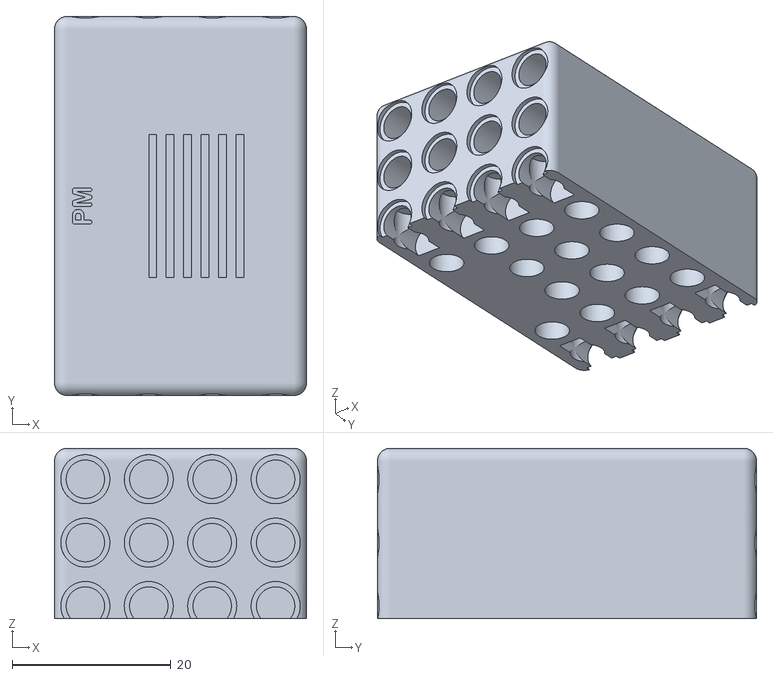
[picture p367: CAD file, 2026-10-27]
stage-2/cad/stl/SB-PM_cover.stl
31.8 x 47.8 x 21.5
