quantrpeter/semiblock-junior/stage-1/cad/step/SB-G16.step

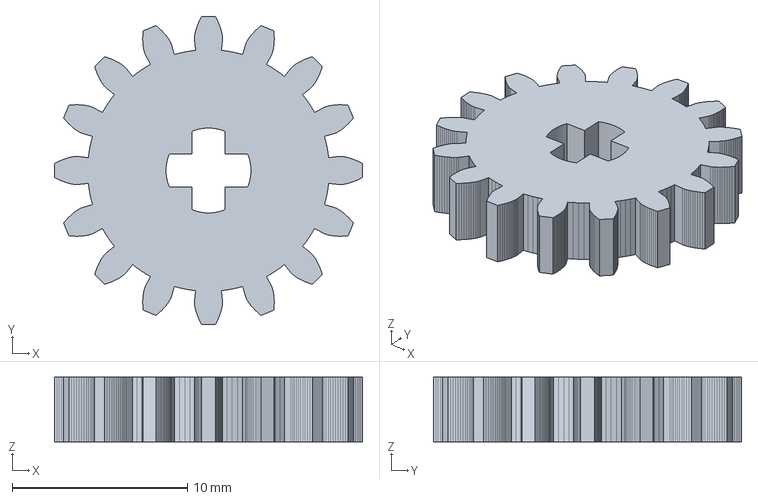
[picture p368: CAD file, 2026-10-26]
stage-1/cad/step/SB-G16.step
17.6 x 17.6 x 3.70 mm
