quantrpeter/semiblock-junior/stage-1/cad/stl/SB-WM60R_hub.stl

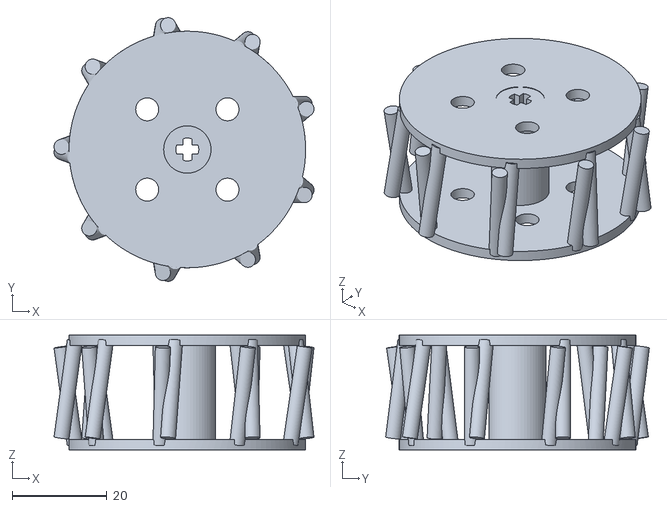
[picture p369: CAD file, 2026-10-26]
stage-1/cad/stl/SB-WM60R_hub.stl
54.9 x 55.7 x 24.2
