quantrpeter/semiblock-junior/stage-2/cad/step/SB-G24C.step

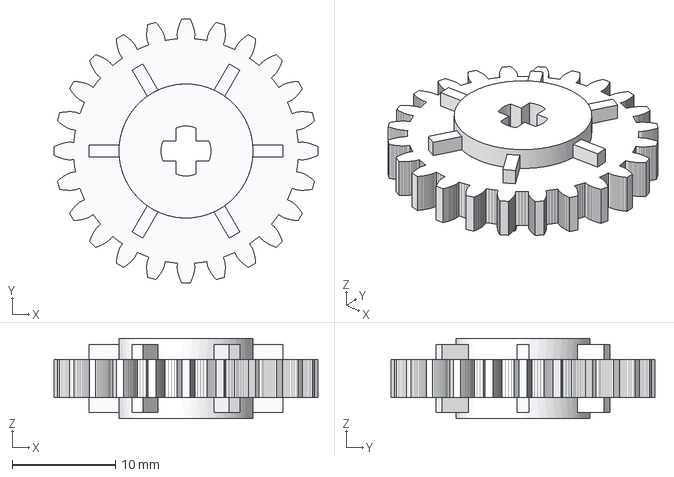
[picture p370: CAD file, 2026-10-28]
stage-2/cad/step/SB-G24C.step
25.6 x 25.6 x 7.80 mm
