quantrpeter/semiblock-junior/stage-1/cad/step/SB-B03.step

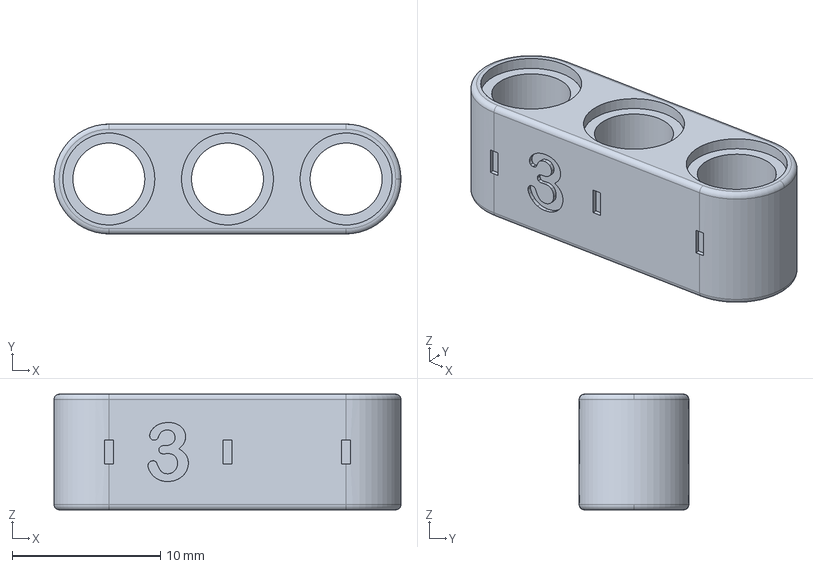
[picture p371: CAD file, 2026-10-26]
stage-1/cad/step/SB-B03.step
23.4 x 7.40 x 7.80 mm
