quantrpeter/semiblock-junior/stage-1/cad/stl/SB-TRAFFIC_base.stl

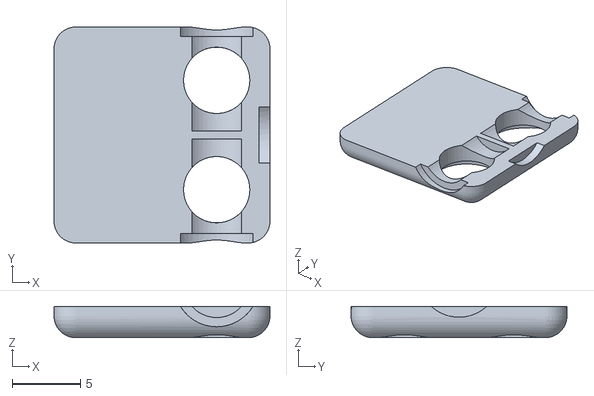
[picture p372: CAD file, 2026-10-26]
stage-1/cad/stl/SB-TRAFFIC_base.stl
15.8 x 15.8 x 2.30
