quantrpeter/semiblock-junior/stage-1/cad/stl/SB-PM_base.stl

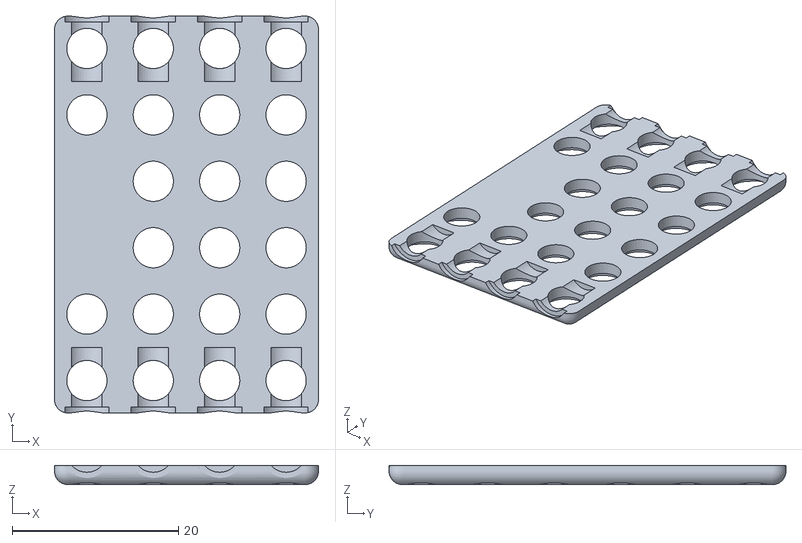
[picture p373: CAD file, 2026-10-26]
stage-1/cad/stl/SB-PM_base.stl
31.8 x 47.8 x 2.30
