quantrpeter/semiblock-junior/stage-2/cad/step/SB-BP.step

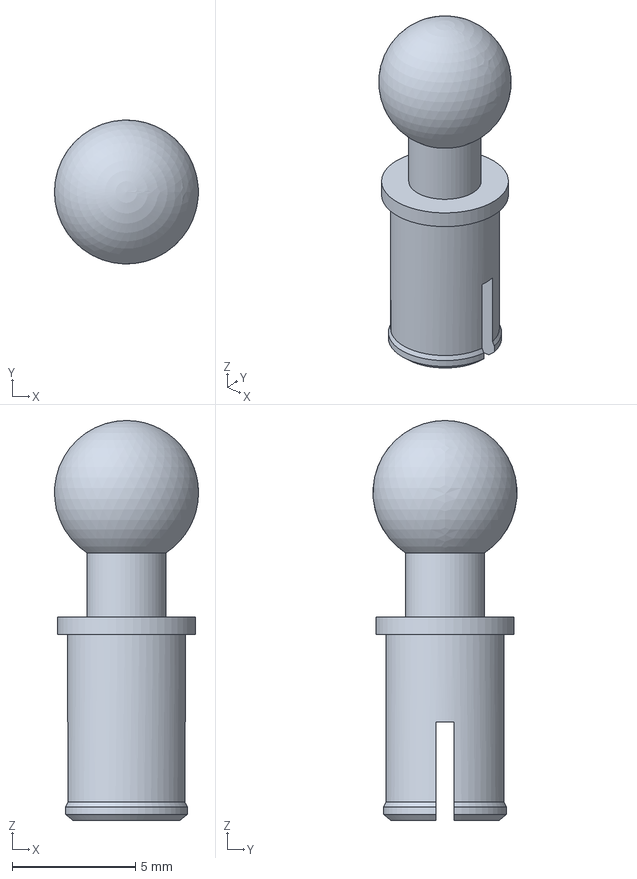
[picture p374: CAD file, 2026-10-28]
stage-2/cad/step/SB-BP.step
5.84 x 5.83 x 16.2 mm
