quantrpeter/semiblock-junior/stage-1/cad/step/SB-ANGLE.step

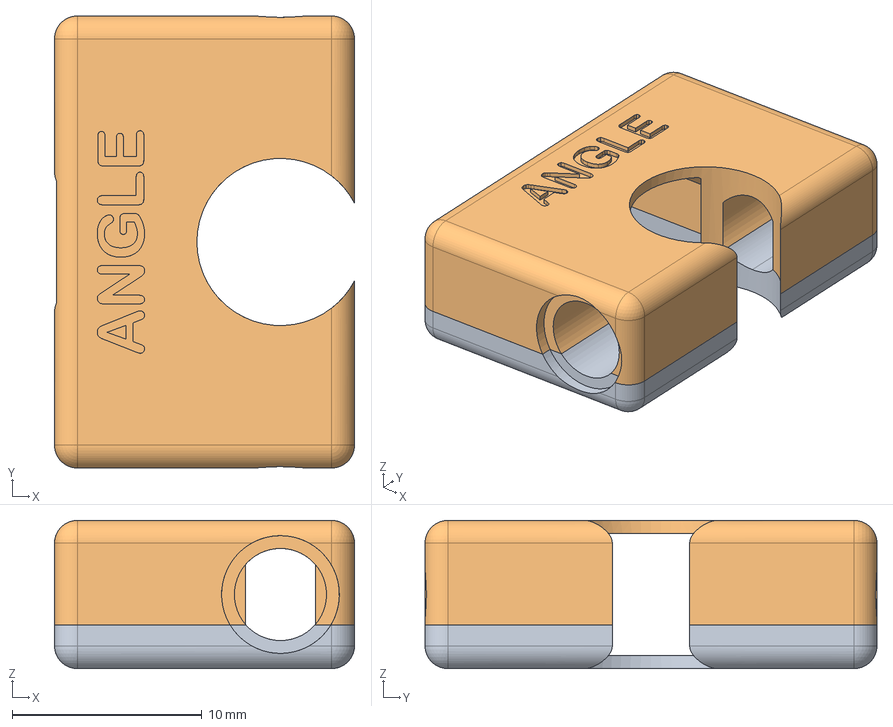
[picture p375: CAD file, 2026-10-26]
stage-1/cad/step/SB-ANGLE.step
15.8 x 23.8 x 7.80 mm
