quantrpeter/semiblock-junior/stage-2/cad/step/SB-CAM.step

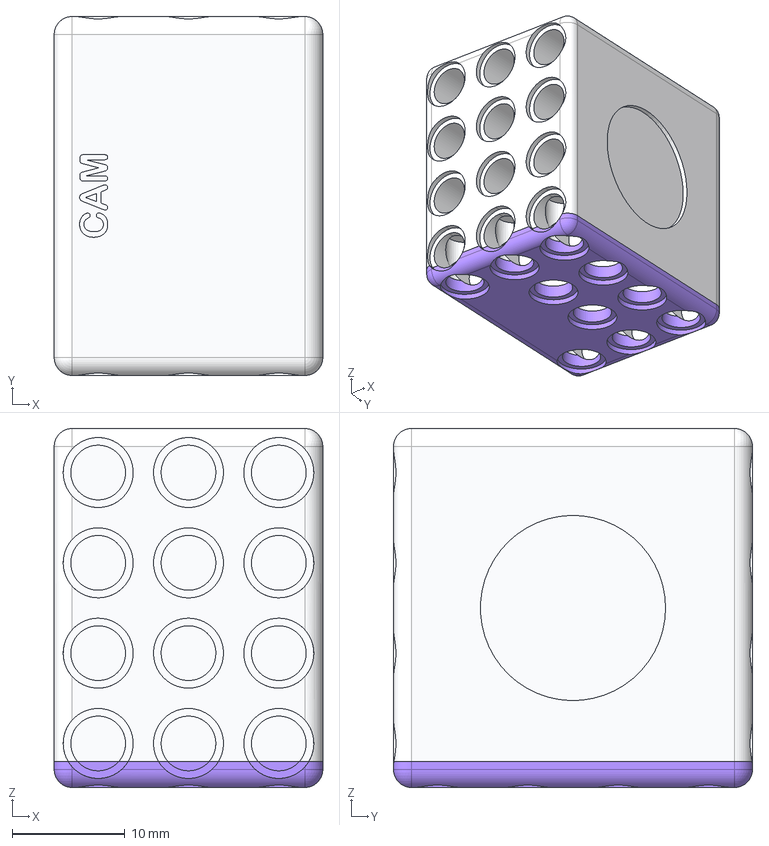
[picture p376: CAD file, 2026-10-28]
stage-2/cad/step/SB-CAM.step
23.8 x 31.8 x 31.8 mm
SB-CAM-01 base
SB-CAM-02 cover
