quantrpeter/semiblock-junior/stage-2/cad/step/SB-HUB.step

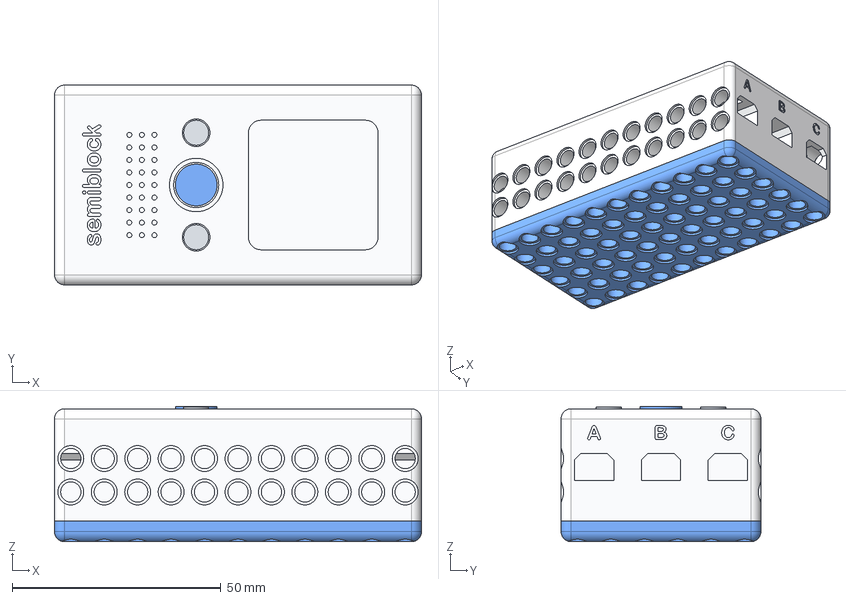
[picture p377: CAD file, 2026-10-28]
stage-2/cad/step/SB-HUB.step
87.8 x 47.8 x 32.4 mm
SB-HUB-01 base
SB-HUB-02 cover
SB-HUB-03 button_main
SB-HUB-04 button_r
SB-HUB-05 button_l
