quantrpeter/semiblock-junior/stage-2/cad/stl/SB-SV360_output.stl

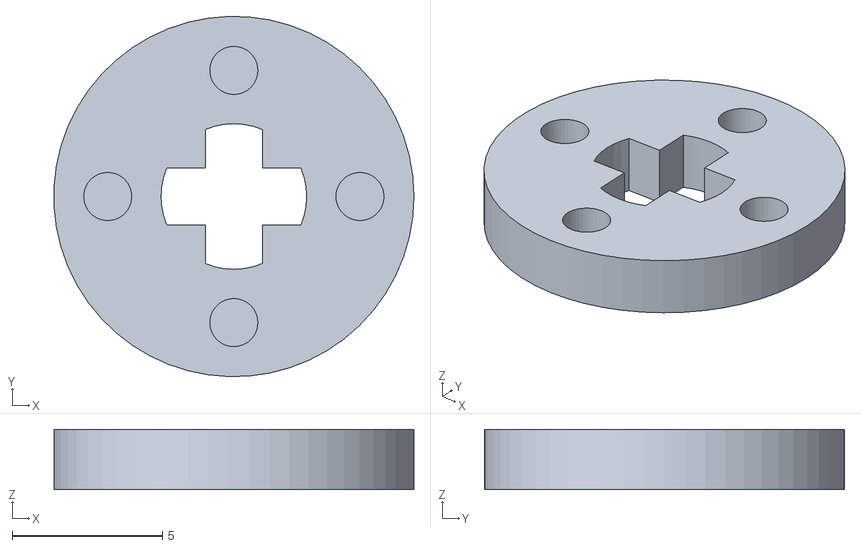
[picture p378: CAD file, 2026-10-27]
stage-2/cad/stl/SB-SV360_output.stl
12.0 x 12.0 x 2.00
