quantrpeter/semiblock-junior/stage-1/cad/step/SB-QP1.step

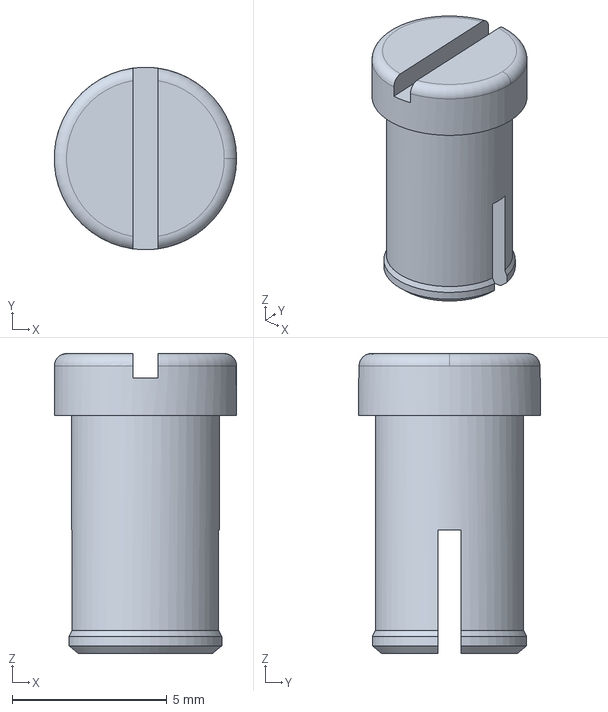
[picture p379: CAD file, 2026-10-26]
stage-1/cad/step/SB-QP1.step
5.89 x 5.90 x 9.70 mm
