quantrpeter/semiblock-junior/stage-1/cad/stl/SB-ENV_cover.stl

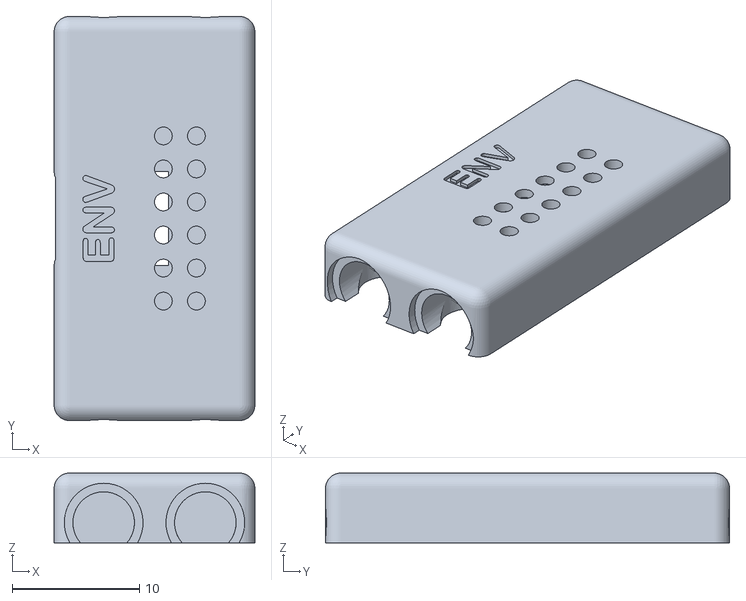
[picture p380: CAD file, 2026-10-26]
stage-1/cad/stl/SB-ENV_cover.stl
15.8 x 31.8 x 5.50
