quantrpeter/semiblock-junior/stage-2/cad/step/SB-A06.step

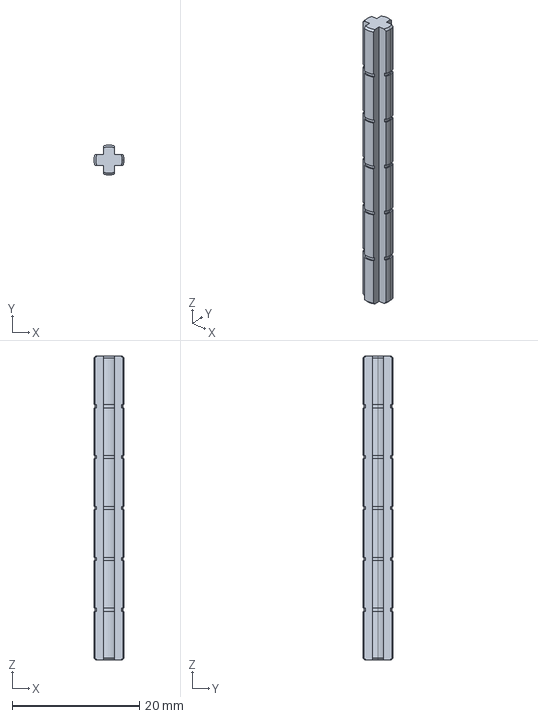
[picture p381: CAD file, 2026-10-28]
stage-2/cad/step/SB-A06.step
4.75 x 4.74 x 47.8 mm
