quantrpeter/semiblock-junior/stage-1/cad/step/SB-GR8.step

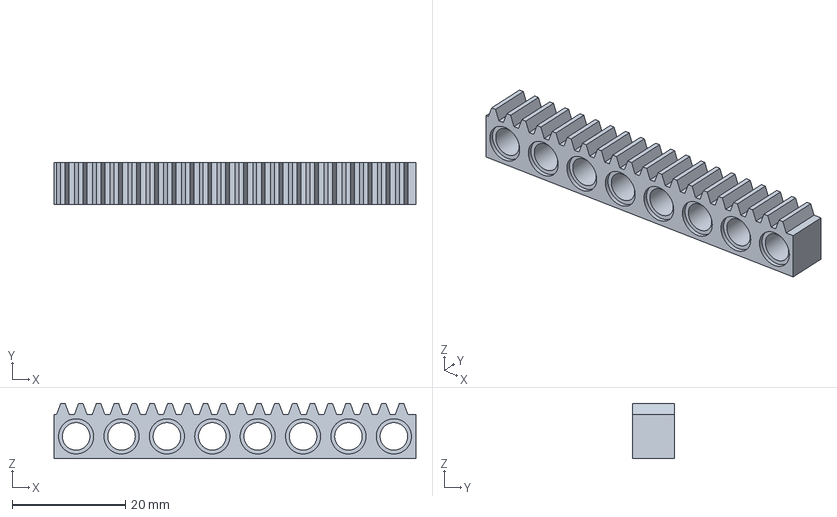
[picture p382: CAD file, 2026-10-26]
stage-1/cad/step/SB-GR8.step
63.8 x 7.40 x 9.70 mm
