quantrpeter/semiblock-junior/stage-1/cad/step/SB-XN5.step

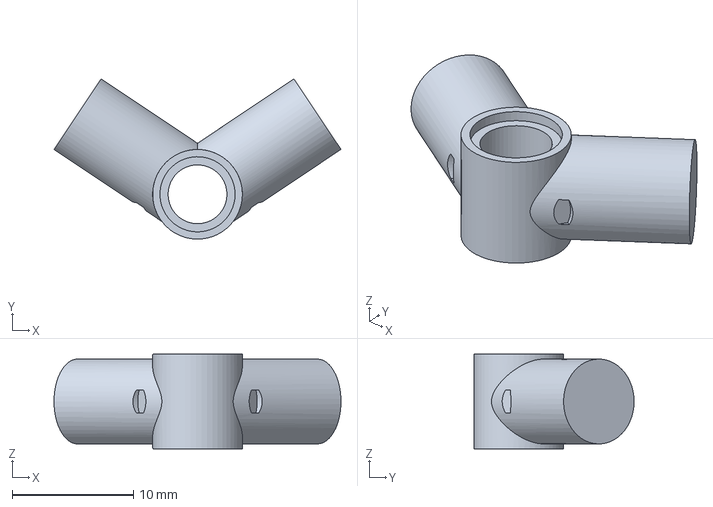
[picture p383: CAD file, 2026-10-26]
stage-1/cad/step/SB-XN5.step
23.7 x 13.2 x 7.80 mm
