quantrpeter/semiblock-junior/stage-1/cad/stl/SB-HUB_shell.stl

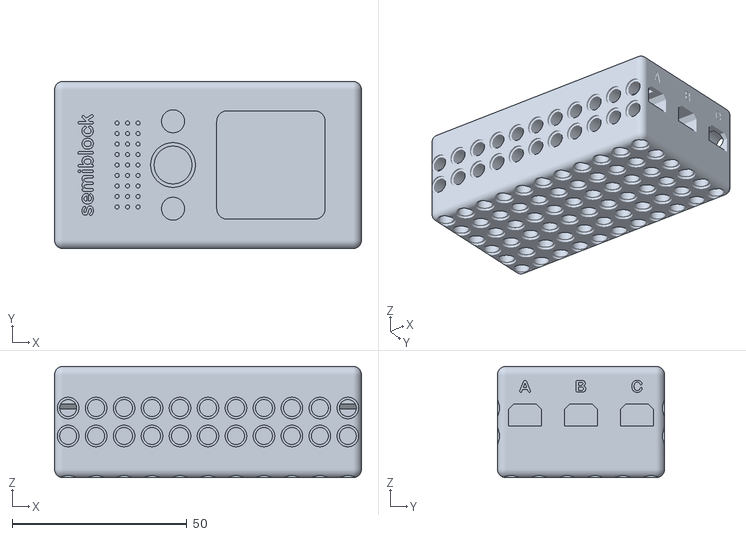
[picture p384: CAD file, 2026-10-26]
stage-1/cad/stl/SB-HUB_shell.stl
87.8 x 47.8 x 31.8
