quantrpeter/semiblock-junior/stage-1/cad/step/SB-G24.step

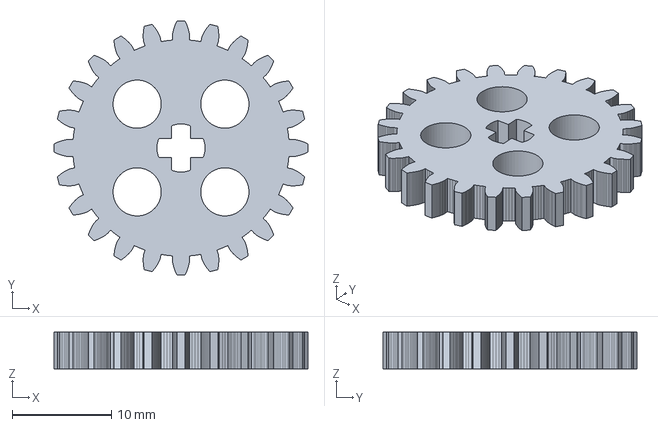
[picture p385: CAD file, 2026-10-26]
stage-1/cad/step/SB-G24.step
25.6 x 25.6 x 3.70 mm
