quantrpeter/semiblock-junior/stage-1/cad/stl/SB-SPK_cover.stl

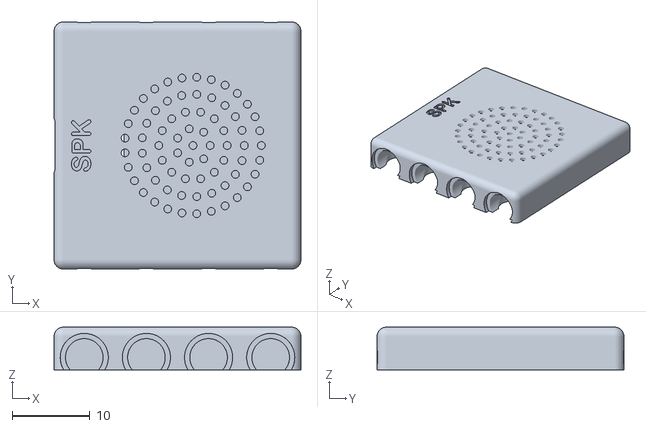
[picture p386: CAD file, 2026-10-26]
stage-1/cad/stl/SB-SPK_cover.stl
31.8 x 31.8 x 5.50
