quantrpeter/semiblock-junior/(list of files, cad)

Other CAD files:
stage-2/cad/step/SB-AIR.step
stage-2/cad/step/SB-FLAME.step
stage-2/cad/step/SB-COLOR.step
stage-2/cad/stl/SB-PROBE_base.stl
stage-2/cad/step/SB-OLED.step
stage-2/cad/stl/SB-IMU_cover.stl
stage-1/cad/stl/SB-UV_cover.stl
stage-2/cad/stl/SB-IRX_base.stl
stage-1/cad/stl/SB-FLAME_base.stl
stage-2/cad/step/SB-MAG.step
stage-1/cad/step/SB-VIB.step
stage-2/cad/step/SB-GAS.step
stage-1/cad/stl/SB-RADAR_cover.stl
stage-1/cad/step/SB-IRP.step
stage-2/cad/stl/SB-TOUCH_cover.stl
stage-2/cad/step/SB-BUMP.step
stage-1/cad/step/SB-WATER.step
stage-2/cad/step/SB-PROBE.step
stage-1/cad/stl/SB-HEART_base.stl
stage-1/cad/stl/SB-IRX_cover.stl
stage-2/cad/stl/SB-THERM_cover.stl
stage-1/cad/stl/SB-TL3_sleeve.stl
stage-1/cad/step/SB-GAS.step
stage-1/cad/stl/SB-TL2S_core.stl
stage-2/cad/stl/SB-METER_cover.stl
stage-1/cad/step/SB-AIR.step
stage-1/cad/stl/SB-EMAG_cover.stl
stage-2/cad/step/SB-BU0.step
stage-2/cad/stl/SB-WM60L_rollers.stl
stage-1/cad/stl/SB-BUMP_cover.stl
stage-2/cad/step/SB-RGB.step
stage-1/cad/step/SB-A08.step
stage-1/cad/stl/SB-PIR_base.stl
stage-2/cad/stl/SB-WATER_cover.stl
stage-2/cad/step/SB-ZONE.step
stage-2/cad/stl/SB-PROBE_cover.stl
stage-1/cad/step/SB-PX.step
stage-2/cad/stl/SB-TOF_base.stl
stage-1/cad/stl/SB-GEST_cover.stl
stage-2/cad/stl/SB-SV180_base.stl
stage-1/cad/step/SB-JOY.step
stage-1/cad/stl/SB-SWITCH_cover.stl
stage-2/cad/stl/SB-KNOCK_cover.stl
stage-1/cad/stl/SB-GAS_cover.stl
stage-2/cad/step/SB-TOF.step
stage-2/cad/step/SB-ENC.step
stage-2/cad/stl/SB-SOIL_cover.stl
stage-1/cad/fcstd/SB-A02.FCStd
stage-1/cad/fcstd/SB-A03.FCStd
stage-1/cad/fcstd/SB-A03S.FCStd
stage-1/cad/fcstd/SB-A04.FCStd
stage-1/cad/fcstd/SB-A04S.FCStd
stage-1/cad/fcstd/SB-A05.FCStd
stage-1/cad/fcstd/SB-A06.FCStd
stage-1/cad/fcstd/SB-A07.FCStd
stage-1/cad/fcstd/SB-A08.FCStd
stage-1/cad/fcstd/SB-A10.FCStd
stage-1/cad/fcstd/SB-A12.FCStd
stage-1/cad/fcstd/SB-AIR.FCStd
stage-1/cad/fcstd/SB-ANGLE.FCStd
stage-1/cad/fcstd/SB-AP2.FCStd
stage-1/cad/fcstd/SB-AP2S.FCStd
stage-1/cad/fcstd/SB-B02X.FCStd
stage-1/cad/fcstd/SB-B03.FCStd
stage-1/cad/fcstd/SB-B05.FCStd
stage-1/cad/fcstd/SB-B07.FCStd
stage-1/cad/fcstd/SB-B09.FCStd
stage-1/cad/fcstd/SB-B11.FCStd
stage-1/cad/fcstd/SB-B13.FCStd
stage-1/cad/fcstd/SB-B15.FCStd
stage-1/cad/fcstd/SB-BP.FCStd
stage-1/cad/fcstd/SB-BTN.FCStd
stage-1/cad/fcstd/SB-BU0.FCStd
stage-1/cad/fcstd/SB-BU1.FCStd
stage-1/cad/fcstd/SB-BUMP.FCStd
stage-1/cad/fcstd/SB-C111.FCStd
stage-1/cad/fcstd/SB-C121.FCStd
stage-1/cad/fcstd/SB-CAM.FCStd
stage-1/cad/fcstd/SB-CASTER.FCStd
stage-1/cad/fcstd/SB-CC.FCStd
stage-1/cad/fcstd/SB-CO2.FCStd
stage-1/cad/fcstd/SB-COLOR.FCStd
stage-1/cad/fcstd/SB-COMPASS.FCStd
stage-1/cad/fcstd/SB-EMAG.FCStd
stage-1/cad/fcstd/SB-ENC.FCStd
stage-1/cad/fcstd/SB-ENV.FCStd
stage-1/cad/fcstd/SB-F57.FCStd
stage-1/cad/fcstd/SB-FAN.FCStd
stage-1/cad/fcstd/SB-FLAME.FCStd
stage-1/cad/fcstd/SB-FORCE.FCStd
stage-1/cad/fcstd/SB-G08.FCStd
stage-1/cad/fcstd/SB-G12B.FCStd
stage-1/cad/fcstd/SB-G16.FCStd
stage-1/cad/fcstd/SB-G20B.FCStd
stage-1/cad/fcstd/SB-G24.FCStd
stage-1/cad/fcstd/SB-G24C.FCStd
stage-1/cad/fcstd/SB-G36B.FCStd
stage-1/cad/fcstd/SB-G40.FCStd
stage-1/cad/fcstd/SB-GAS.FCStd
stage-1/cad/fcstd/SB-GEST.FCStd
stage-1/cad/fcstd/SB-GPS.FCStd
stage-1/cad/fcstd/SB-GR4.FCStd
stage-1/cad/fcstd/SB-GR8.FCStd
stage-1/cad/fcstd/SB-GW.FCStd
stage-1/cad/fcstd/SB-H03.FCStd
stage-1/cad/fcstd/SB-H05.FCStd
stage-1/cad/fcstd/SB-HEART.FCStd
stage-1/cad/fcstd/SB-HUB.FCStd
stage-1/cad/fcstd/SB-IMU.FCStd
stage-1/cad/fcstd/SB-IRP.FCStd
stage-1/cad/fcstd/SB-IRT.FCStd
stage-1/cad/fcstd/SB-IRX.FCStd
stage-1/cad/fcstd/SB-JOY.FCStd
stage-1/cad/fcstd/SB-K46.FCStd
stage-1/cad/fcstd/SB-KEY.FCStd
stage-1/cad/fcstd/SB-KEYPAD.FCStd
stage-1/cad/fcstd/SB-KNOCK.FCStd
stage-1/cad/fcstd/SB-L24.FCStd
stage-1/cad/fcstd/SB-L35.FCStd
stage-1/cad/fcstd/SB-LINE.FCStd
stage-1/cad/fcstd/SB-LINK.FCStd
stage-1/cad/fcstd/SB-LOAD.FCStd
stage-1/cad/fcstd/SB-LUX.FCStd
stage-1/cad/fcstd/SB-MAG.FCStd
stage-1/cad/fcstd/SB-MATRIX.FCStd
stage-1/cad/fcstd/SB-METER.FCStd
stage-1/cad/fcstd/SB-MOT-L.FCStd
stage-1/cad/fcstd/SB-MOT-M.FCStd
stage-1/cad/fcstd/SB-N26.FCStd
stage-1/cad/fcstd/SB-OLED.FCStd
stage-1/cad/fcstd/SB-PH.FCStd
stage-1/cad/fcstd/SB-PIR.FCStd
stage-1/cad/fcstd/SB-PM.FCStd
stage-1/cad/fcstd/SB-POT.FCStd
stage-1/cad/fcstd/SB-PROBE.FCStd
stage-1/cad/fcstd/SB-PUMP.FCStd
stage-1/cad/fcstd/SB-PX.FCStd
stage-1/cad/fcstd/SB-QP1.FCStd
stage-1/cad/fcstd/SB-QP2.FCStd
stage-1/cad/fcstd/SB-QP2S.FCStd
stage-1/cad/fcstd/SB-QP3.FCStd
stage-1/cad/fcstd/SB-RADAR.FCStd
stage-1/cad/fcstd/SB-RFID.FCStd
stage-1/cad/fcstd/SB-RGB.FCStd
stage-1/cad/fcstd/SB-RING.FCStd
stage-1/cad/fcstd/SB-SEG.FCStd
stage-1/cad/fcstd/SB-SLIDE.FCStd
stage-1/cad/fcstd/SB-SOIL.FCStd
stage-1/cad/fcstd/SB-SOLAR.FCStd
stage-1/cad/fcstd/SB-SOUND.FCStd
stage-1/cad/fcstd/SB-SPK.FCStd
stage-1/cad/fcstd/SB-SV180.FCStd
stage-1/cad/fcstd/SB-SV360.FCStd
stage-1/cad/fcstd/SB-SWITCH.FCStd
stage-1/cad/fcstd/SB-T33.FCStd
stage-1/cad/fcstd/SB-TC.FCStd
stage-1/cad/fcstd/SB-TC1.FCStd
stage-1/cad/fcstd/SB-TDS.FCStd
stage-1/cad/fcstd/SB-THERM.FCStd
stage-1/cad/fcstd/SB-TL2.FCStd
stage-1/cad/fcstd/SB-TL2S.FCStd
stage-1/cad/fcstd/SB-TL3.FCStd
stage-1/cad/fcstd/SB-TL3S.FCStd
stage-1/cad/fcstd/SB-TOF.FCStd
stage-1/cad/fcstd/SB-TOUCH.FCStd
stage-1/cad/fcstd/SB-TRAFFIC.FCStd
stage-1/cad/fcstd/SB-US.FCStd
stage-1/cad/fcstd/SB-UV.FCStd
stage-1/cad/fcstd/SB-VIB.FCStd
stage-1/cad/fcstd/SB-VOICE.FCStd
stage-1/cad/fcstd/SB-W30.FCStd
stage-1/cad/fcstd/SB-W56.FCStd
stage-1/cad/fcstd/SB-WATER.FCStd
stage-1/cad/fcstd/SB-WM60L.FCStd
stage-1/cad/fcstd/SB-WM60R.FCStd
stage-1/cad/fcstd/SB-WO48.FCStd
stage-1/cad/fcstd/SB-XA2.FCStd
stage-1/cad/fcstd/SB-XC12.FCStd
stage-1/cad/fcstd/SB-XC13.FCStd
stage-1/cad/fcstd/SB-XN1.FCStd
stage-1/cad/fcstd/SB-XN2.FCStd
stage-1/cad/fcstd/SB-XN3.FCStd
stage-1/cad/fcstd/SB-XN4.FCStd
stage-1/cad/fcstd/SB-XN5.FCStd
stage-1/cad/fcstd/SB-XN6.FCStd
stage-1/cad/fcstd/SB-XP2.FCStd
stage-1/cad/fcstd/SB-ZONE.FCStd
stage-1/cad/step/SB-A02.step
stage-1/cad/step/SB-A03.step
stage-1/cad/step/SB-A03S.step
stage-1/cad/step/SB-A05.step
stage-1/cad/step/SB-A06.step
stage-1/cad/step/SB-A10.step
stage-1/cad/step/SB-A12.step
stage-1/cad/step/SB-AP2.step
stage-1/cad/step/SB-AP2S.step
stage-1/cad/step/SB-B02X.step
stage-1/cad/step/SB-B05.step
stage-1/cad/step/SB-B07.step
stage-1/cad/step/SB-B09.step
stage-1/cad/step/SB-B11.step
stage-1/cad/step/SB-B13.step
stage-1/cad/step/SB-B15.step
stage-1/cad/step/SB-BP.step
stage-1/cad/step/SB-BTN.step
stage-1/cad/step/SB-BU1.step
stage-1/cad/step/SB-BUMP.step
stage-1/cad/step/SB-C111.step
stage-1/cad/step/SB-C121.step
stage-1/cad/step/SB-CAM.step
stage-1/cad/step/SB-CASTER.step
stage-1/cad/step/SB-CC.step
stage-1/cad/step/SB-CO2.step
stage-1/cad/step/SB-COLOR.step
stage-1/cad/step/SB-COMPASS.step
stage-1/cad/step/SB-ENC.step
stage-1/cad/step/SB-ENV.step
stage-1/cad/step/SB-FLAME.step
stage-1/cad/step/SB-FORCE.step
stage-1/cad/step/SB-G08.step
stage-1/cad/step/SB-G12B.step
stage-1/cad/step/SB-G20B.step
stage-1/cad/step/SB-G24C.step
stage-1/cad/step/SB-G40.step
stage-1/cad/step/SB-GEST.step
stage-1/cad/step/SB-GPS.step
stage-1/cad/step/SB-GR4.step
stage-1/cad/step/SB-GW.step
stage-1/cad/step/SB-H03.step
stage-1/cad/step/SB-H05.step
stage-1/cad/step/SB-HEART.step
stage-1/cad/step/SB-HUB.step
stage-1/cad/step/SB-IMU.step
stage-1/cad/step/SB-IRT.step
stage-1/cad/step/SB-IRX.step
stage-1/cad/step/SB-KEY.step
stage-1/cad/step/SB-KEYPAD.step
stage-1/cad/step/SB-KNOCK.step
stage-1/cad/step/SB-L24.step
stage-1/cad/step/SB-LINE.step
stage-1/cad/step/SB-LINK.step
stage-1/cad/step/SB-LOAD.step
stage-1/cad/step/SB-LUX.step
stage-1/cad/step/SB-MAG.step
stage-1/cad/step/SB-MOT-L.step
stage-1/cad/step/SB-MOT-M.step
stage-1/cad/step/SB-N26.step
stage-1/cad/step/SB-PH.step
stage-1/cad/step/SB-PIR.step
stage-1/cad/step/SB-PM.step
stage-1/cad/step/SB-POT.step
stage-1/cad/step/SB-PROBE.step
stage-1/cad/step/SB-QP2.step
stage-1/cad/step/SB-QP2S.step
stage-1/cad/step/SB-QP3.step
stage-1/cad/step/SB-RADAR.step
stage-1/cad/step/SB-RFID.step
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
