quantrpeter/semiblock-junior/stage-2/drawings/SB-AH.pdf

35.4

### 24 Hirth face teeth 端面齿, see table 见表

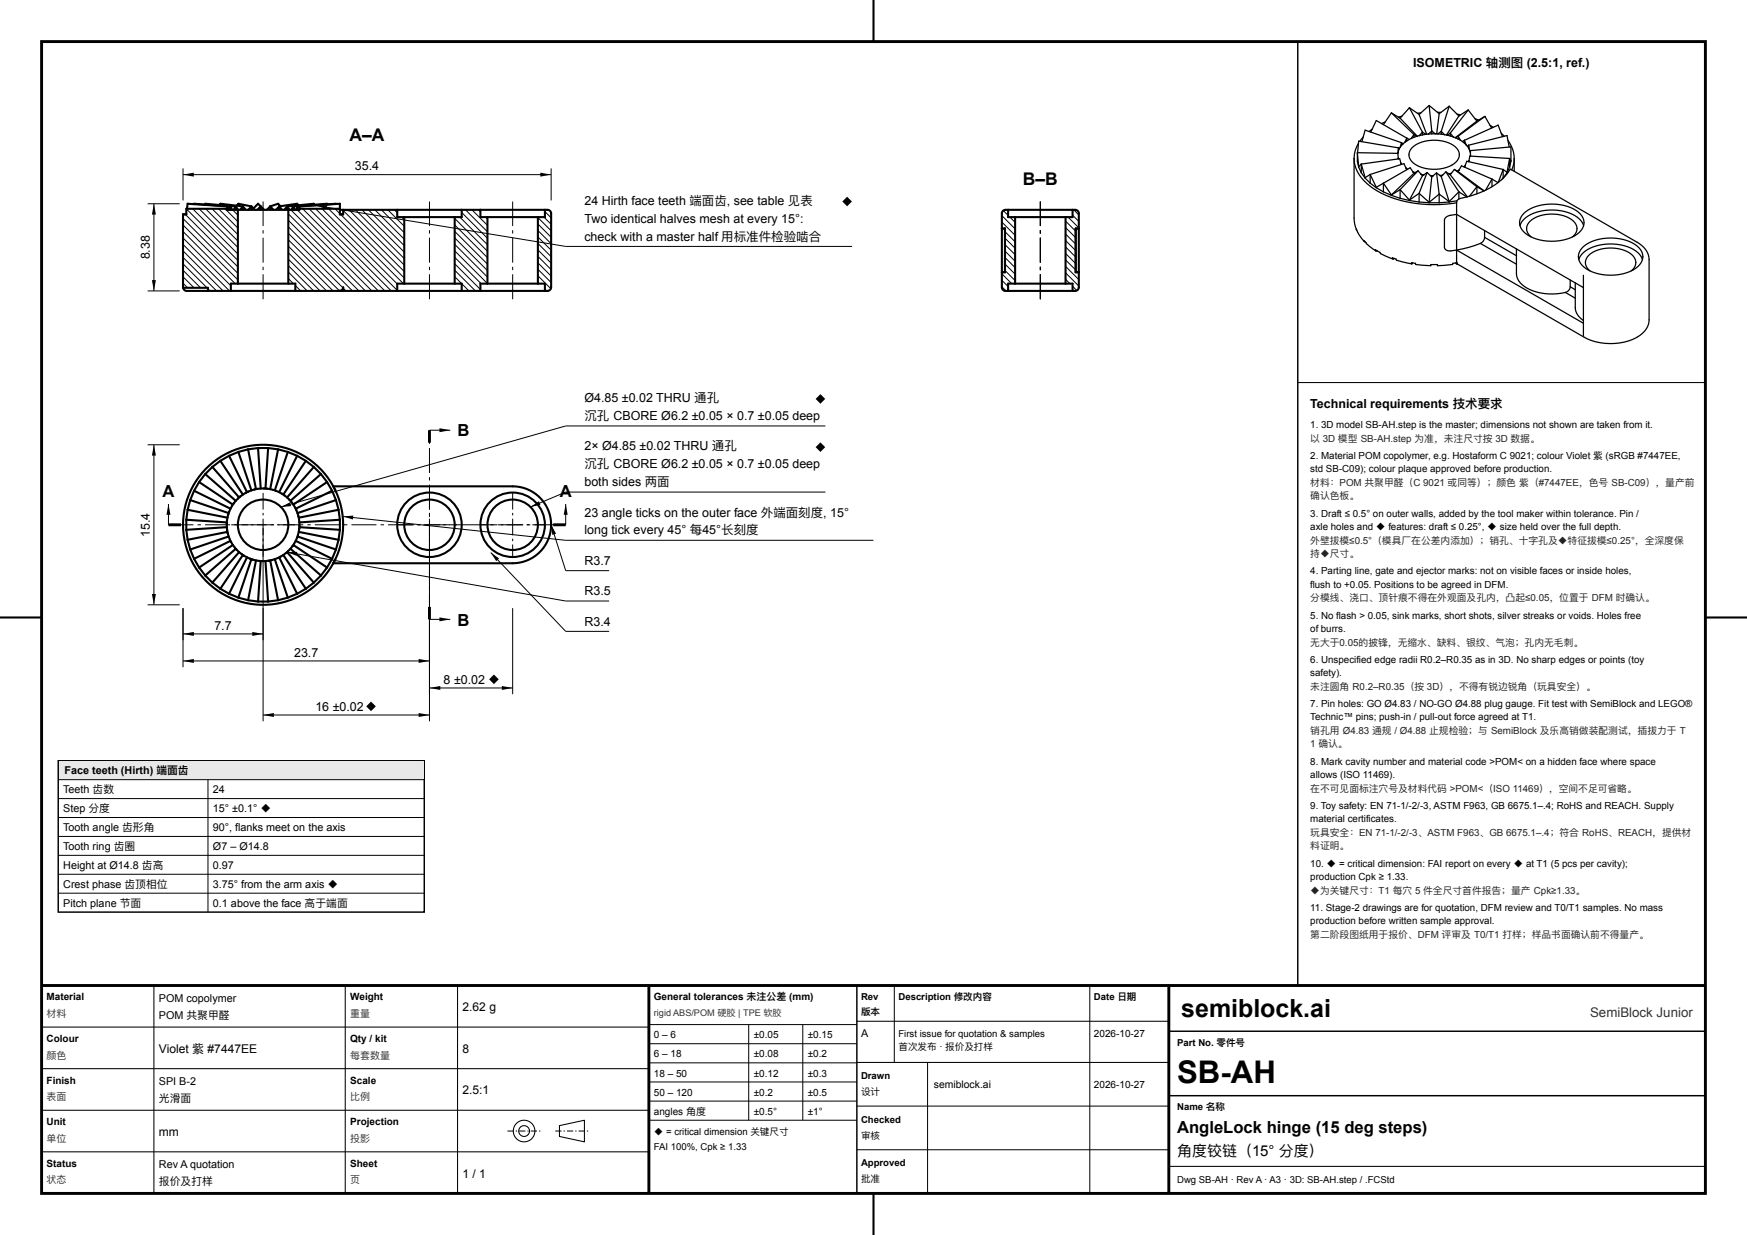
[picture p388: page 1]
Material 材料; POM copolymer POM 共聚甲醛; Weight; Colour; Violet 紫 #7447EE; Qty / kit; 每套数量; Finish 表面; SPI B-2 光滑面; Scale; Unit; Projection; Status 状态; Rev A quotation 报价及打样; Sheet; Rev 版本; Description 修改内容; Date 日期; Approved 批准; semiblock.ai; SemiBlock Junior; Teeth 齿数; Step 分度; Tooth angle 齿形角; 90°, flanks meet on the axis; Tooth ring 齿圈; Height at Ø14.8 齿高; Crest phase 齿顶相位; 3.75° from the arm axis ◆; Pitch plane 节面; 0.1 above the face 高于端面

ISOMETRIC 轴测图 (2.5:1, ref.)

Two identical halves mesh at every 15°:
check with a master half 用标准件检验啮合

Ø4.85 ±0.02 THRU 通孔
沉孔 CBORE Ø6.2 ±0.05 × 0.7 ±0.05 deep

Technical requirements 技术要求

1. 3D model SB-AH.step is the master; dimensions not shown are taken from it.
以 3D 模型 SB-AH.step 为准，未注尺寸按 3D 数据。
2. Material POM copolymer, e.g. Hostaform C 9021; colour Violet 紫 (sRGB #7447EE,
std SB-C09); colour plaque approved before production.
材料：POM 共聚甲醛（C 9021 或同等）；颜色 紫（#7447EE，色号 SB-C09），量产前
确认色板。
3. Draft ≤ 0.5° on outer walls, added by the tool maker within tolerance. Pin /
axle holes and ◆ features: draft ≤ 0.25°, ◆ size held over the full depth.
外壁拔模≤0.5°（模具厂在公差内添加）；销孔、十字孔及◆特征拔模≤0.25°，全深度保
4. Parting line, gate and ejector marks: not on visible faces or inside holes,
flush to +0.05. Positions to be agreed in DFM.
分模线、浇口、顶针痕不得在外观面及孔内，凸起≤0.05，位置于 DFM 时确认。
5. No flash > 0.05, sink marks, short shots, silver streaks or voids. Holes free
of burrs.
无大于0.05的披锋，无缩水、缺料、银纹、气泡；孔内无毛刺。
6. Unspecified edge radii R0.2–R0.35 as in 3D. No sharp edges or points (toy
safety).
未注圆角 R0.2–R0.35（按 3D），不得有锐边锐角（玩具安全）。
7. Pin holes: GO Ø4.83 / NO-GO Ø4.88 plug gauge. Fit test with SemiBlock and LEGO®
Technic™ pins; push-in / pull-out force agreed at T1.
销孔用 Ø4.83 通规 / Ø4.88 止规检验；与 SemiBlock 及乐高销做装配测试，插拔力于 T
8. Mark cavity number and material code >POM< on a hidden face where space
allows (ISO 11469).
在不可见面标注穴号及材料代码 >POM<（ISO 11469），空间不足可省略。
9. Toy safety: EN 71-1/-2/-3, ASTM F963, GB 6675.1–.4; RoHS and REACH. Supply
material certificates.
玩具安全：EN 71-1/-2/-3、ASTM F963、GB 6675.1–.4；符合 RoHS、REACH，提供材
料证明。
10. ◆ = critical dimension: FAI report on every ◆ at T1 (5 pcs per cavity);
production Cpk ≥ 1.33.
◆为关键尺寸：T1 每穴 5 件全尺寸首件报告；量产 Cpk≥1.33。
11. Stage-2 drawings are for quotation, DFM review and T0/T1 samples. No mass
production before written sample approval.
第二阶段图纸用于报价、DFM 评审及 T0/T1 打样；样品书面确认前不得量产。

2× Ø4.85 ±0.02 THRU 通孔
both sides 两面

23 angle ticks on the outer face 外端面刻度, 15°
long tick every 45° 每45°长刻度

Face teeth (Hirth) 端面齿

General tolerances 未注公差 (mm)
rigid ABS/POM 硬胶 | TPE 软胶

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

Part No. 零件号

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

Name 名称
AngleLock hinge (15 deg steps)
角度铰链（15° 分度）

Checked 审核

◆ = critical dimension 关键尺寸
FAI 100%, Cpk ≥ 1.33

Dwg SB-AH · Rev A · A3 · 3D: SB-AH.step / .FCStd
