quantrpeter/semiblock-junior/stage-2/drawings/SB-B02X.pdf

15.4

### H-section between holes 孔间工字截面

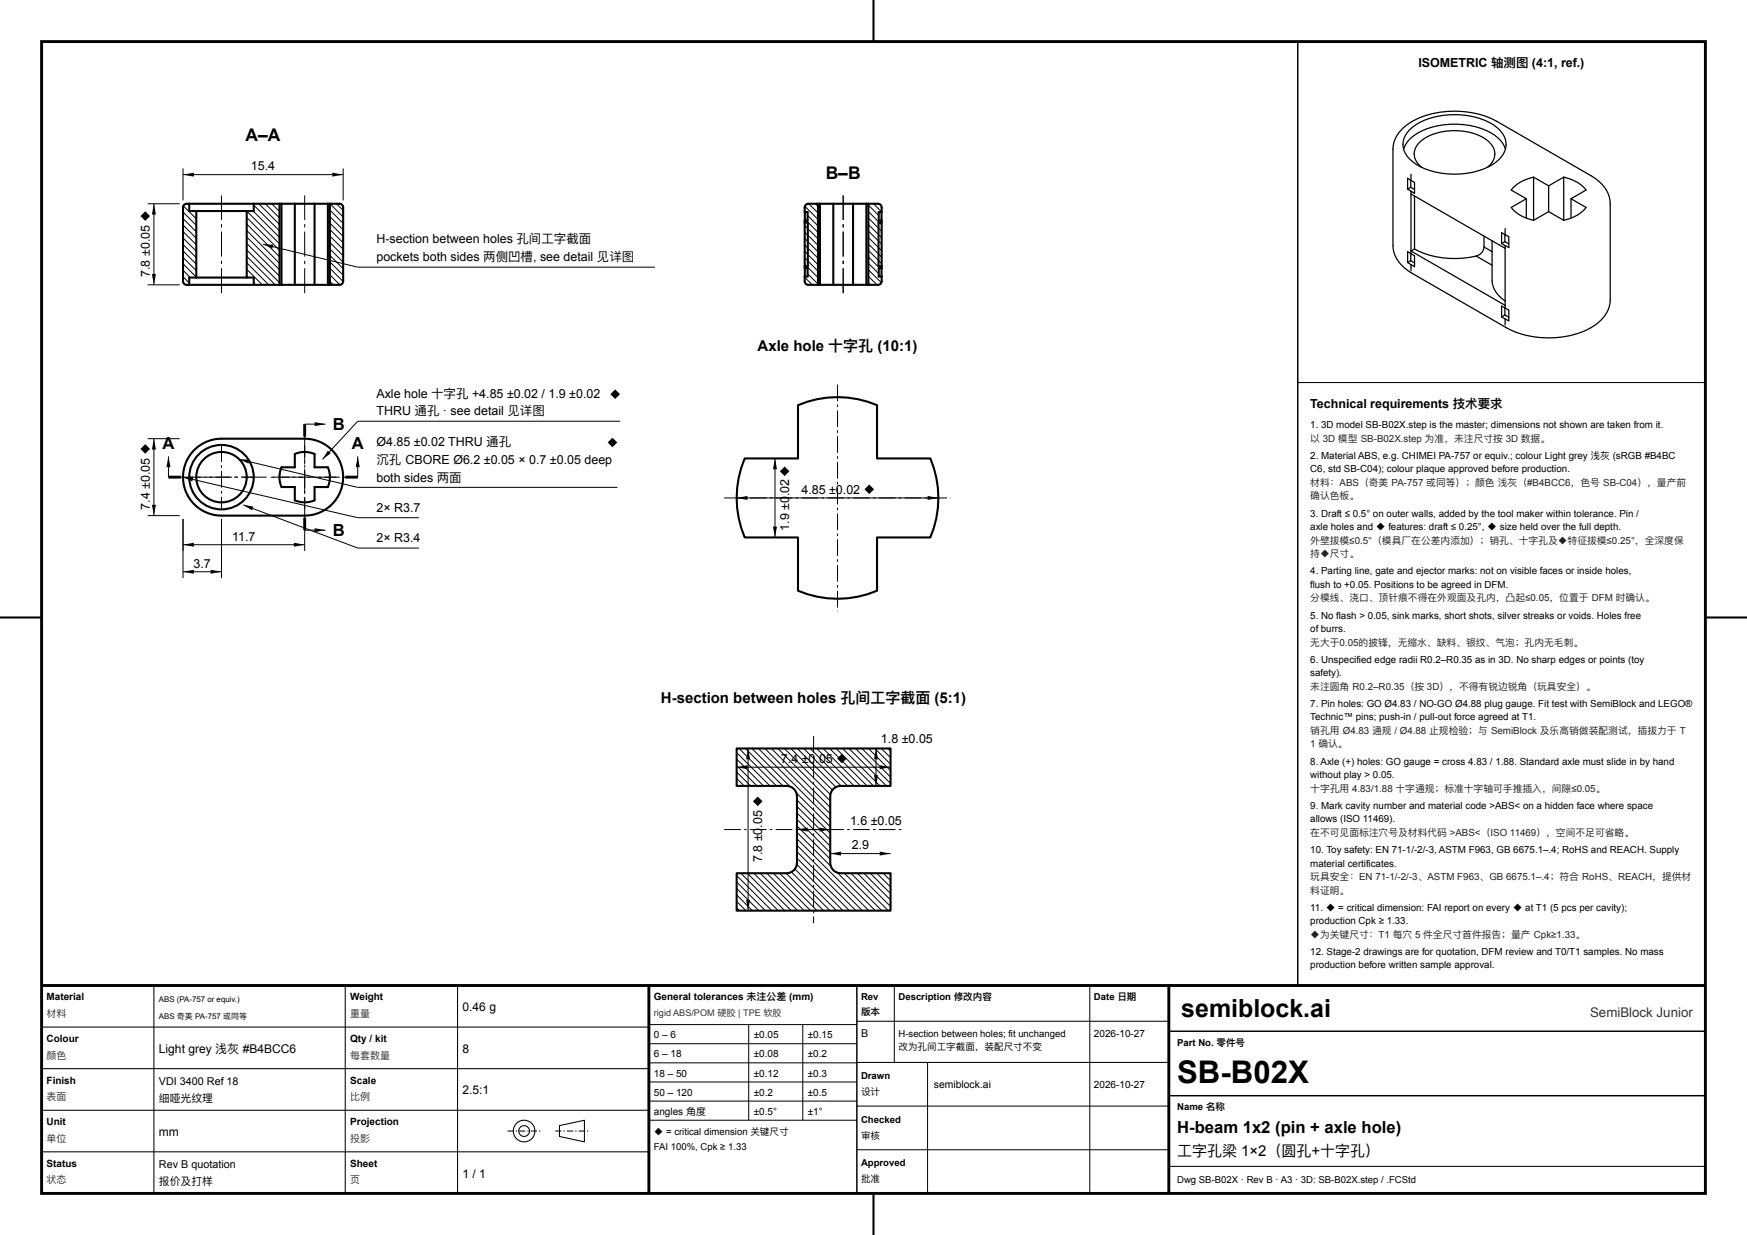
[picture p390: page 1]
Material 材料; Weight; Colour; Light grey 浅灰 #B4BCC6; Qty / kit; 每套数量; Finish 表面; VDI 3400 Ref 18 细哑光纹理; Scale; Unit; Projection; Status 状态; Rev B quotation 报价及打样; Sheet; Rev 版本; Description 修改内容; Date 日期; Approved 批准; semiblock.ai; SemiBlock Junior

ISOMETRIC 轴测图 (4:1, ref.)

pockets both sides 两侧凹槽, see detail 见详图

Axle hole 十字孔 (10:1)

Axle hole 十字孔 +4.85 ±0.02 / 1.9 ±0.02
THRU 通孔 · see detail 见详图

Technical requirements 技术要求

1. 3D model SB-B02X.step is the master; dimensions not shown are taken from it.
以 3D 模型 SB-B02X.step 为准，未注尺寸按 3D 数据。
2. Material ABS, e.g. CHIMEI PA-757 or equiv.; colour Light grey 浅灰 (sRGB #B4BC
C6, std SB-C04); colour plaque approved before production.
材料：ABS（奇美 PA-757 或同等）；颜色 浅灰（#B4BCC6，色号 SB-C04），量产前
确认色板。
3. Draft ≤ 0.5° on outer walls, added by the tool maker within tolerance. Pin /
axle holes and ◆ features: draft ≤ 0.25°, ◆ size held over the full depth.
外壁拔模≤0.5°（模具厂在公差内添加）；销孔、十字孔及◆特征拔模≤0.25°，全深度保
4. Parting line, gate and ejector marks: not on visible faces or inside holes,
flush to +0.05. Positions to be agreed in DFM.
分模线、浇口、顶针痕不得在外观面及孔内，凸起≤0.05，位置于 DFM 时确认。
5. No flash > 0.05, sink marks, short shots, silver streaks or voids. Holes free
of burrs.
无大于0.05的披锋，无缩水、缺料、银纹、气泡；孔内无毛刺。
6. Unspecified edge radii R0.2–R0.35 as in 3D. No sharp edges or points (toy
safety).
未注圆角 R0.2–R0.35（按 3D），不得有锐边锐角（玩具安全）。
7. Pin holes: GO Ø4.83 / NO-GO Ø4.88 plug gauge. Fit test with SemiBlock and LEGO®
Technic™ pins; push-in / pull-out force agreed at T1.
销孔用 Ø4.83 通规 / Ø4.88 止规检验；与 SemiBlock 及乐高销做装配测试，插拔力于 T
8. Axle (+) holes: GO gauge = cross 4.83 / 1.88. Standard axle must slide in by hand
without play > 0.05.
十字孔用 4.83/1.88 十字通规；标准十字轴可手推插入，间隙≤0.05。
9. Mark cavity number and material code >ABS< on a hidden face where space
allows (ISO 11469).
在不可见面标注穴号及材料代码 >ABS<（ISO 11469），空间不足可省略。
10. Toy safety: EN 71-1/-2/-3, ASTM F963, GB 6675.1–.4; RoHS and REACH. Supply
material certificates.
玩具安全：EN 71-1/-2/-3、ASTM F963、GB 6675.1–.4；符合 RoHS、REACH，提供材
料证明。
11. ◆ = critical dimension: FAI report on every ◆ at T1 (5 pcs per cavity);
production Cpk ≥ 1.33.
◆为关键尺寸：T1 每穴 5 件全尺寸首件报告；量产 Cpk≥1.33。
12. Stage-2 drawings are for quotation, DFM review and T0/T1 samples. No mass
production before written sample approval.

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

H-section between holes 孔间工字截面 (5:1)

General tolerances 未注公差 (mm)
rigid ABS/POM 硬胶 | TPE 软胶

ABS (PA-757 or equiv.)
ABS 奇美 PA-757 或同等

0 – 6 | ±0.05 | ±0.15 | B | H-section between holes; fit unchanged 改为孔间工字截面，装配尺寸不变 | 2026-10-27

Part No. 零件号

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

Name 名称
H-beam 1x2 (pin + axle hole)
工字孔梁 1×2（圆孔+十字孔）

Checked 审核

◆ = critical dimension 关键尺寸
FAI 100%, Cpk ≥ 1.33

Dwg SB-B02X · Rev B · A3 · 3D: SB-B02X.step / .FCStd
