quantrpeter/semiblock-junior/stage-2/drawings/SB-CASTER.pdf

47.8

A–A

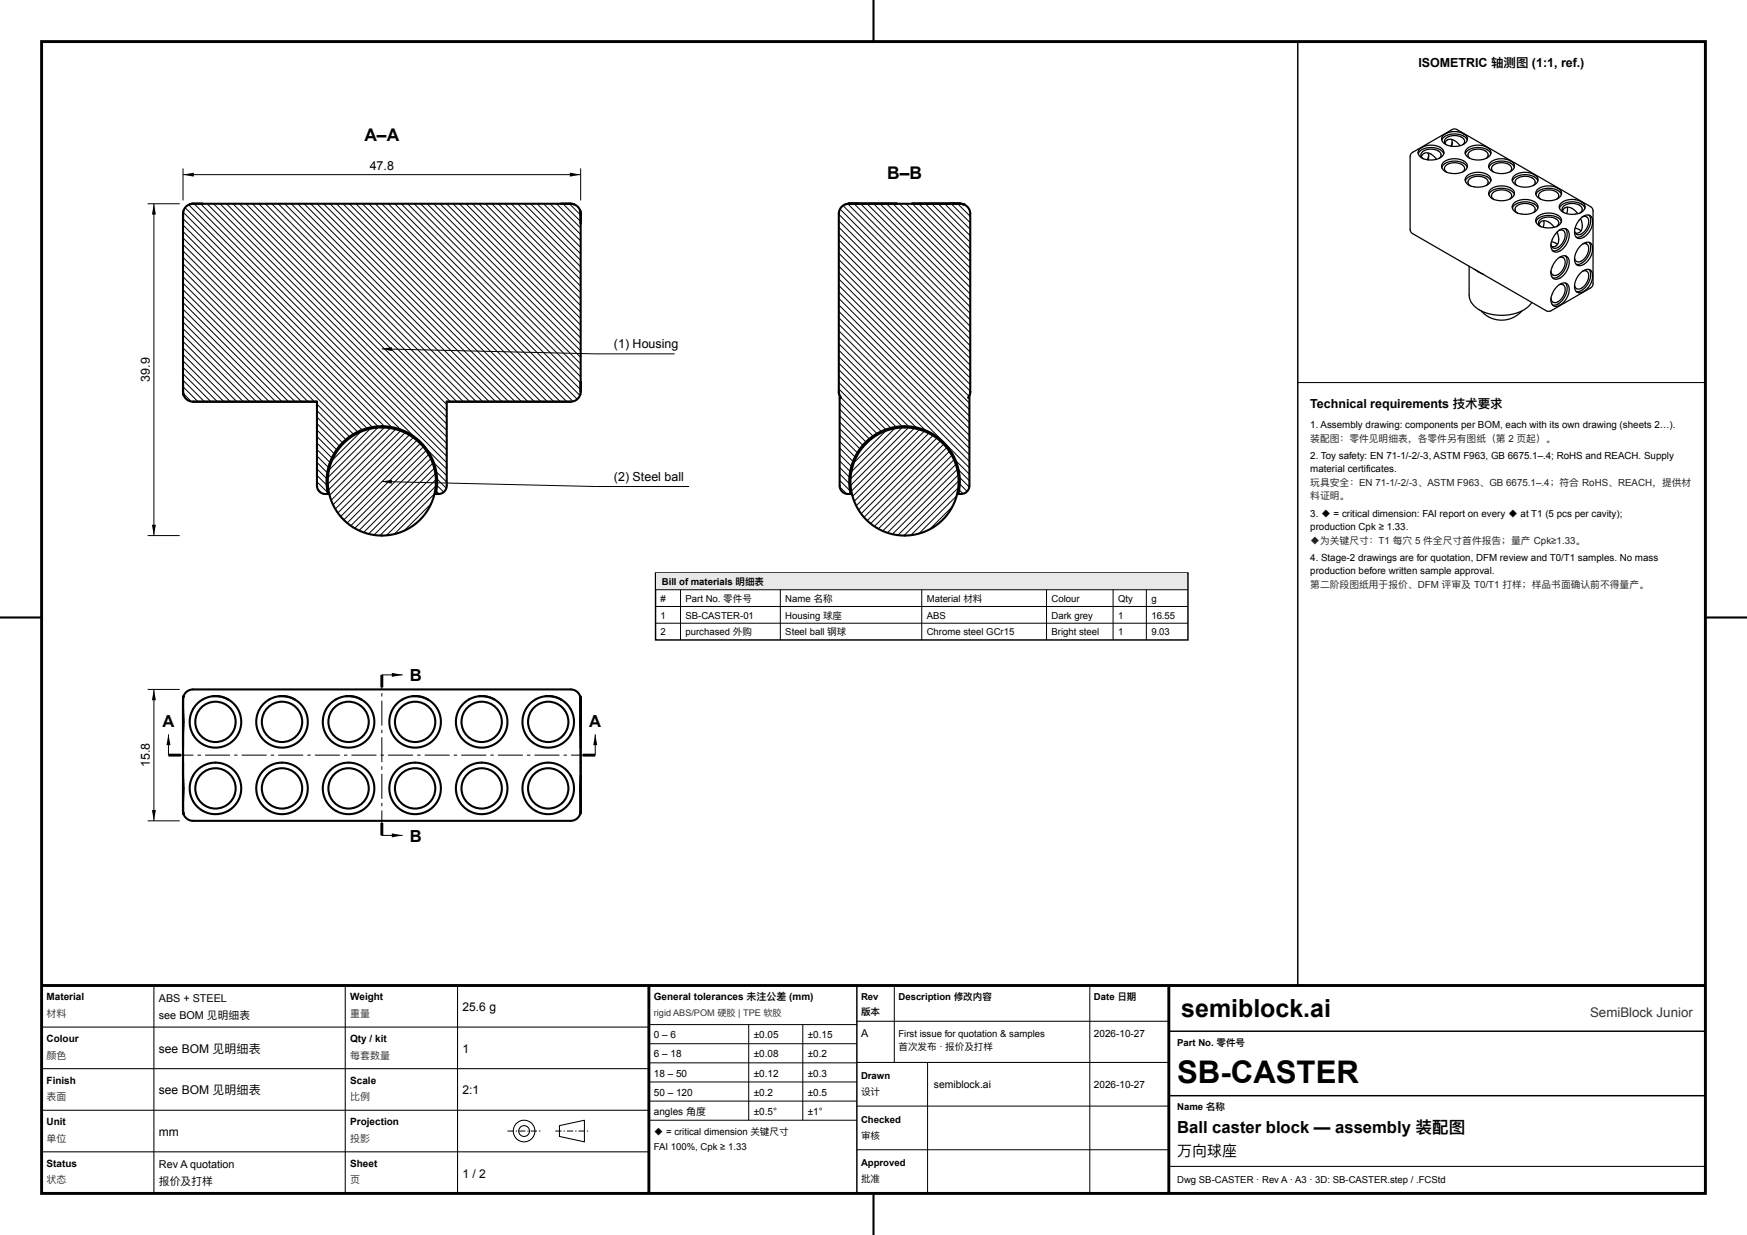
[picture p395: page 1]
Material 材料; Weight; Colour; see BOM 见明细表; Qty / kit; 每套数量; Finish; Scale; Unit; Projection; Status 状态; Rev A quotation 报价及打样; Sheet; Rev 版本; Description 修改内容; Date 日期; Approved 批准; semiblock.ai; SemiBlock Junior; SB-CASTER; (1) Housing; (2) Steel ball; Bill of materials 明细表; 第二阶段图纸用于报价、DFM 评审及 T0/T1 打样；样品书面确认前不得量产。; Part No. 零件号; Name 名称; Qty; SB-CASTER-01; Housing 球座; ABS; Dark grey; purchased 外购; Steel ball 钢球; Chrome steel GCr15; Bright steel

ISOMETRIC 轴测图 (1:1, ref.)

Technical requirements 技术要求

1. Assembly drawing: components per BOM, each with its own drawing (sheets 2…).
装配图：零件见明细表，各零件另有图纸（第 2 页起）。
2. Toy safety: EN 71-1/-2/-3, ASTM F963, GB 6675.1–.4; RoHS and REACH. Supply
material certificates.
玩具安全：EN 71-1/-2/-3、ASTM F963、GB 6675.1–.4；符合 RoHS、REACH，提供材
料证明。
3. ◆ = critical dimension: FAI report on every ◆ at T1 (5 pcs per cavity);
production Cpk ≥ 1.33.
◆为关键尺寸：T1 每穴 5 件全尺寸首件报告；量产 Cpk≥1.33。
4. Stage-2 drawings are for quotation, DFM review and T0/T1 samples. No mass
production before written sample approval.

General tolerances 未注公差 (mm)
rigid ABS/POM 硬胶 | TPE 软胶

ABS + STEEL
see BOM 见明细表

0 – 6 | ±0.05 | ±0.15 | A | First issue for quotation & samples 首次发布 · 报价及打样 | 2026-10-27

Part No. 零件号

6 – 18 | ±0.08 | ±0.2
18 – 50 | ±0.12 | ±0.3 | Drawn 设计 | semiblock.ai | 2026-10-27
50 – 120 | ±0.2 | ±0.5
angles 角度 | ±0.5° | ±1°

Name 名称
Ball caster block — assembly 装配图
万向球座

Checked 审核

◆ = critical dimension 关键尺寸
FAI 100%, Cpk ≥ 1.33

Dwg SB-CASTER · Rev A · A3 · 3D: SB-CASTER.step / .FCStd

47.8

4× R1.2

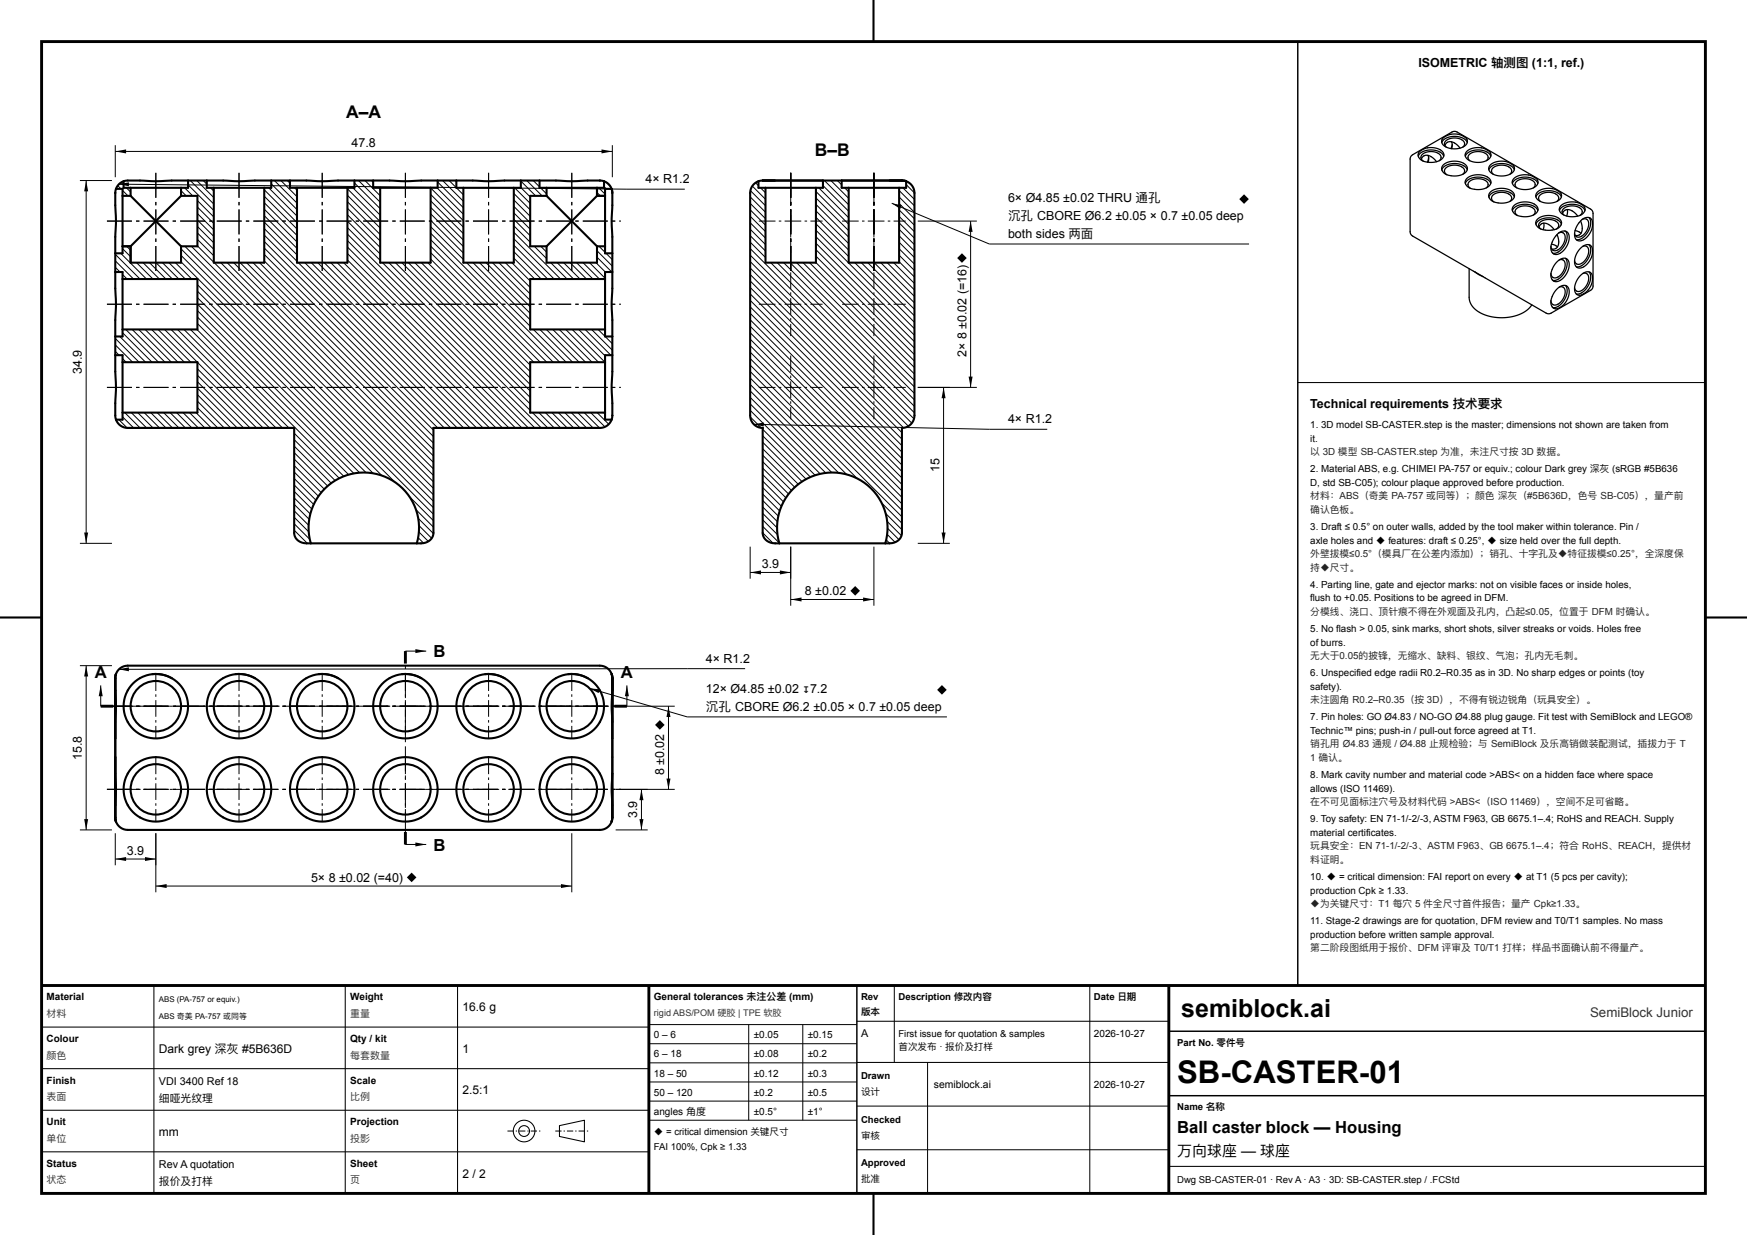
[picture p396: page 2]
Material 材料; Weight; Colour; Dark grey 深灰 #5B636D; Qty / kit; 每套数量; Finish 表面; VDI 3400 Ref 18 细哑光纹理; Scale; Unit; Projection; Status 状态; Rev A quotation 报价及打样; Sheet; Rev 版本; Description 修改内容; Date 日期; Approved 批准; semiblock.ai; SemiBlock Junior; SB-CASTER-01

ISOMETRIC 轴测图 (1:1, ref.)

6× Ø4.85 ±0.02 THRU 通孔
沉孔 CBORE Ø6.2 ±0.05 × 0.7 ±0.05 deep
both sides 两面

Technical requirements 技术要求

1. 3D model SB-CASTER.step is the master; dimensions not shown are taken from
以 3D 模型 SB-CASTER.step 为准，未注尺寸按 3D 数据。
2. Material ABS, e.g. CHIMEI PA-757 or equiv.; colour Dark grey 深灰 (sRGB #5B636
D, std SB-C05); colour plaque approved before production.
材料：ABS（奇美 PA-757 或同等）；颜色 深灰（#5B636D，色号 SB-C05），量产前
确认色板。
3. Draft ≤ 0.5° on outer walls, added by the tool maker within tolerance. Pin /
axle holes and ◆ features: draft ≤ 0.25°, ◆ size held over the full depth.
外壁拔模≤0.5°（模具厂在公差内添加）；销孔、十字孔及◆特征拔模≤0.25°，全深度保
4. Parting line, gate and ejector marks: not on visible faces or inside holes,
flush to +0.05. Positions to be agreed in DFM.
分模线、浇口、顶针痕不得在外观面及孔内，凸起≤0.05，位置于 DFM 时确认。
5. No flash > 0.05, sink marks, short shots, silver streaks or voids. Holes free
of burrs.
无大于0.05的披锋，无缩水、缺料、银纹、气泡；孔内无毛刺。
6. Unspecified edge radii R0.2–R0.35 as in 3D. No sharp edges or points (toy
safety).
未注圆角 R0.2–R0.35（按 3D），不得有锐边锐角（玩具安全）。
7. Pin holes: GO Ø4.83 / NO-GO Ø4.88 plug gauge. Fit test with SemiBlock and LEGO®
Technic™ pins; push-in / pull-out force agreed at T1.
销孔用 Ø4.83 通规 / Ø4.88 止规检验；与 SemiBlock 及乐高销做装配测试，插拔力于 T
8. Mark cavity number and material code >ABS< on a hidden face where space
allows (ISO 11469).
在不可见面标注穴号及材料代码 >ABS<（ISO 11469），空间不足可省略。
9. Toy safety: EN 71-1/-2/-3, ASTM F963, GB 6675.1–.4; RoHS and REACH. Supply
material certificates.
玩具安全：EN 71-1/-2/-3、ASTM F963、GB 6675.1–.4；符合 RoHS、REACH，提供材
料证明。
10. ◆ = critical dimension: FAI report on every ◆ at T1 (5 pcs per cavity);
production Cpk ≥ 1.33.
◆为关键尺寸：T1 每穴 5 件全尺寸首件报告；量产 Cpk≥1.33。
11. Stage-2 drawings are for quotation, DFM review and T0/T1 samples. No mass
production before written sample approval.
第二阶段图纸用于报价、DFM 评审及 T0/T1 打样；样品书面确认前不得量产。

General tolerances 未注公差 (mm)
rigid ABS/POM 硬胶 | TPE 软胶

ABS (PA-757 or equiv.)
ABS 奇美 PA-757 或同等

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

Part No. 零件号

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

Name 名称
Ball caster block — Housing
万向球座 — 球座

Checked 审核

◆ = critical dimension 关键尺寸
FAI 100%, Cpk ≥ 1.33

Dwg SB-CASTER-01 · Rev A · A3 · 3D: SB-CASTER.step / .FCStd
